girishji/tmr-keyboard/README.md

# tmr-keyboard
Custom keyboard based on TMR sensor
