girishji/tmr-keyboard/hardware/resources/Kailh-CPG1353C01D01-03.pdf

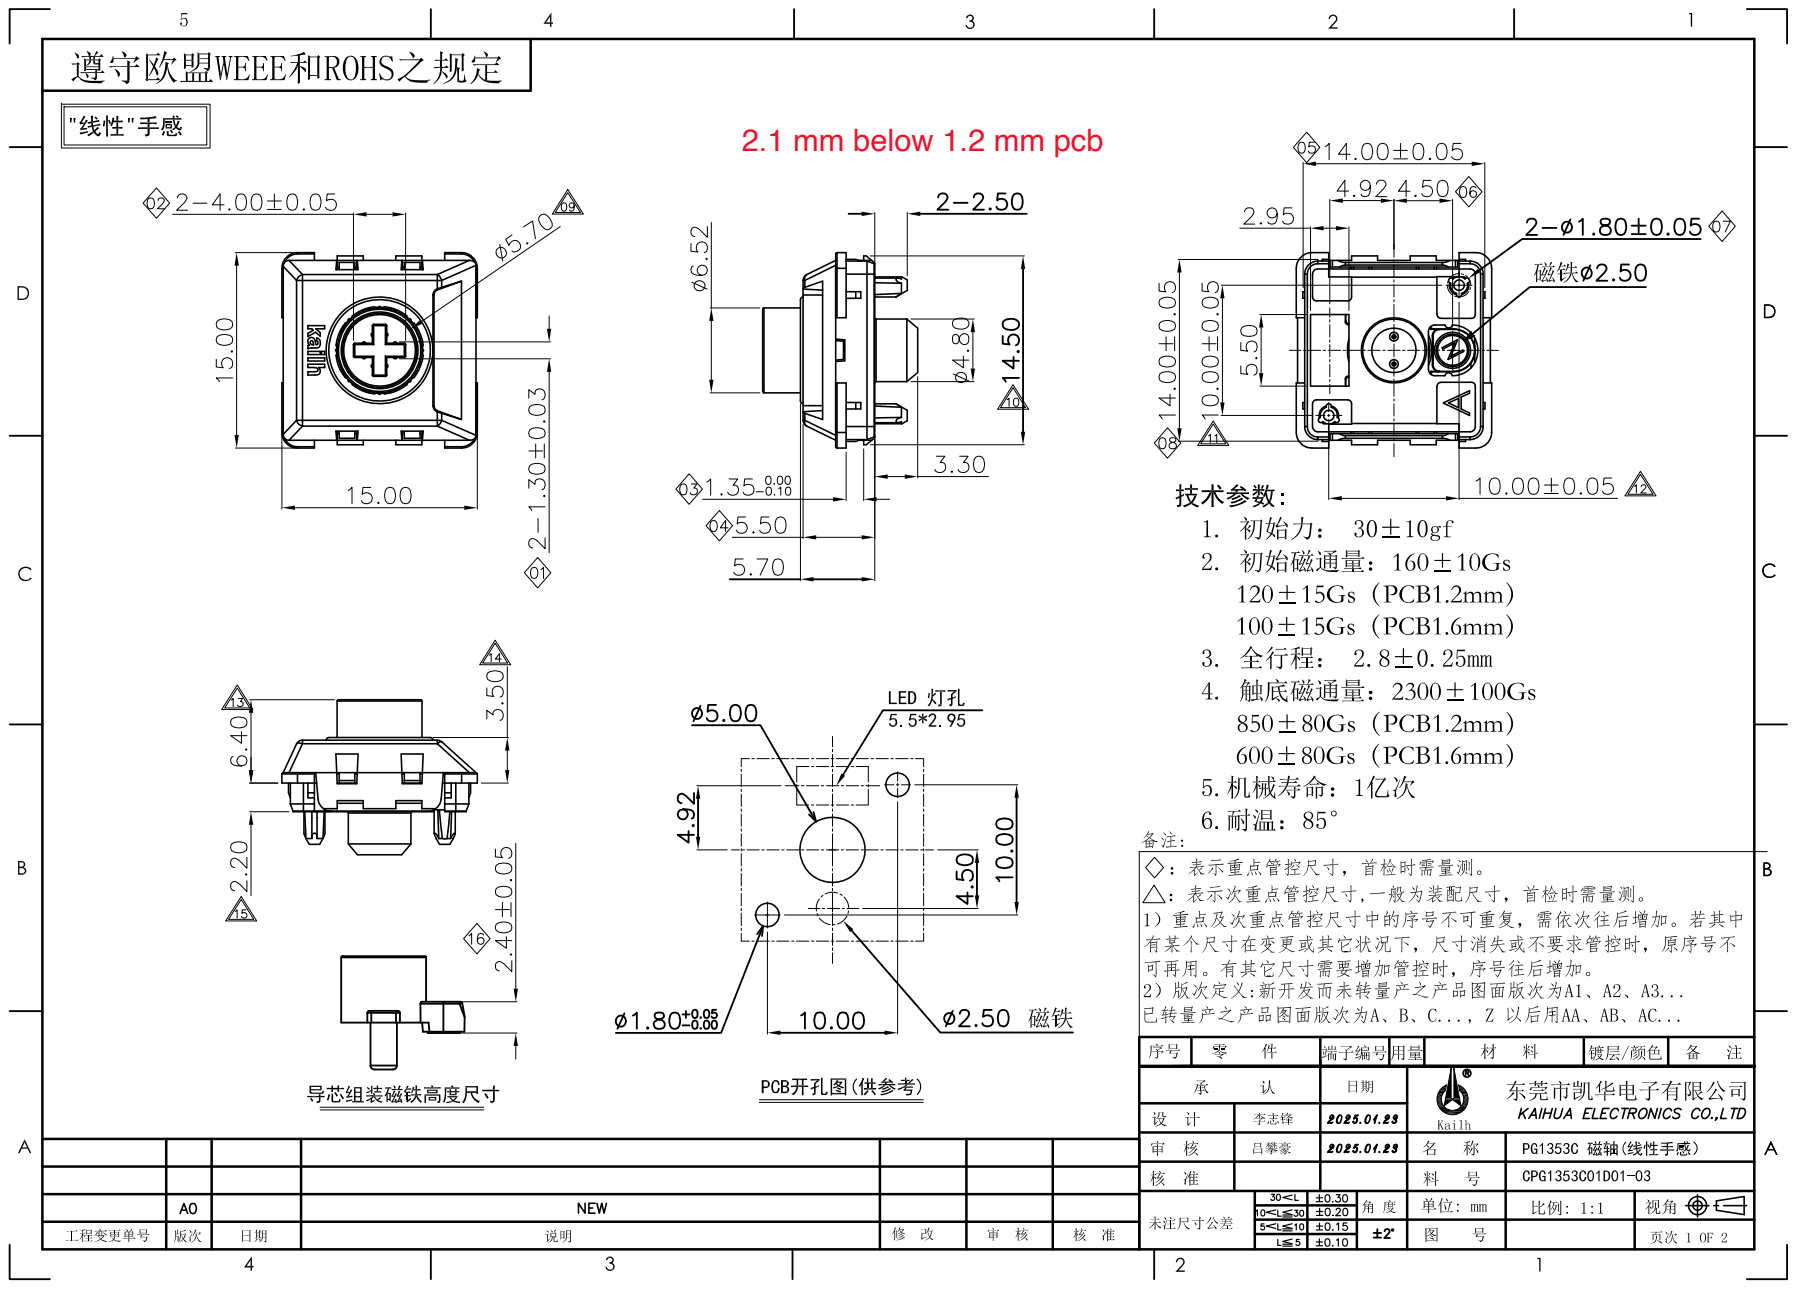
[picture p1: page 1]

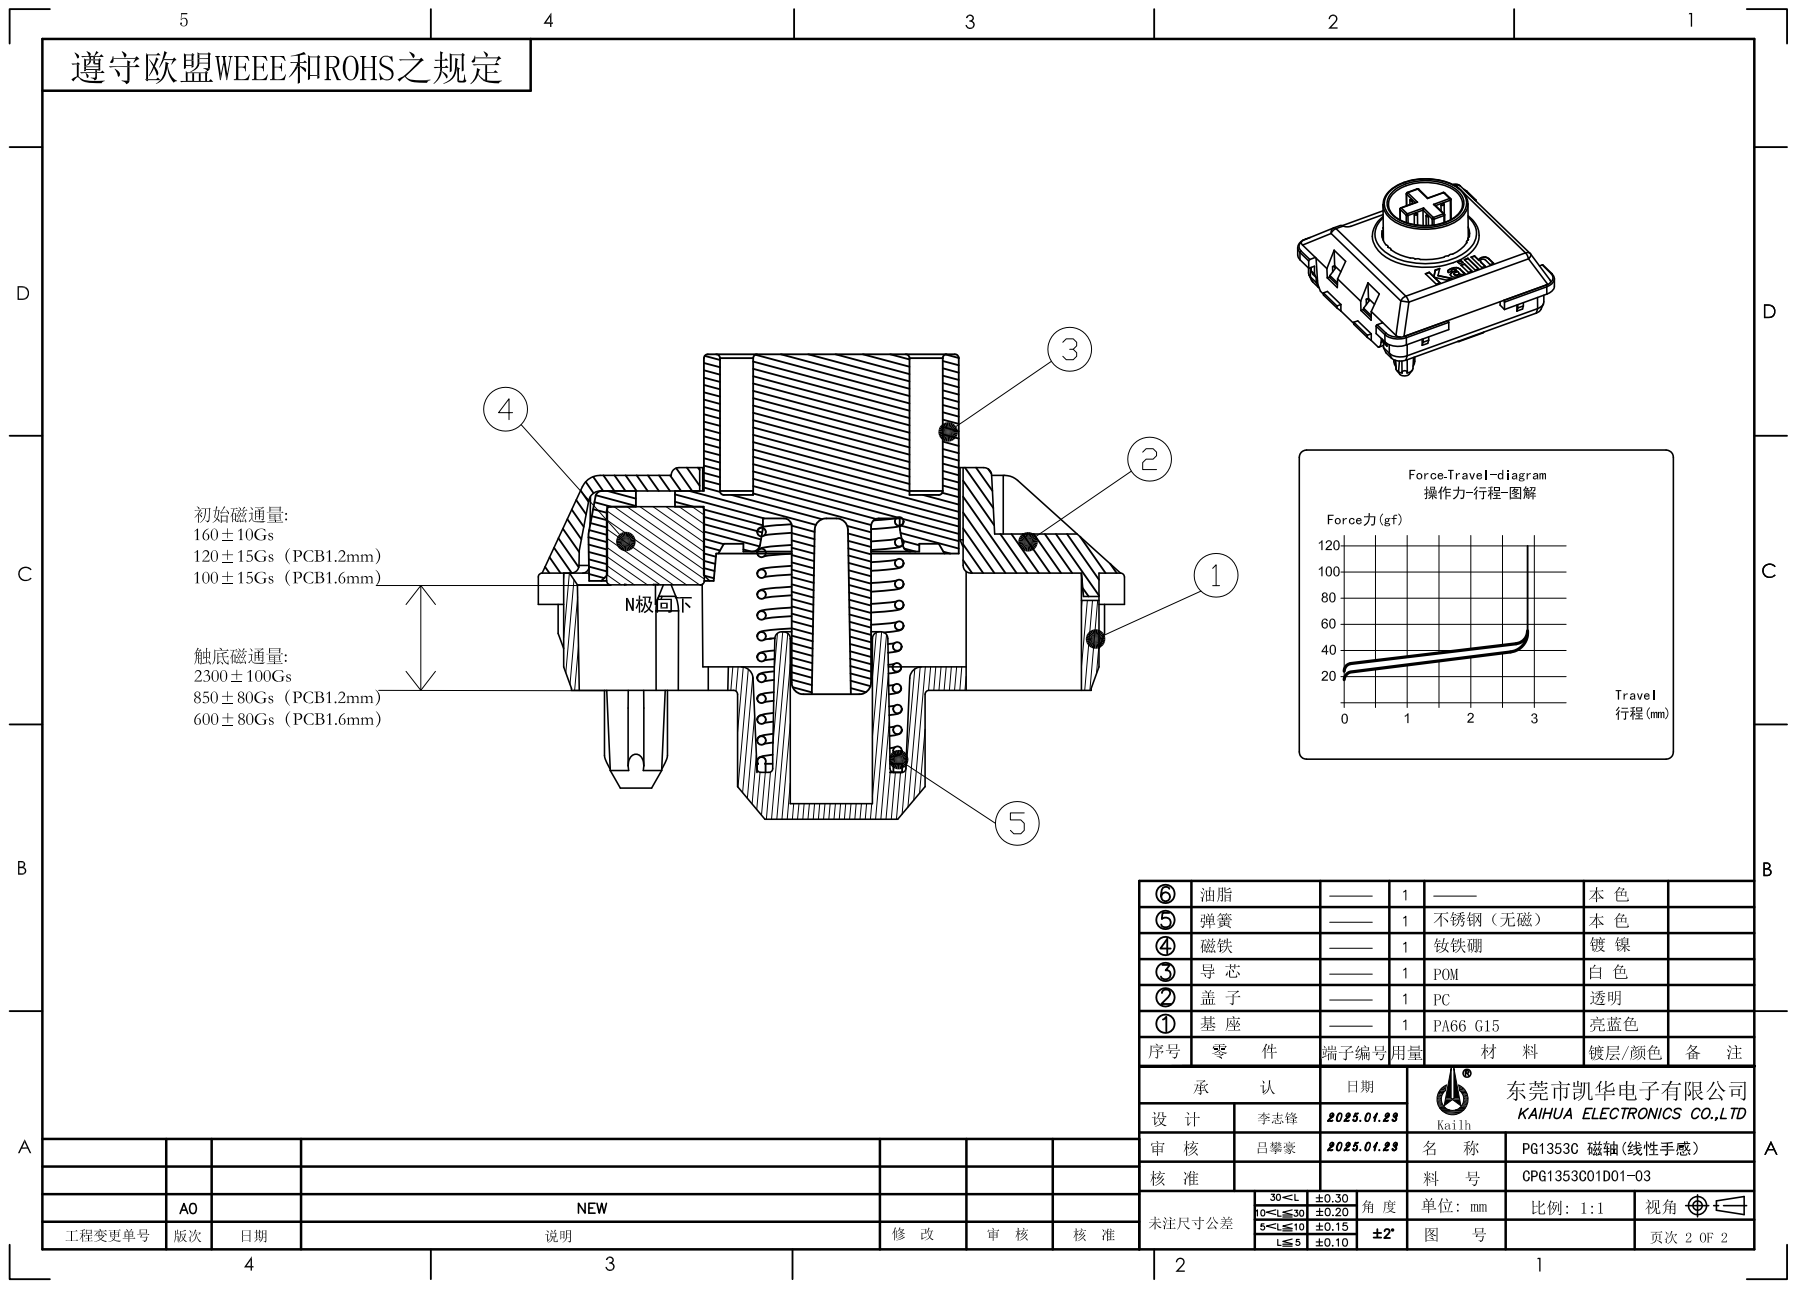
[picture p2: page 2]

## PG1353C Push Switch 料号: CPG1353C01D01-03

1. General specification 基本事项
1.1 Switch action | : Push-on type S. P. S. T
开关种类 | : 按键开关
1.2 Operation temperature range 使用温度试验范围 : - 40℃ ～ +70℃
1.3 Storage temperature range 保存温度范围 | : - 40℃ ～ + 80℃
1.4 Suggested storage period 贮存期限 : about 6 months 最多六个月
1.5 Appearance and dimensions 外形及尺寸 | : See outside drawing page 见外形尺寸图
1.6 Standard condition | Unless otherwise specified, the test and measurements shall be
试验、测定状态 | carried out as follows:
Ambient temperature 温 度: 20±2℃
Ｒelative humidity 相对湿度: 45% ～ 85%
Air pressure 气 压: 86 ～ 106kPa(860～1060mbar)
However, if doubt arises on the decision based on the measured
Values under the above-mentioned conditions, the following conditions shall be employed: 但是在对判定产生疑义时,按下述状态实施:
Ambient temperature 温 度:20±2℃ | Relative humidity 相对湿度: 65±5％
Air pressure 气 压: 86 ～ 106kPa(860～1060mbar)
2. Performance 性能
2.1 Mechanical Characteristics 机械性能
No. | Item 项目 | Test condition 试验条件 | Performance 规格

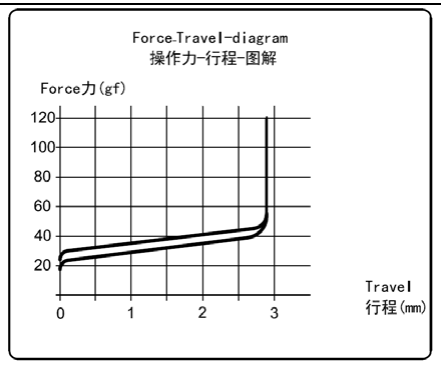
[picture p3: figure]

2.1.1 | Initial force 初始力 Travel to closure 动作行程（见 图表） | | Initial force 初始力 30±10gf Full Travel: 2.8mm±0.25 Initial magnetic induction: 自由状态磁感应强度: 120±15Gs（PCB1.2mm） 100±15Gs（PCB1.6mm） Push to full magnetic induction: 按压到全行程状态磁感应强 度: 850±80Gs（PCB1.2mm） 600±80Gs（PCB1.6mm）
2.1.2 | Push strength 按压强度 | 10N(1Kgf)for 15 sec 10N(1Kgf) 15 秒 | No damage (Electricaland mechanical) 无异常(电气、机械性能)
2.1.3 | Pull strength 拉拔强度 | Break by drawing push plate in the direction of right diagram 抽拔推杆使其破坏的强度. | 30N min (3kgf min)

2.2 Climatic characteristics 耐候性能
No. | Item 项目 | Test condition 试验条件 | Performance 规格
2.2.1 | Cold test 耐寒性 | 1) Temperature : - 40±2℃ 温度：- 40±2℃ 2) Duration of test: 48h 持续时间：48 小时 3) Take off a drop water 去掉水珠 4) Standard conditions after test : 1h 试验后的放置条件：1 小时 | No damage (Electricaland mechanical) 无异常(电气、机械性能)
2.2.2 | Heat test 耐热性 | 1) Temperature : 70±2℃ 温度： 70±2℃ 2) Duration of test: 48h 持续时间：48 小时 3) Standard conditions after test : 1h 试验后的放置条件：1 小时 | No damage (Electricaland mechanical) 无异常(电气、机械性能)
2.2.3 | Temperature cycle 温度循环 | 1) Test cycles :20 cycles 试验周期：20 个周期 2) Standard condition after test :1h 试验后的放置条件：1 小时 | No damage (Electricaland mechanical) 无异常(电气、机械性能)
| temperature 温度 | duration of test 持续时间
1 cycle 一次 循环 | 20±5℃ | 1h
| -40±2℃ | 1h
| 20±5℃ | 1h
| 60±5℃ | 1h
2.2.4 | Humidity test 耐湿性
1) Temperature : 70±2℃
温度：70±2℃
2) relative humidity: 90~95% 相对湿度:90~95%
3) Duration of test: 96h
持续时间：96 小时
3) Take off a drop water
去掉水珠
5) Standard conditions after test : 1h 试验后的放置条件：1 小时

No damage
(Electricaland
mechanical)
无异常(电气、机械性能)).

No. | Item 项目 | Test condition试验条件 | Performance 规格
2.2.5 | Endurance (switching action) 耐久特性 （开关寿命） | 1) Operation speed :10 times / s 动作速度：10 次/ 秒 2) Push force : 250gf±50gf （spring） 按力: 250gf±50gf（弹簧） 3) Operation number:100,000,000cycles 动作次数:100，000，000次 | No damage (Electricaland mechanical) 无异常(电气、机械性能)
2.2.6 | 盐雾实验 Salt Mist Test | 试件在下述实验后测量： 1．温度：35±5ºC 2．盐溶液浓度：5±1%（质量百分比）， 3．试验时间：24±0.5 小时， 4．试验后，将盐沉积物用水冲掉。 The switch shall be checked after following test: 1.Temperature: 35±5ºC 2.Salt solution: 5±1%(Solids by mass) 3.Duration: 24±0.5 hours, 4.After immersing, salt deposit shall be removed by running water. | No damage (Electricaland mechanical) 无异常(电气、机械性能)
2.2.7 | Shock 耐冲击性 | Measure after test at a condition below 在下列条件下进行测试后的量度 Peak acceleration:80G 冲击加速度:80G Test time-6direction ,each 3 times total 18 times 测试次数-6 个方向，各3 次共计18 次。 | No damage (Electricaland mechanical) 无异常(电气、机械性能)
