girishji/tmr-keyboard/hardware/nRF54L15_kailh/pcb/pcb-F_Fab.dxf

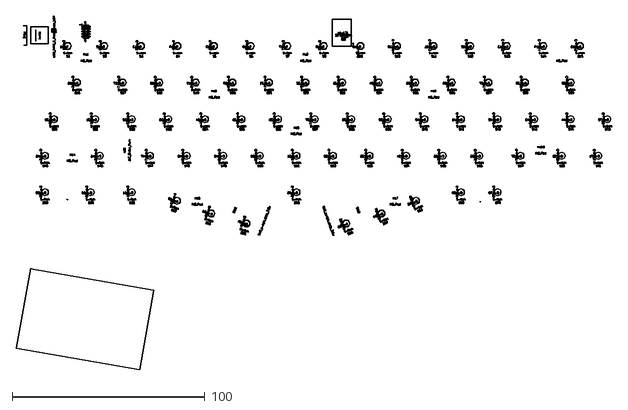
[picture p4: CAD file, 2026-02-25]
hardware/nRF54L15_kailh/pcb/pcb-F_Fab.dxf
309.1 x 183.6
