girishji/tmr-keyboard/ver2/pcb/dxf/pcb-Edge_Cuts.dxf

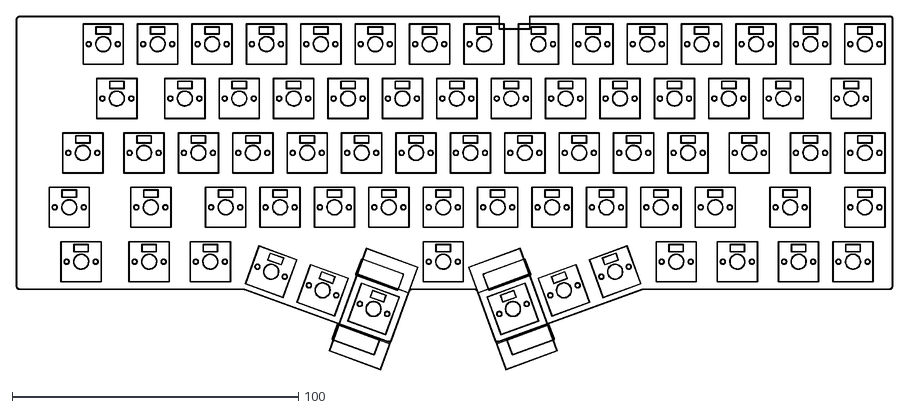
[picture p5: CAD file, 2026-01-05]
ver2/pcb/dxf/pcb-Edge_Cuts.dxf
305.9 x 123.3
