girishji/tmr-keyboard/hardware/nRF54L15_kailh/pcb/pcb-User_5.dxf

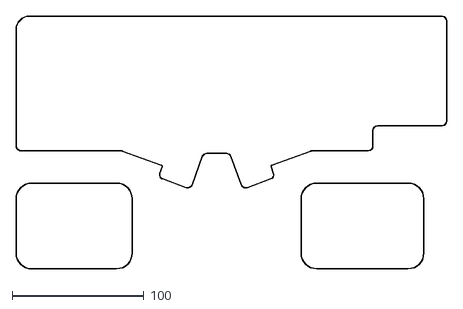
[picture p6: CAD file, 2026-02-15]
hardware/nRF54L15_kailh/pcb/pcb-User_5.dxf
326.5 x 191.5
