girishji/tmr-keyboard/hardware/nRF54L15_kailh/pcb/pcb-User_6.dxf

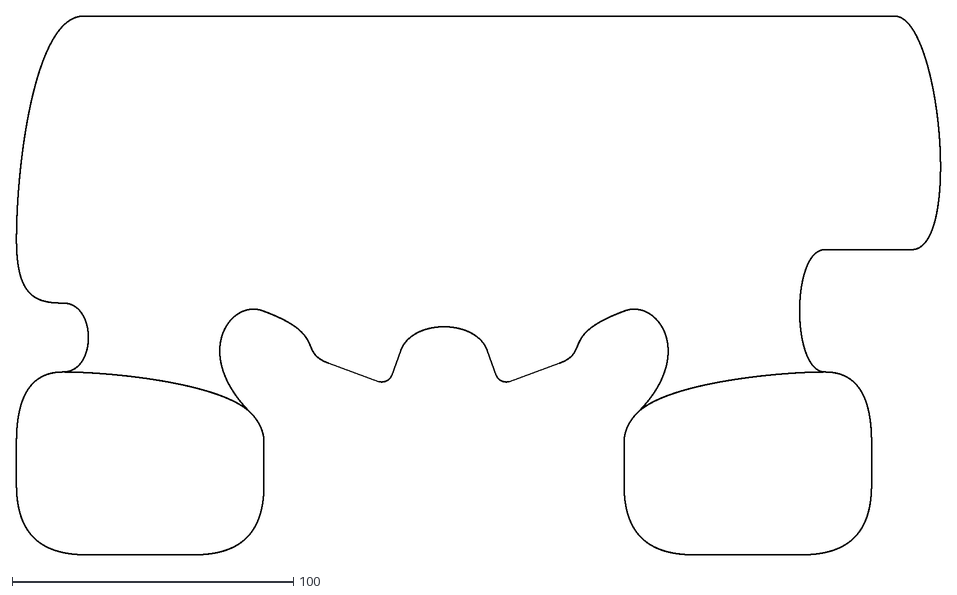
[picture p7: CAD file, 2026-02-15]
hardware/nRF54L15_kailh/pcb/pcb-User_6.dxf
328.5 x 191.5
