girishji/tmr-keyboard/hardware/nRF54L15_kailh/pcb/pcb-User_3.dxf

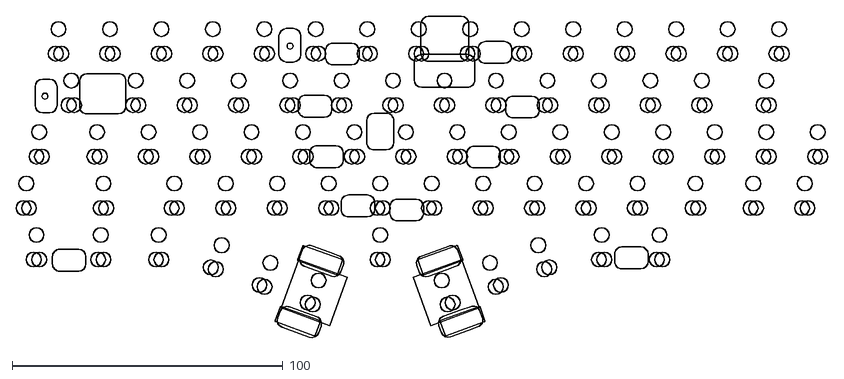
[picture p8: CAD file, 2026-02-15]
hardware/nRF54L15_kailh/pcb/pcb-User_3.dxf
299.6 x 118.9
