girishji/tmr-keyboard/hardware/nRF54L15_kailh/pcb/pcb-Edge_Cuts.dxf

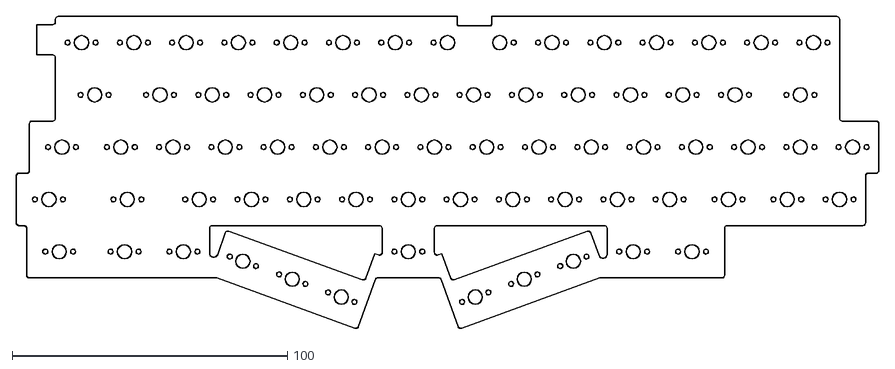
[picture p9: CAD file, 2026-02-15]
hardware/nRF54L15_kailh/pcb/pcb-Edge_Cuts.dxf
313.5 x 113.4
