girishji/tmr-keyboard/hardware/nRF54L15_TMR2615_sm_kailh/botcase/botcase-Edge_Cuts.pdf

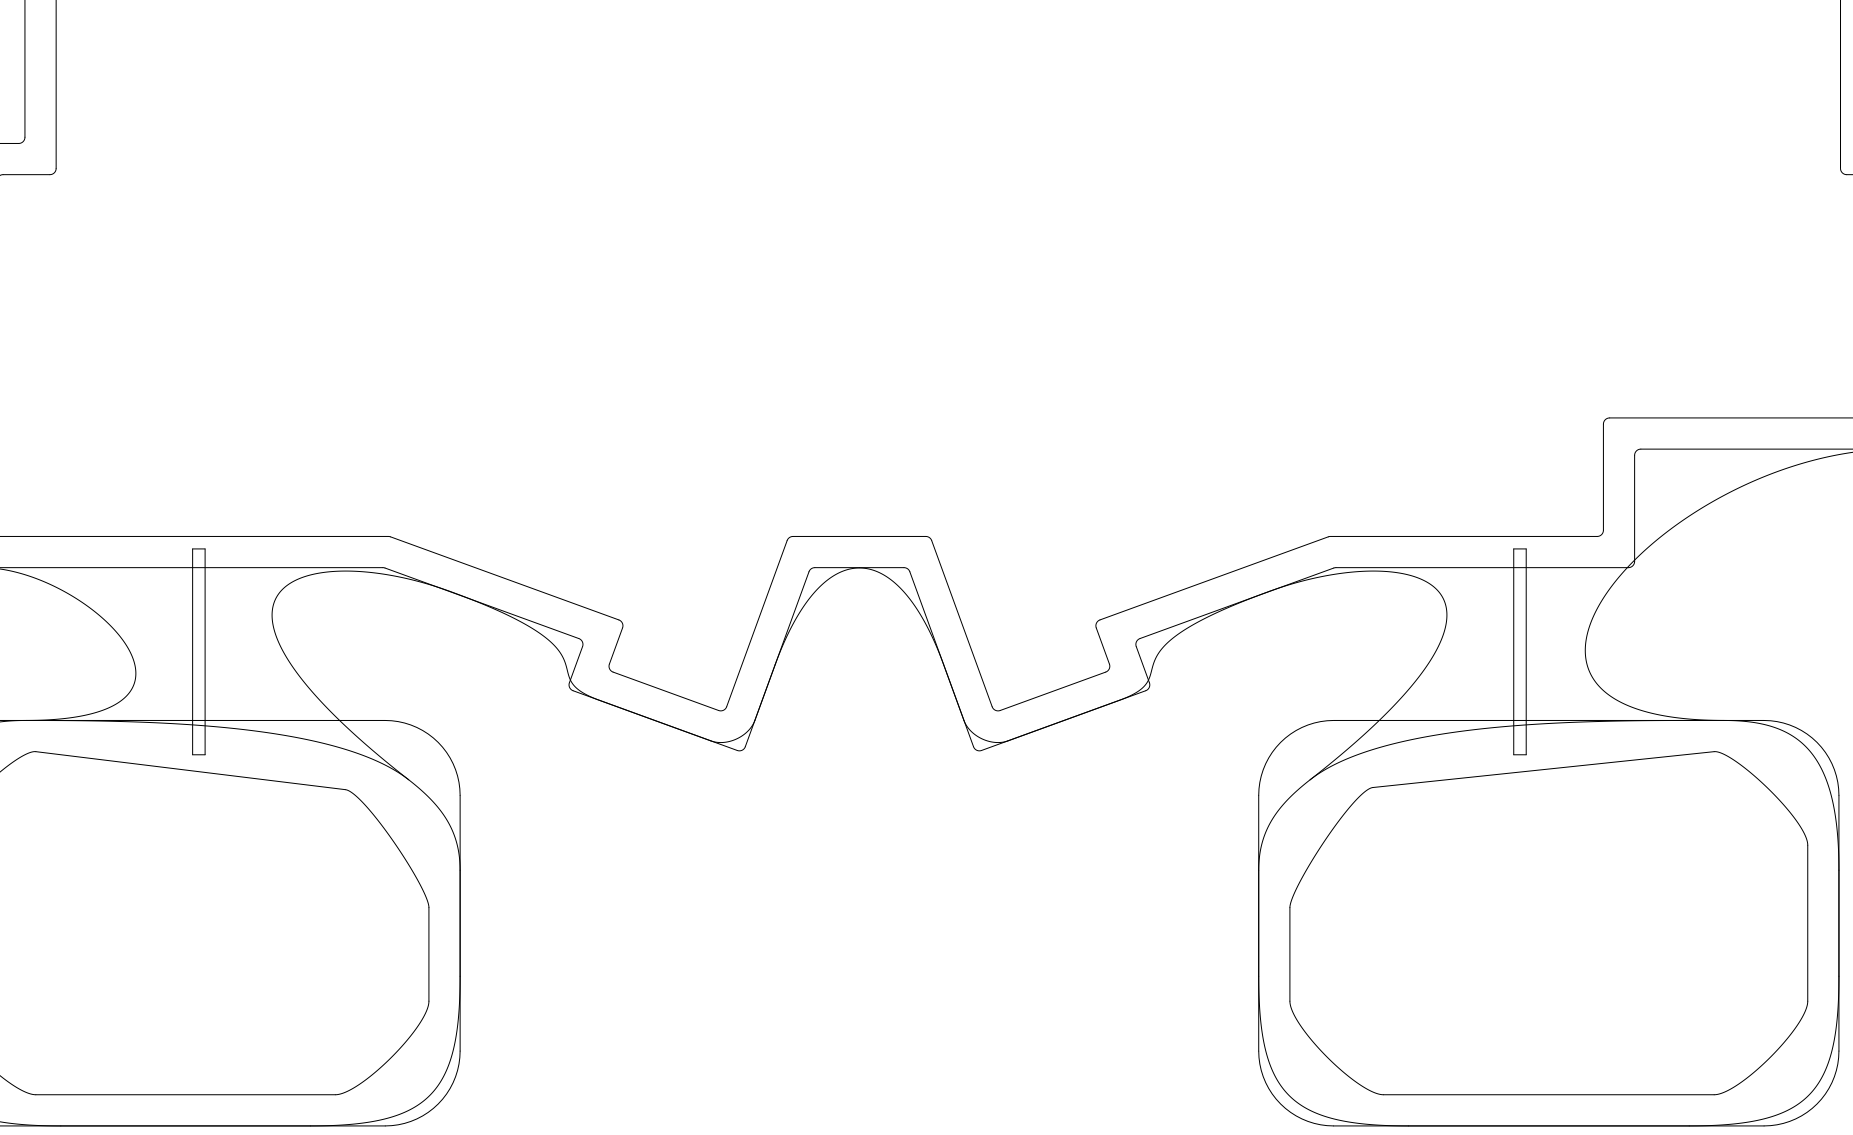
[picture p10: page 1]
