girishji/tmr-keyboard/hardware/nRF54LM20_TMR2615/pcb/pcb.kicad_pcb

## KiCad design hardware/nRF54LM20_TMR2615/pcb/pcb.kicad_pcb (2026-10-20)

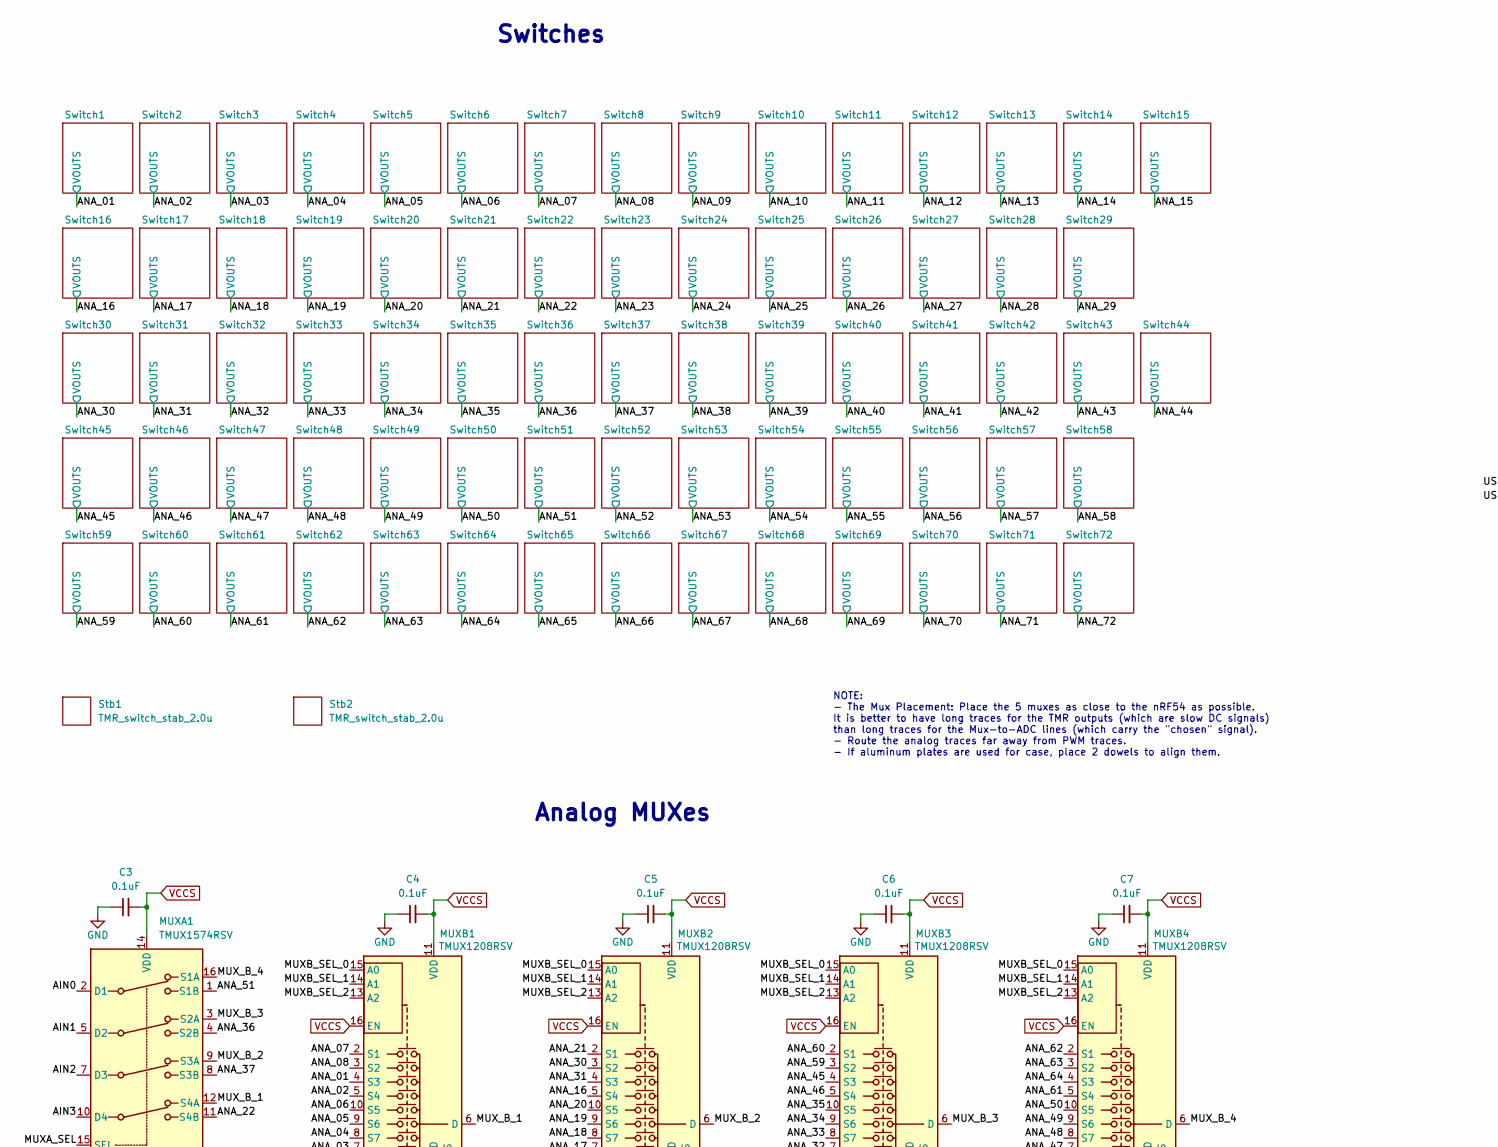
[picture p11: schematic pcb.kicad_sch, part in row 1, column 1]

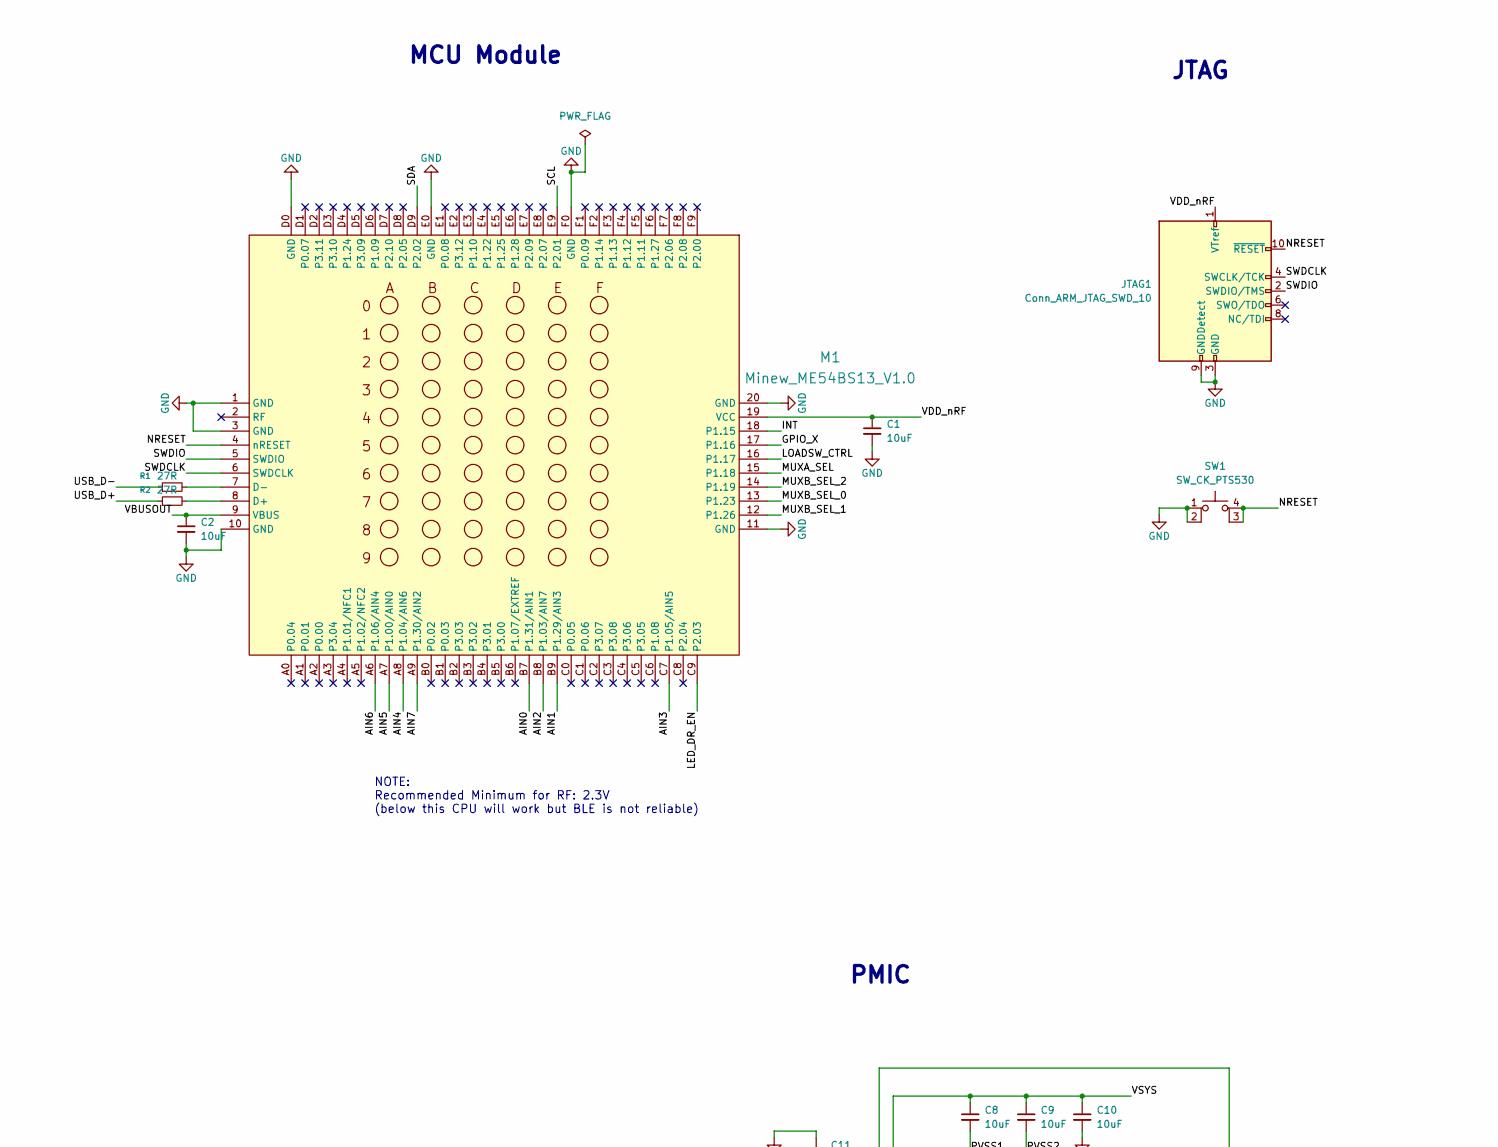
[picture p12: schematic pcb.kicad_sch, part in row 1, column 2]

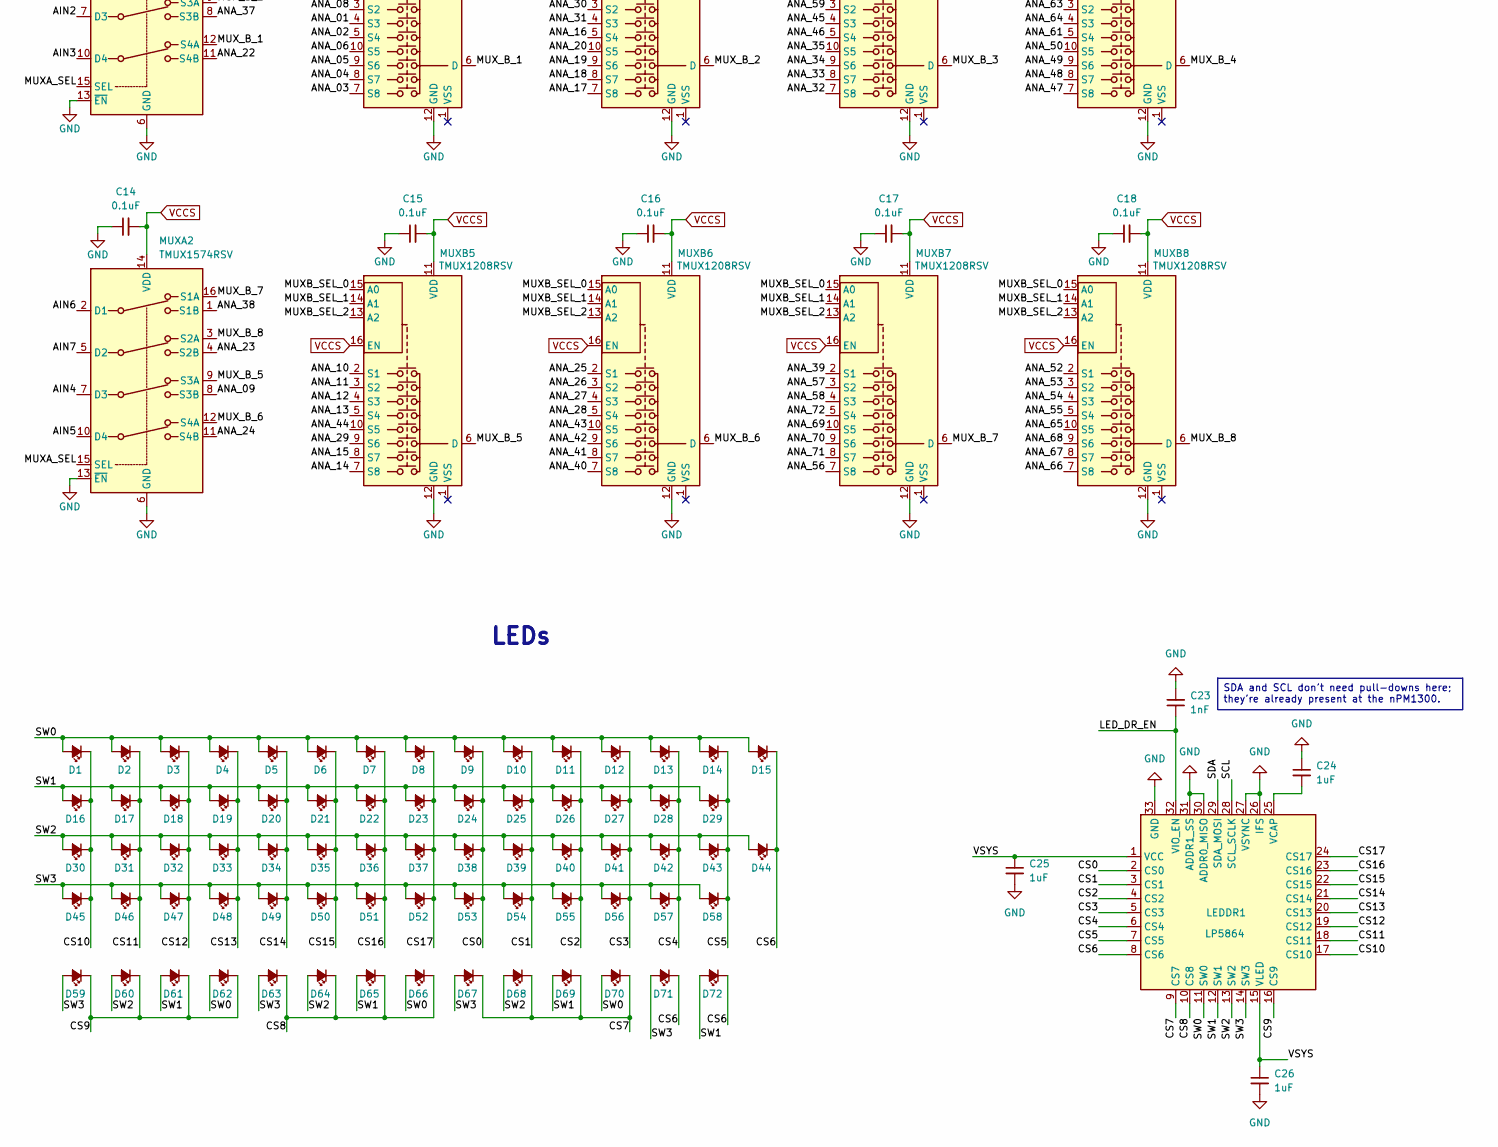
[picture p13: schematic pcb.kicad_sch, part in row 2, column 1]

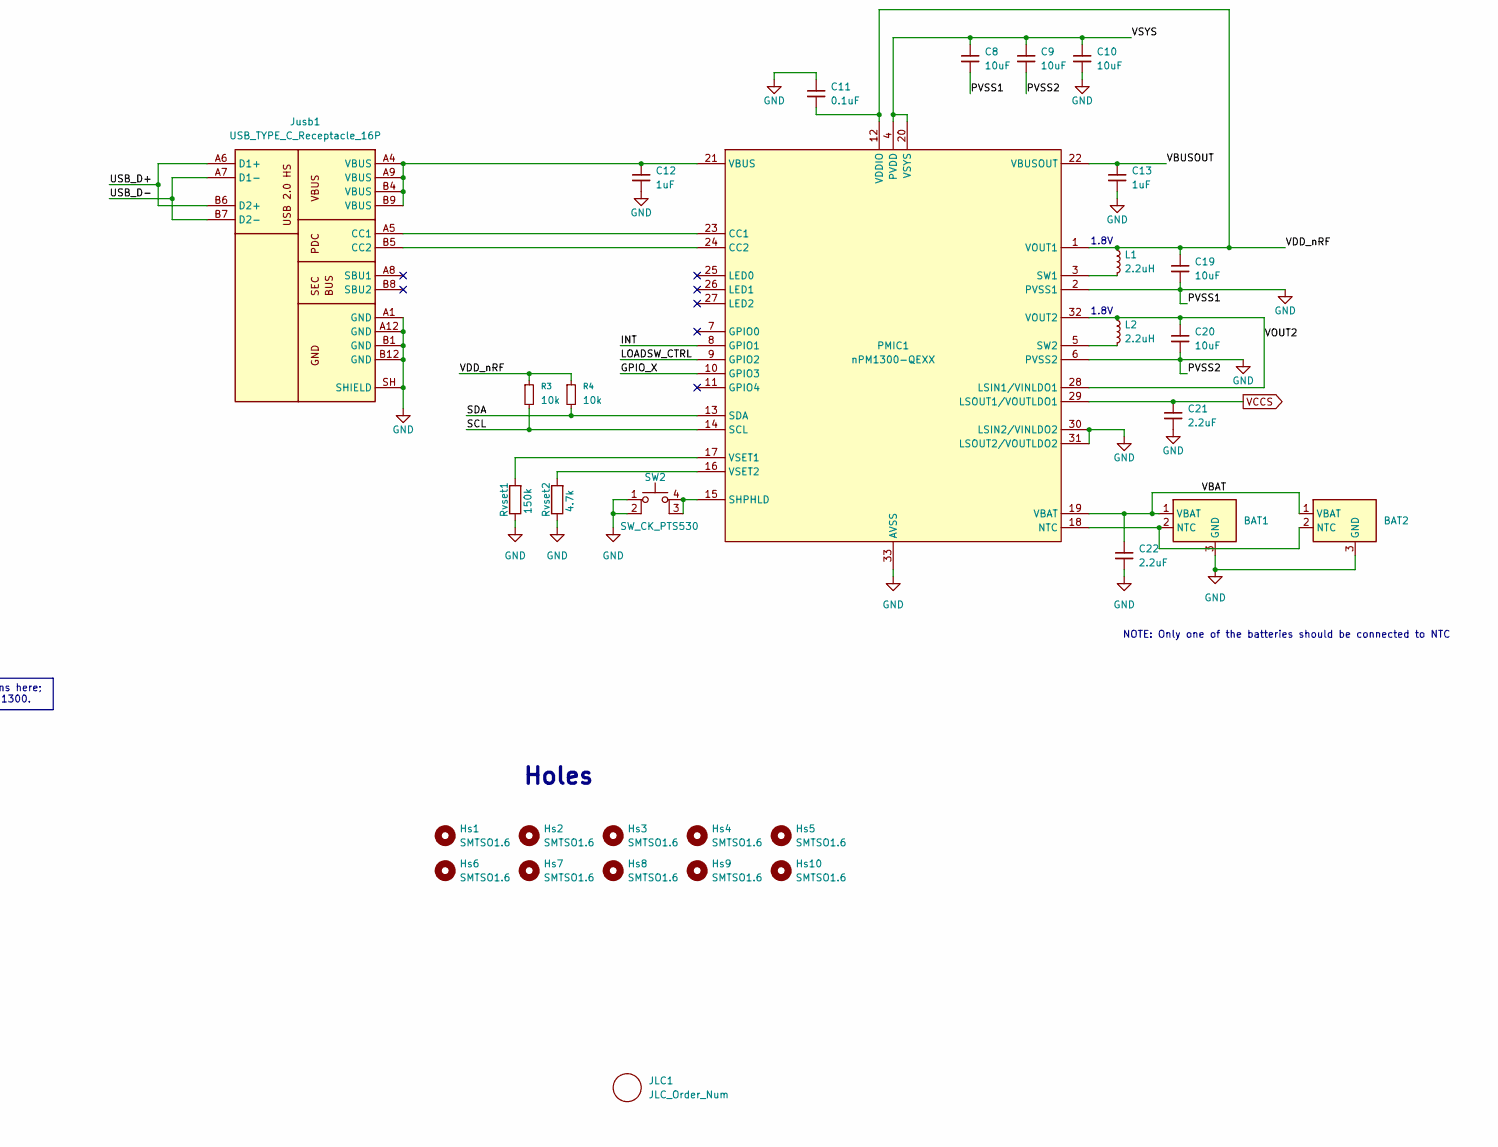
[picture p14: schematic pcb.kicad_sch, part in row 2, column 2]

Parts:
BAT1, BAT2: PCB_Wire_Solder_3p_Connector
C1, C2, C8, C9, C10, C19, C20: 10uF; C_0603_1608Metric; LCSC C96446
C3, C4, C5, C6, C7, C11, C14, C15, C16, C17, C18: 0.1uF; C_0402_1005Metric; LCSC C129131
C12, C13, C24, C25, C26: 1uF; C_0402_1005Metric; LCSC C14445
C21, C22: 2.2uF; C_0603_1608Metric; LCSC C57895
C23: 1nF; C_0402_1005Metric; LCSC C710873
D1, D2, D3, D4, D5, D6, D7, D8, D9, D10, D11, D12, D13, D14, D15, D16, D17, D18, D19, D20, D21, D22, D23, D24, D25, D26, D27, D28, D29, D30, D31, D32, D33, D34, D35, D36, D37, D38, D39, D40, D41, D42, D43, D44, D45, D46, D47, D48, D49, D50, D51, D52, D53, D54, D55, D56, D57, D58, D59, D60, D61, D62, D63, D64, D65, D66, D67, D68, D69, D70, D71, D72: LED; LED_1206_3216Metric_ReverseMount_Hole2.1mm; LCSC C401114
Hs1, Hs2, Hs3, Hs4, Hs5, Hs6, Hs7, Hs8, Hs9, Hs10: SMTSO1.6; SMTSO_M1.6; LCSC C42924166
JLC1: JLC_Order_Num
JTAG1: Conn_ARM_JTAG_SWD_10; SAMTEC-CLP-105-02-X-D-A; LCSC C6882278
Jusb1: USB_TYPE_C_Receptacle_16P; USB_C_Receptacle_XKB_U262-16XN-4BVC11; MPN U262-161N-4BVC11; LCSC C319148
L1, L2: 2.2uH; L_Samsung_CIGT201610EH2R2MNE; LCSC C2049745
LEDDR1: LP5864; LP5864-VQFN-32-1EP_4x4mm_P0.4mm_EP2.8x2.8mm_ThermalVias; LCSC C5220564
M1: Minew_ME54BS13_V1.0; Minew_ME54BS13; LCSC C9900300294
MUXA1, MUXA2: TMUX1574RSV; UQFN-16_1.8x2.6mm_P0.4mm; LCSC C2673120
MUXB1, MUXB2, MUXB3, MUXB4, MUXB5, MUXB6, MUXB7, MUXB8: TMUX1208RSV; UQFN-16_1.8x2.6mm_P0.4mm; LCSC C2673274
PMIC1: nPM1300-QEXX; QFN-32-1EP_5x5mm_P0.5mm_EP3.6x3.6mm_ThermalVias; LCSC C25346894
R1, R2: 27R; R_0402_1005Metric; LCSC C25100
R3, R4: 10k; R_0402_1005Metric; LCSC C25744
Rvset1: 150k; R_0402_1005Metric; LCSC C25755
Rvset2: 4.7k; R_0402_1005Metric; LCSC C25900
SW1, SW2: SW_CK_PTS530; SW_CK_PTS530_4.5x4.5x0.55mm; LCSC C221860
Stb1, Stb2: TMR_switch_stab_2.0u; Stabilizer_Lowpro_2U

Connections:
/AIN0: M1.B7 (P1.31/AIN1), MUXA1.2 (D1)
/AIN1: M1.B9 (P1.29/AIN3), MUXA1.5 (D2)
/AIN2: M1.B8 (P1.03/AIN7), MUXA1.7 (D3)
/AIN3: M1.C7 (P1.05/AIN5), MUXA1.10 (D4)
/AIN4: M1.A8 (P1.04/AIN6), MUXA2.7 (D3)
/AIN5: M1.A7 (P1.00/AIN0), MUXA2.10 (D4)
/AIN6: M1.A6 (P1.06/AIN4), MUXA2.2 (D1)
/AIN7: M1.A9 (P1.30/AIN2), MUXA2.5 (D2)
/ANA_01: MUXB1.4 (S3); also elsewhere on the board
/ANA_02: MUXB1.5 (S4); also elsewhere on the board
/ANA_03: MUXB1.7 (S8); also elsewhere on the board
/ANA_04: MUXB1.8 (S7); also elsewhere on the board
/ANA_05: MUXB1.9 (S6); also elsewhere on the board
/ANA_06: MUXB1.10 (S5); also elsewhere on the board
/ANA_07: MUXB1.2 (S1); also elsewhere on the board
/ANA_08: MUXB1.3 (S2); also elsewhere on the board
/ANA_09: MUXA2.8 (S3B); also elsewhere on the board
/ANA_10: MUXB5.2 (S1); also elsewhere on the board
/ANA_11: MUXB5.3 (S2); also elsewhere on the board
/ANA_12: MUXB5.4 (S3); also elsewhere on the board
/ANA_13: MUXB5.5 (S4); also elsewhere on the board
/ANA_14: MUXB5.7 (S8); also elsewhere on the board
/ANA_15: MUXB5.8 (S7); also elsewhere on the board
/ANA_16: MUXB2.5 (S4); also elsewhere on the board
/ANA_17: MUXB2.7 (S8); also elsewhere on the board
/ANA_18: MUXB2.8 (S7); also elsewhere on the board
/ANA_19: MUXB2.9 (S6); also elsewhere on the board
/ANA_20: MUXB2.10 (S5); also elsewhere on the board
/ANA_21: MUXB2.2 (S1); also elsewhere on the board
/ANA_22: MUXA1.11 (S4B); also elsewhere on the board
/ANA_23: MUXA2.4 (S2B); also elsewhere on the board
/ANA_24: MUXA2.11 (S4B); also elsewhere on the board
/ANA_25: MUXB6.2 (S1); also elsewhere on the board
/ANA_26: MUXB6.3 (S2); also elsewhere on the board
/ANA_27: MUXB6.4 (S3); also elsewhere on the board
/ANA_28: MUXB6.5 (S4); also elsewhere on the board
/ANA_29: MUXB5.9 (S6); also elsewhere on the board
/ANA_30: MUXB2.3 (S2); also elsewhere on the board
/ANA_31: MUXB2.4 (S3); also elsewhere on the board
/ANA_32: MUXB3.7 (S8); also elsewhere on the board
/ANA_33: MUXB3.8 (S7); also elsewhere on the board
/ANA_34: MUXB3.9 (S6); also elsewhere on the board
/ANA_35: MUXB3.10 (S5); also elsewhere on the board
/ANA_36: MUXA1.4 (S2B); also elsewhere on the board
/ANA_37: MUXA1.8 (S3B); also elsewhere on the board
/ANA_38: MUXA2.1 (S1B); also elsewhere on the board
/ANA_39: MUXB7.2 (S1); also elsewhere on the board
/ANA_40: MUXB6.7 (S8); also elsewhere on the board
/ANA_41: MUXB6.8 (S7); also elsewhere on the board
/ANA_42: MUXB6.9 (S6); also elsewhere on the board
/ANA_43: MUXB6.10 (S5); also elsewhere on the board
/ANA_44: MUXB5.10 (S5); also elsewhere on the board
/ANA_45: MUXB3.4 (S3); also elsewhere on the board
/ANA_46: MUXB3.5 (S4); also elsewhere on the board
/ANA_47: MUXB4.7 (S8); also elsewhere on the board
/ANA_48: MUXB4.8 (S7); also elsewhere on the board
/ANA_49: MUXB4.9 (S6); also elsewhere on the board
/ANA_50: MUXB4.10 (S5); also elsewhere on the board
/ANA_51: MUXA1.1 (S1B); also elsewhere on the board
/ANA_52: MUXB8.2 (S1); also elsewhere on the board
/ANA_53: MUXB8.3 (S2); also elsewhere on the board
/ANA_54: MUXB8.4 (S3); also elsewhere on the board
/ANA_55: MUXB8.5 (S4); also elsewhere on the board
/ANA_56: MUXB7.7 (S8); also elsewhere on the board
/ANA_57: MUXB7.3 (S2); also elsewhere on the board
/ANA_58: MUXB7.4 (S3); also elsewhere on the board
/ANA_59: MUXB3.3 (S2); also elsewhere on the board
/ANA_60: MUXB3.2 (S1); also elsewhere on the board
/ANA_61: MUXB4.5 (S4); also elsewhere on the board
/ANA_62: MUXB4.2 (S1); also elsewhere on the board
/ANA_63: MUXB4.3 (S2); also elsewhere on the board
/ANA_64: MUXB4.4 (S3); also elsewhere on the board
/ANA_65: MUXB8.10 (S5); also elsewhere on the board
/ANA_66: MUXB8.7 (S8); also elsewhere on the board
/ANA_67: MUXB8.8 (S7); also elsewhere on the board
/ANA_68: MUXB8.9 (S6); also elsewhere on the board
/ANA_69: MUXB7.10 (S5); also elsewhere on the board
/ANA_70: MUXB7.9 (S6); also elsewhere on the board
/ANA_71: MUXB7.8 (S7); also elsewhere on the board
/ANA_72: MUXB7.5 (S4); also elsewhere on the board
/CS0: D9.1 (K), D24.1 (K), D38.1 (K), D53.1 (K), LEDDR1.2 (CS0)
/CS1: D10.1 (K), D25.1 (K), D39.1 (K), D54.1 (K), LEDDR1.3 (CS1)
/CS2: D11.1 (K), D26.1 (K), D40.1 (K), D55.1 (K), LEDDR1.4 (CS2)
/CS3: D12.1 (K), D27.1 (K), D41.1 (K), D56.1 (K), LEDDR1.5 (CS3)
/CS4: D13.1 (K), D28.1 (K), D42.1 (K), D57.1 (K), LEDDR1.6 (CS4)
/CS5: D14.1 (K), D29.1 (K), D43.1 (K), D58.1 (K), LEDDR1.7 (CS5)
/CS6: D15.1 (K), D44.1 (K), D71.1 (K), D72.1 (K), LEDDR1.8 (CS6)
/CS7: D67.1 (K), D68.1 (K), D69.1 (K), D70.1 (K), LEDDR1.9 (CS7)
/CS8: D63.1 (K), D64.1 (K), D65.1 (K), D66.1 (K), LEDDR1.10 (CS8)
/CS9: D59.1 (K), D60.1 (K), D61.1 (K), D62.1 (K), LEDDR1.16 (CS9)
/CS10: D1.1 (K), D16.1 (K), D30.1 (K), D45.1 (K), LEDDR1.17 (CS10)
/CS11: D2.1 (K), D17.1 (K), D31.1 (K), D46.1 (K), LEDDR1.18 (CS11)
/CS12: D3.1 (K), D18.1 (K), D32.1 (K), D47.1 (K), LEDDR1.19 (CS12)
/CS13: D4.1 (K), D19.1 (K), D33.1 (K), D48.1 (K), LEDDR1.20 (CS13)
/CS14: D5.1 (K), D20.1 (K), D34.1 (K), D49.1 (K), LEDDR1.21 (CS14)
/CS15: D6.1 (K), D21.1 (K), D35.1 (K), D50.1 (K), LEDDR1.22 (CS15)
/CS16: D7.1 (K), D22.1 (K), D36.1 (K), D51.1 (K), LEDDR1.23 (CS16)
/CS17: D8.1 (K), D23.1 (K), D37.1 (K), D52.1 (K), LEDDR1.24 (CS17)
/GPIO_X: M1.17 (P1.16), PMIC1.10 (GPIO3)
/INT: M1.18 (P1.15), PMIC1.8 (GPIO1)
/LED_DR_EN: C23.1, LEDDR1.32 (VIO_EN), M1.C9 (P2.03)
/LOADSW_CTRL: M1.16 (P1.17), PMIC1.9 (GPIO2)
/MUXA_SEL: M1.15 (P1.18), MUXA1.15 (SEL), MUXA2.15 (SEL)
/MUXB_SEL_0: M1.13 (P1.23), MUXB1.15 (A0), MUXB2.15 (A0), MUXB3.15 (A0), MUXB4.15 (A0), MUXB5.15 (A0), MUXB6.15 (A0), MUXB7.15 (A0), MUXB8.15 (A0)
/MUXB_SEL_1: M1.12 (P1.26), MUXB1.14 (A1), MUXB2.14 (A1), MUXB3.14 (A1), MUXB4.14 (A1), MUXB5.14 (A1), MUXB6.14 (A1), MUXB7.14 (A1), MUXB8.14 (A1)
/MUXB_SEL_2: M1.14 (P1.19), MUXB1.13 (A2), MUXB2.13 (A2), MUXB3.13 (A2), MUXB4.13 (A2), MUXB5.13 (A2), MUXB6.13 (A2), MUXB7.13 (A2), MUXB8.13 (A2)
/MUX_B_1: MUXA1.12 (S4A), MUXB1.6 (D)
/MUX_B_2: MUXA1.9 (S3A), MUXB2.6 (D)
/MUX_B_3: MUXA1.3 (S2A), MUXB3.6 (D)
/MUX_B_4: MUXA1.16 (S1A), MUXB4.6 (D)
/MUX_B_5: MUXA2.9 (S3A), MUXB5.6 (D)
/MUX_B_6: MUXA2.12 (S4A), MUXB6.6 (D)
/MUX_B_7: MUXA2.16 (S1A), MUXB7.6 (D)
/MUX_B_8: MUXA2.3 (S2A), MUXB8.6 (D)
/NRESET: JTAG1.10 (~RESET), M1.4 (nRESET), SW1.3 (K), SW1.4 (A)
/SCL: LEDDR1.28 (SCL_SCLK), M1.E9 (P2.01), PMIC1.14 (SCL), R3.2
/SDA: LEDDR1.29 (SDA_MOSI), M1.D9 (P2.02), PMIC1.13 (SDA), R4.2
/SW0: D1.2 (A), D2.2 (A), D3.2 (A), D4.2 (A), D5.2 (A), D6.2 (A), D7.2 (A), D8.2 (A), D9.2 (A), D10.2 (A), D11.2 (A), D12.2 (A), D13.2 (A), D14.2 (A), D15.2 (A), D62.2 (A), D66.2 (A), D70.2 (A), LEDDR1.11 (SW0)
/SW1: D16.2 (A), D17.2 (A), D18.2 (A), D19.2 (A), D20.2 (A), D21.2 (A), D22.2 (A), D23.2 (A), D24.2 (A), D25.2 (A), D26.2 (A), D27.2 (A), D28.2 (A), D29.2 (A), D61.2 (A), D65.2 (A), D69.2 (A), D72.2 (A), LEDDR1.12 (SW1)
/SW2: D30.2 (A), D31.2 (A), D32.2 (A), D33.2 (A), D34.2 (A), D35.2 (A), D36.2 (A), D37.2 (A), D38.2 (A), D39.2 (A), D40.2 (A), D41.2 (A), D42.2 (A), D43.2 (A), D44.2 (A), D60.2 (A), D64.2 (A), D68.2 (A), LEDDR1.13 (SW2)
/SW3: D45.2 (A), D46.2 (A), D47.2 (A), D48.2 (A), D49.2 (A), D50.2 (A), D51.2 (A), D52.2 (A), D53.2 (A), D54.2 (A), D55.2 (A), D56.2 (A), D57.2 (A), D58.2 (A), D59.2 (A), D63.2 (A), D67.2 (A), D71.2 (A), LEDDR1.14 (SW3)
/SWDCLK: JTAG1.4 (SWCLK/TCK), M1.6 (SWDCLK)
/SWDIO: JTAG1.2 (SWDIO/TMS), M1.5 (SWDIO)
/USB_D+: Jusb1.A6 (D1+), Jusb1.B6 (D2+), R2.1
/USB_D-: Jusb1.A7 (D1-), Jusb1.B7 (D2-), R1.1
/VBAT: BAT1.1 (VBAT), BAT2.1 (VBAT), C22.1, PMIC1.19 (VBAT)
/VBUSOUT: C2.1, C13.1, M1.9 (VBUS), PMIC1.22 (VBUSOUT)
/VDD_nRF: C1.1, C11.2, C19.1, JTAG1.1 (VTref), L1.1, M1.19 (VCC), PMIC1.1 (VOUT1), PMIC1.12 (VDDIO), R3.1, R4.1
/VOUT2: C20.1, L2.1, PMIC1.28 (LSIN1/VINLDO1), PMIC1.32 (VOUT2)
/VSYS: C8.1, C9.1, C10.1, C25.1, C26.1, LEDDR1.1 (VCC), LEDDR1.15 (VLED), PMIC1.4 (PVDD), PMIC1.20 (VSYS)
GND: BAT1.3 (GND), BAT2.3 (GND), C1.2, C2.2, C3.1, C4.1, C5.1, C6.1, C7.1, C8.2, C9.2, C10.2, C11.1, C12.2, C13.2, C14.1, C15.1, C16.1, C17.1, C18.1, C19.2, C20.2, C21.2, C22.2, C23.2, C24.1, C25.2, C26.2, JTAG1.3 (GND), JTAG1.5 (GND), JTAG1.9 (GNDDetect), Jusb1.A1 (GND), Jusb1.A12 (GND), Jusb1.B1 (GND), Jusb1.B12 (GND), Jusb1.SH (SHIELD), LEDDR1.26 (IFS), LEDDR1.27 (VSYNC), LEDDR1.30 (ADDR0_MISO), LEDDR1.31 (ADDR1_SS), LEDDR1.33 (GND), M1.1 (GND), M1.3 (GND), M1.10 (GND), M1.11 (GND), M1.20 (GND), M1.D0 (GND), M1.E0 (GND), M1.F0 (GND), MUXA1.6 (GND), MUXA1.13 (~EN), MUXA2.6 (GND), MUXA2.13 (~EN), MUXB1.12 (GND), MUXB2.12 (GND), MUXB3.12 (GND), MUXB4.12 (GND), MUXB5.12 (GND), MUXB6.12 (GND), MUXB7.12 (GND), MUXB8.12 (GND), PMIC1.2 (PVSS1), PMIC1.6 (PVSS2), PMIC1.30 (LSIN2/VINLDO2), PMIC1.31 (LSOUT2/VOUTLDO2), PMIC1.33 (AVSS), Rvset1.1, Rvset2.1, SW1.1, SW1.2, SW2.1, SW2.2; also elsewhere on the board
unnamed: BAT1.2 (NTC), BAT2.2 (NTC), PMIC1.18 (NTC)
unnamed: Jusb1.A5 (CC1), PMIC1.23 (CC1)
unnamed: Jusb1.B5 (CC2), PMIC1.24 (CC2)
unnamed: C24.2, LEDDR1.25 (VCAP)
unnamed: M1.8 (D+), R2.2
unnamed: M1.7 (D-), R1.2
unnamed: PMIC1.15 (SHPHLD), SW2.3 (K), SW2.4 (A)
unnamed: L1.2, PMIC1.3 (SW1)
unnamed: L2.2, PMIC1.5 (SW2)
unnamed: C12.1, Jusb1.A4 (VBUS), Jusb1.A9 (VBUS), Jusb1.B4 (VBUS), Jusb1.B9 (VBUS), PMIC1.21 (VBUS)
unnamed: PMIC1.17 (VSET1), Rvset1.2
unnamed: PMIC1.16 (VSET2), Rvset2.2
VCCS: C3.2, C4.2, C5.2, C6.2, C7.2, C14.2, C15.2, C16.2, C17.2, C18.2, C21.1, MUXA1.14 (VDD), MUXA2.14 (VDD), MUXB1.11 (VDD), MUXB1.16 (EN), MUXB2.11 (VDD), MUXB2.16 (EN), MUXB3.11 (VDD), MUXB3.16 (EN), MUXB4.11 (VDD), MUXB4.16 (EN), MUXB5.11 (VDD), MUXB5.16 (EN), MUXB6.11 (VDD), MUXB6.16 (EN), MUXB7.11 (VDD), MUXB7.16 (EN), MUXB8.11 (VDD), MUXB8.16 (EN), PMIC1.29 (LSOUT1/VOUTLDO1); also elsewhere on the board

Notes on the sheet:
Holes
MCU Module
NOTE: Only one of the batteries should be connected to NTC
NOTE: Recommended Minimum for RF: 2.3V (below this CPU will work but BLE is not reliable)
1.8V
Analog MUXes
JTAG
LEDs
PMIC
NOTE: - The Mux Placement: Place the 5 muxes as close to the nRF54 as possible. It is better to have long traces for the TMR outputs (which are slow DC signals) than long traces for the Mux-to-ADC lines (which carry the "chosen" signal). - Route the analog traces far away from PWM traces. - If alum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
Switches
SDA and SCL don't need pull-downs here; they're already present at the nPM1300.

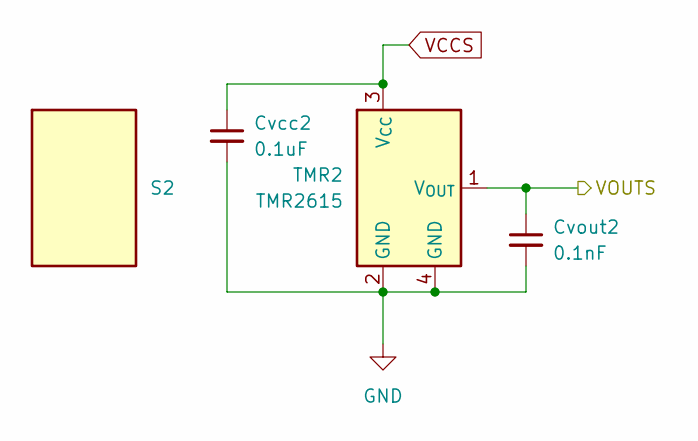
[picture p15: schematic switch.kicad_sch]

Parts:
Cvcc2: 0.1uF; C_0402_1005Metric_Cvcc; LCSC C129131
Cvout2: 0.1nF; C_0402_1005Metric_Cvout; LCSC C77177
S2: Switch; Kailh_gateron_sw_lowpro
TMR2: TMR2615; TMR2615-DFN-3L-1.6x1.6; LCSC C9900212297

Connections:
/ANA_02: Cvout2.1, TMR2.1 (V_{OUT}); also elsewhere on the board
GND: Cvcc2.2, Cvout2.2, TMR2.2 (GND), TMR2.4 (GND); also elsewhere on the board
VCCS: Cvcc2.1, TMR2.3 (V_{CC}); also elsewhere on the board

Parts of its further copies:
Cvcc1, Cvcc3, Cvcc4, Cvcc5, Cvcc6, Cvcc7, Cvcc8, Cvcc9, Cvcc10, Cvcc11, Cvcc12, Cvcc13, Cvcc14, Cvcc15, Cvcc16, Cvcc17, Cvcc18, Cvcc19, Cvcc20, Cvcc21, Cvcc22, Cvcc23, Cvcc24, Cvcc25, Cvcc26, Cvcc27, Cvcc28, Cvcc29, Cvcc30, Cvcc31, Cvcc32, Cvcc33, Cvcc34, Cvcc35, Cvcc36, Cvcc37, Cvcc38, Cvcc39, Cvcc40, Cvcc41, Cvcc42, Cvcc43, Cvcc44, Cvcc45, Cvcc46, Cvcc47, Cvcc48, Cvcc49, Cvcc50, Cvcc51, Cvcc52, Cvcc53, Cvcc54, Cvcc55, Cvcc56, Cvcc57, Cvcc58, Cvcc59, Cvcc60, Cvcc61, Cvcc62, Cvcc63, Cvcc64, Cvcc65, Cvcc66, Cvcc67, Cvcc68, Cvcc69, Cvcc70, Cvcc71, Cvcc72: 0.1uF; C_0402_1005Metric_Cvcc; LCSC C129131
Cvout1, Cvout3, Cvout4, Cvout5, Cvout6, Cvout7, Cvout8, Cvout9, Cvout10, Cvout11, Cvout12, Cvout13, Cvout14, Cvout15, Cvout16, Cvout17, Cvout18, Cvout19, Cvout20, Cvout21, Cvout22, Cvout23, Cvout24, Cvout25, Cvout26, Cvout27, Cvout28, Cvout29, Cvout30, Cvout31, Cvout32, Cvout33, Cvout34, Cvout35, Cvout36, Cvout37, Cvout38, Cvout39, Cvout40, Cvout41, Cvout42, Cvout43, Cvout44, Cvout45, Cvout46, Cvout47, Cvout48, Cvout49, Cvout50, Cvout51, Cvout52, Cvout53, Cvout54, Cvout55, Cvout56, Cvout57, Cvout58, Cvout59, Cvout60, Cvout61, Cvout62, Cvout63, Cvout64, Cvout65, Cvout66, Cvout67, Cvout68, Cvout69, Cvout70, Cvout71, Cvout72: 0.1nF; C_0402_1005Metric_Cvout; LCSC C77177
S1, S3, S4, S5, S6, S7, S8, S9, S10, S11, S12, S13, S14, S15, S16, S17, S18, S19, S20, S21, S22, S23, S24, S25, S26, S27, S28, S29, S30, S31, S32, S33, S34, S35, S36, S37, S38, S39, S40, S41, S42, S43, S44, S45, S46, S47, S48, S49, S50, S51, S52, S53, S54, S55, S56, S57, S58, S59, S60, S61, S62, S63, S64, S65, S66, S67, S68, S69, S70, S71, S72: Switch; Kailh_gateron_sw_lowpro
TMR1, TMR3, TMR4, TMR5, TMR6, TMR7, TMR8, TMR9, TMR10, TMR11, TMR12, TMR13, TMR14, TMR15, TMR16, TMR17, TMR18, TMR19, TMR20, TMR21, TMR22, TMR23, TMR24, TMR25, TMR26, TMR27, TMR28, TMR29, TMR30, TMR31, TMR32, TMR33, TMR34, TMR35, TMR36, TMR37, TMR38, TMR39, TMR40, TMR41, TMR42, TMR43, TMR44, TMR45, TMR46, TMR47, TMR48, TMR49, TMR50, TMR51, TMR52, TMR53, TMR54, TMR55, TMR56, TMR57, TMR58, TMR59, TMR60, TMR61, TMR62, TMR63, TMR64, TMR65, TMR66, TMR67, TMR68, TMR69, TMR70, TMR71, TMR72: TMR2615; TMR2615-DFN-3L-1.6x1.6; LCSC C9900212297

Connections of its further copies:
/ANA_01: Cvout1.1, TMR1.1 (V_{OUT}); also elsewhere on the board
/ANA_03: Cvout3.1, TMR3.1 (V_{OUT}); also elsewhere on the board
/ANA_04: Cvout4.1, TMR4.1 (V_{OUT}); also elsewhere on the board
/ANA_05: Cvout5.1, TMR5.1 (V_{OUT}); also elsewhere on the board
/ANA_06: Cvout6.1, TMR6.1 (V_{OUT}); also elsewhere on the board
/ANA_07: Cvout7.1, TMR7.1 (V_{OUT}); also elsewhere on the board
/ANA_08: Cvout8.1, TMR8.1 (V_{OUT}); also elsewhere on the board
/ANA_09: Cvout9.1, TMR9.1 (V_{OUT}); also elsewhere on the board
/ANA_10: Cvout10.1, TMR10.1 (V_{OUT}); also elsewhere on the board
/ANA_11: Cvout11.1, TMR11.1 (V_{OUT}); also elsewhere on the board
/ANA_12: Cvout12.1, TMR12.1 (V_{OUT}); also elsewhere on the board
/ANA_13: Cvout13.1, TMR13.1 (V_{OUT}); also elsewhere on the board
/ANA_14: Cvout14.1, TMR14.1 (V_{OUT}); also elsewhere on the board
/ANA_15: Cvout15.1, TMR15.1 (V_{OUT}); also elsewhere on the board
/ANA_16: Cvout16.1, TMR16.1 (V_{OUT}); also elsewhere on the board
/ANA_17: Cvout17.1, TMR17.1 (V_{OUT}); also elsewhere on the board
/ANA_18: Cvout18.1, TMR18.1 (V_{OUT}); also elsewhere on the board
/ANA_19: Cvout19.1, TMR19.1 (V_{OUT}); also elsewhere on the board
/ANA_20: Cvout20.1, TMR20.1 (V_{OUT}); also elsewhere on the board
/ANA_21: Cvout21.1, TMR21.1 (V_{OUT}); also elsewhere on the board
/ANA_22: Cvout22.1, TMR22.1 (V_{OUT}); also elsewhere on the board
/ANA_23: Cvout23.1, TMR23.1 (V_{OUT}); also elsewhere on the board
/ANA_24: Cvout24.1, TMR24.1 (V_{OUT}); also elsewhere on the board
/ANA_25: Cvout25.1, TMR25.1 (V_{OUT}); also elsewhere on the board
/ANA_26: Cvout26.1, TMR26.1 (V_{OUT}); also elsewhere on the board
/ANA_27: Cvout27.1, TMR27.1 (V_{OUT}); also elsewhere on the board
/ANA_28: Cvout28.1, TMR28.1 (V_{OUT}); also elsewhere on the board
/ANA_29: Cvout29.1, TMR29.1 (V_{OUT}); also elsewhere on the board
/ANA_30: Cvout30.1, TMR30.1 (V_{OUT}); also elsewhere on the board
/ANA_31: Cvout31.1, TMR31.1 (V_{OUT}); also elsewhere on the board
/ANA_32: Cvout32.1, TMR32.1 (V_{OUT}); also elsewhere on the board
/ANA_33: Cvout33.1, TMR33.1 (V_{OUT}); also elsewhere on the board
/ANA_34: Cvout34.1, TMR34.1 (V_{OUT}); also elsewhere on the board
/ANA_35: Cvout35.1, TMR35.1 (V_{OUT}); also elsewhere on the board
/ANA_36: Cvout36.1, TMR36.1 (V_{OUT}); also elsewhere on the board
/ANA_37: Cvout37.1, TMR37.1 (V_{OUT}); also elsewhere on the board
/ANA_38: Cvout38.1, TMR38.1 (V_{OUT}); also elsewhere on the board
/ANA_39: Cvout39.1, TMR39.1 (V_{OUT}); also elsewhere on the board
/ANA_40: Cvout40.1, TMR40.1 (V_{OUT}); also elsewhere on the board
/ANA_41: Cvout41.1, TMR41.1 (V_{OUT}); also elsewhere on the board
/ANA_42: Cvout42.1, TMR42.1 (V_{OUT}); also elsewhere on the board
/ANA_43: Cvout43.1, TMR43.1 (V_{OUT}); also elsewhere on the board
/ANA_44: Cvout44.1, TMR44.1 (V_{OUT}); also elsewhere on the board
/ANA_45: Cvout45.1, TMR45.1 (V_{OUT}); also elsewhere on the board
/ANA_46: Cvout46.1, TMR46.1 (V_{OUT}); also elsewhere on the board
/ANA_47: Cvout47.1, TMR47.1 (V_{OUT}); also elsewhere on the board
/ANA_48: Cvout48.1, TMR48.1 (V_{OUT}); also elsewhere on the board
/ANA_49: Cvout49.1, TMR49.1 (V_{OUT}); also elsewhere on the board
/ANA_50: Cvout50.1, TMR50.1 (V_{OUT}); also elsewhere on the board
/ANA_51: Cvout51.1, TMR51.1 (V_{OUT}); also elsewhere on the board
/ANA_52: Cvout52.1, TMR52.1 (V_{OUT}); also elsewhere on the board
/ANA_53: Cvout53.1, TMR53.1 (V_{OUT}); also elsewhere on the board
/ANA_54: Cvout54.1, TMR54.1 (V_{OUT}); also elsewhere on the board
/ANA_55: Cvout55.1, TMR55.1 (V_{OUT}); also elsewhere on the board
/ANA_56: Cvout56.1, TMR56.1 (V_{OUT}); also elsewhere on the board
/ANA_57: Cvout57.1, TMR57.1 (V_{OUT}); also elsewhere on the board
/ANA_58: Cvout58.1, TMR58.1 (V_{OUT}); also elsewhere on the board
/ANA_59: Cvout59.1, TMR59.1 (V_{OUT}); also elsewhere on the board
/ANA_60: Cvout60.1, TMR60.1 (V_{OUT}); also elsewhere on the board
/ANA_61: Cvout61.1, TMR61.1 (V_{OUT}); also elsewhere on the board
/ANA_62: Cvout62.1, TMR62.1 (V_{OUT}); also elsewhere on the board
/ANA_63: Cvout63.1, TMR63.1 (V_{OUT}); also elsewhere on the board
/ANA_64: Cvout64.1, TMR64.1 (V_{OUT}); also elsewhere on the board
/ANA_65: Cvout65.1, TMR65.1 (V_{OUT}); also elsewhere on the board
/ANA_66: Cvout66.1, TMR66.1 (V_{OUT}); also elsewhere on the board
/ANA_67: Cvout67.1, TMR67.1 (V_{OUT}); also elsewhere on the board
/ANA_68: Cvout68.1, TMR68.1 (V_{OUT}); also elsewhere on the board
/ANA_69: Cvout69.1, TMR69.1 (V_{OUT}); also elsewhere on the board
/ANA_70: Cvout70.1, TMR70.1 (V_{OUT}); also elsewhere on the board
/ANA_71: Cvout71.1, TMR71.1 (V_{OUT}); also elsewhere on the board
/ANA_72: Cvout72.1, TMR72.1 (V_{OUT}); also elsewhere on the board
GND: Cvcc1.2, Cvcc3.2, Cvcc4.2, Cvcc5.2, Cvcc6.2, Cvcc7.2, Cvcc8.2, Cvcc9.2, Cvcc10.2, Cvcc11.2, Cvcc12.2, Cvcc13.2, Cvcc14.2, Cvcc15.2, Cvcc16.2, Cvcc17.2, Cvcc18.2, Cvcc19.2, Cvcc20.2, Cvcc21.2, Cvcc22.2, Cvcc23.2, Cvcc24.2, Cvcc25.2, Cvcc26.2, Cvcc27.2, Cvcc28.2, Cvcc29.2, Cvcc30.2, Cvcc31.2, Cvcc32.2, Cvcc33.2, Cvcc34.2, Cvcc35.2, Cvcc36.2, Cvcc37.2, Cvcc38.2, Cvcc39.2, Cvcc40.2, Cvcc41.2, Cvcc42.2, Cvcc43.2, Cvcc44.2, Cvcc45.2, Cvcc46.2, Cvcc47.2, Cvcc48.2, Cvcc49.2, Cvcc50.2, Cvcc51.2, Cvcc52.2, Cvcc53.2, Cvcc54.2, Cvcc55.2, Cvcc56.2, Cvcc57.2, Cvcc58.2, Cvcc59.2, Cvcc60.2, Cvcc61.2, Cvcc62.2, Cvcc63.2, Cvcc64.2, Cvcc65.2, Cvcc66.2, Cvcc67.2, Cvcc68.2, Cvcc69.2, Cvcc70.2, Cvcc71.2, Cvcc72.2, Cvout1.2, Cvout3.2, Cvout4.2, Cvout5.2, Cvout6.2, Cvout7.2, Cvout8.2, Cvout9.2, Cvout10.2, Cvout11.2, Cvout12.2, Cvout13.2, Cvout14.2, Cvout15.2, Cvout16.2, Cvout17.2, Cvout18.2, Cvout19.2, Cvout20.2, Cvout21.2, Cvout22.2, Cvout23.2, Cvout24.2, Cvout25.2, Cvout26.2, Cvout27.2, Cvout28.2, Cvout29.2, Cvout30.2, Cvout31.2, Cvout32.2, Cvout33.2, Cvout34.2, Cvout35.2, Cvout36.2, Cvout37.2, Cvout38.2, Cvout39.2, Cvout40.2, Cvout41.2, Cvout42.2, Cvout43.2, Cvout44.2, Cvout45.2, Cvout46.2, Cvout47.2, Cvout48.2, Cvout49.2, Cvout50.2, Cvout51.2, Cvout52.2, Cvout53.2, Cvout54.2, Cvout55.2, Cvout56.2, Cvout57.2, Cvout58.2, Cvout59.2, Cvout60.2, Cvout61.2, Cvout62.2, Cvout63.2, Cvout64.2, Cvout65.2, Cvout66.2, Cvout67.2, Cvout68.2, Cvout69.2, Cvout70.2, Cvout71.2, Cvout72.2, TMR1.2 (GND), TMR1.4 (GND), TMR3.2 (GND), TMR3.4 (GND), TMR4.2 (GND), TMR4.4 (GND), TMR5.2 (GND), TMR5.4 (GND), TMR6.2 (GND), TMR6.4 (GND), TMR7.2 (GND), TMR7.4 (GND), TMR8.2 (GND), TMR8.4 (GND), TMR9.2 (GND), TMR9.4 (GND), TMR10.2 (GND), TMR10.4 (GND), TMR11.2 (GND), TMR11.4 (GND), TMR12.2 (GND), TMR12.4 (GND), TMR13.2 (GND), TMR13.4 (GND), TMR14.2 (GND), TMR14.4 (GND), TMR15.2 (GND), TMR15.4 (GND), TMR16.2 (GND), TMR16.4 (GND), TMR17.2 (GND), TMR17.4 (GND), TMR18.2 (GND), TMR18.4 (GND), TMR19.2 (GND), TMR19.4 (GND), TMR20.2 (GND), TMR20.4 (GND), TMR21.2 (GND), TMR21.4 (GND), TMR22.2 (GND), TMR22.4 (GND), TMR23.2 (GND), TMR23.4 (GND), TMR24.2 (GND), TMR24.4 (GND), TMR25.2 (GND), TMR25.4 (GND), TMR26.2 (GND), TMR26.4 (GND), TMR27.2 (GND), TMR27.4 (GND), TMR28.2 (GND), TMR28.4 (GND), TMR29.2 (GND), TMR29.4 (GND), TMR30.2 (GND), TMR30.4 (GND), TMR31.2 (GND), TMR31.4 (GND), TMR32.2 (GND), TMR32.4 (GND), TMR33.2 (GND), TMR33.4 (GND), TMR34.2 (GND), TMR34.4 (GND), TMR35.2 (GND), TMR35.4 (GND), TMR36.2 (GND), TMR36.4 (GND), TMR37.2 (GND), TMR37.4 (GND), TMR38.2 (GND), TMR38.4 (GND), TMR39.2 (GND), TMR39.4 (GND), TMR40.2 (GND), TMR40.4 (GND), TMR41.2 (GND), TMR41.4 (GND), TMR42.2 (GND), TMR42.4 (GND), TMR43.2 (GND), TMR43.4 (GND), TMR44.2 (GND), TMR44.4 (GND), TMR45.2 (GND), TMR45.4 (GND), TMR46.2 (GND), TMR46.4 (GND), TMR47.2 (GND), TMR47.4 (GND), TMR48.2 (GND), TMR48.4 (GND), TMR49.2 (GND), TMR49.4 (GND), TMR50.2 (GND), TMR50.4 (GND), TMR51.2 (GND), TMR51.4 (GND), TMR52.2 (GND), TMR52.4 (GND), TMR53.2 (GND), TMR53.4 (GND), TMR54.2 (GND), TMR54.4 (GND), TMR55.2 (GND), TMR55.4 (GND), TMR56.2 (GND), TMR56.4 (GND), TMR57.2 (GND), TMR57.4 (GND), TMR58.2 (GND), TMR58.4 (GND), TMR59.2 (GND), TMR59.4 (GND), TMR60.2 (GND), TMR60.4 (GND), TMR61.2 (GND), TMR61.4 (GND), TMR62.2 (GND), TMR62.4 (GND), TMR63.2 (GND), TMR63.4 (GND), TMR64.2 (GND), TMR64.4 (GND), TMR65.2 (GND), TMR65.4 (GND), TMR66.2 (GND), TMR66.4 (GND), TMR67.2 (GND), TMR67.4 (GND), TMR68.2 (GND), TMR68.4 (GND), TMR69.2 (GND), TMR69.4 (GND), TMR70.2 (GND), TMR70.4 (GND), TMR71.2 (GND), TMR71.4 (GND), TMR72.2 (GND), TMR72.4 (GND); also elsewhere on the board
VCCS: Cvcc1.1, Cvcc3.1, Cvcc4.1, Cvcc5.1, Cvcc6.1, Cvcc7.1, Cvcc8.1, Cvcc9.1, Cvcc10.1, Cvcc11.1, Cvcc12.1, Cvcc13.1, Cvcc14.1, Cvcc15.1, Cvcc16.1, Cvcc17.1, Cvcc18.1, Cvcc19.1, Cvcc20.1, Cvcc21.1, Cvcc22.1, Cvcc23.1, Cvcc24.1, Cvcc25.1, Cvcc26.1, Cvcc27.1, Cvcc28.1, Cvcc29.1, Cvcc30.1, Cvcc31.1, Cvcc32.1, Cvcc33.1, Cvcc34.1, Cvcc35.1, Cvcc36.1, Cvcc37.1, Cvcc38.1, Cvcc39.1, Cvcc40.1, Cvcc41.1, Cvcc42.1, Cvcc43.1, Cvcc44.1, Cvcc45.1, Cvcc46.1, Cvcc47.1, Cvcc48.1, Cvcc49.1, Cvcc50.1, Cvcc51.1, Cvcc52.1, Cvcc53.1, Cvcc54.1, Cvcc55.1, Cvcc56.1, Cvcc57.1, Cvcc58.1, Cvcc59.1, Cvcc60.1, Cvcc61.1, Cvcc62.1, Cvcc63.1, Cvcc64.1, Cvcc65.1, Cvcc66.1, Cvcc67.1, Cvcc68.1, Cvcc69.1, Cvcc70.1, Cvcc71.1, Cvcc72.1, TMR1.3 (V_{CC}), TMR3.3 (V_{CC}), TMR4.3 (V_{CC}), TMR5.3 (V_{CC}), TMR6.3 (V_{CC}), TMR7.3 (V_{CC}), TMR8.3 (V_{CC}), TMR9.3 (V_{CC}), TMR10.3 (V_{CC}), TMR11.3 (V_{CC}), TMR12.3 (V_{CC}), TMR13.3 (V_{CC}), TMR14.3 (V_{CC}), TMR15.3 (V_{CC}), TMR16.3 (V_{CC}), TMR17.3 (V_{CC}), TMR18.3 (V_{CC}), TMR19.3 (V_{CC}), TMR20.3 (V_{CC}), TMR21.3 (V_{CC}), TMR22.3 (V_{CC}), TMR23.3 (V_{CC}), TMR24.3 (V_{CC}), TMR25.3 (V_{CC}), TMR26.3 (V_{CC}), TMR27.3 (V_{CC}), TMR28.3 (V_{CC}), TMR29.3 (V_{CC}), TMR30.3 (V_{CC}), TMR31.3 (V_{CC}), TMR32.3 (V_{CC}), TMR33.3 (V_{CC}), TMR34.3 (V_{CC}), TMR35.3 (V_{CC}), TMR36.3 (V_{CC}), TMR37.3 (V_{CC}), TMR38.3 (V_{CC}), TMR39.3 (V_{CC}), TMR40.3 (V_{CC}), TMR41.3 (V_{CC}), TMR42.3 (V_{CC}), TMR43.3 (V_{CC}), TMR44.3 (V_{CC}), TMR45.3 (V_{CC}), TMR46.3 (V_{CC}), TMR47.3 (V_{CC}), TMR48.3 (V_{CC}), TMR49.3 (V_{CC}), TMR50.3 (V_{CC}), TMR51.3 (V_{CC}), TMR52.3 (V_{CC}), TMR53.3 (V_{CC}), TMR54.3 (V_{CC}), TMR55.3 (V_{CC}), TMR56.3 (V_{CC}), TMR57.3 (V_{CC}), TMR58.3 (V_{CC}), TMR59.3 (V_{CC}), TMR60.3 (V_{CC}), TMR61.3 (V_{CC}), TMR62.3 (V_{CC}), TMR63.3 (V_{CC}), TMR64.3 (V_{CC}), TMR65.3 (V_{CC}), TMR66.3 (V_{CC}), TMR67.3 (V_{CC}), TMR68.3 (V_{CC}), TMR69.3 (V_{CC}), TMR70.3 (V_{CC}), TMR71.3 (V_{CC}), TMR72.3 (V_{CC}); also elsewhere on the board

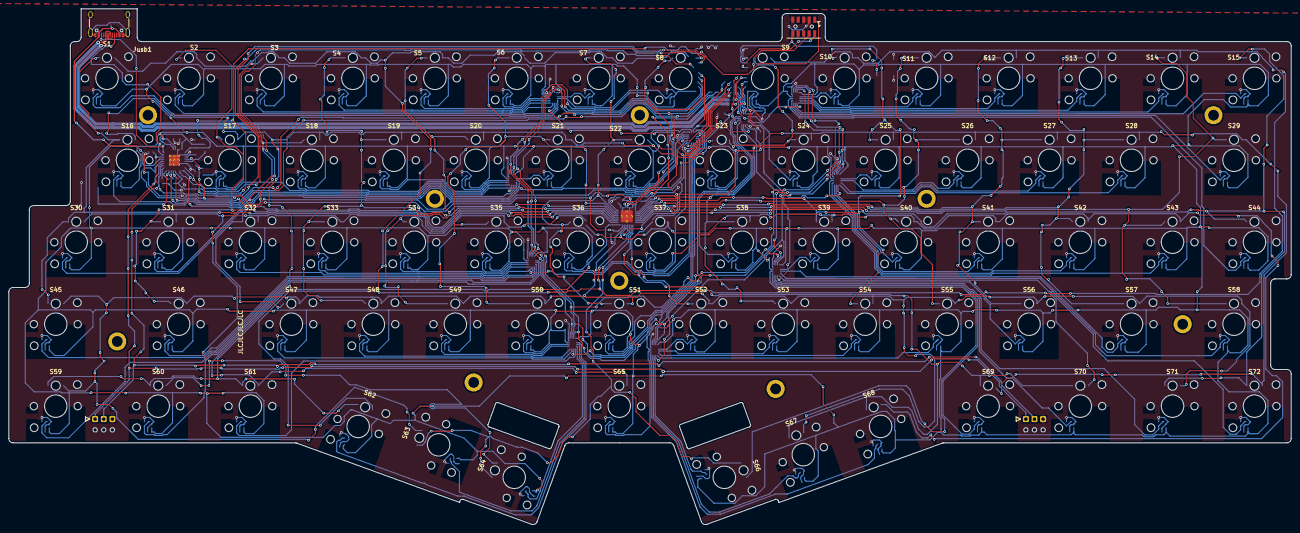
[picture p16: board hardware/nRF54LM20_TMR2615/pcb/pcb.kicad_pcb from above]

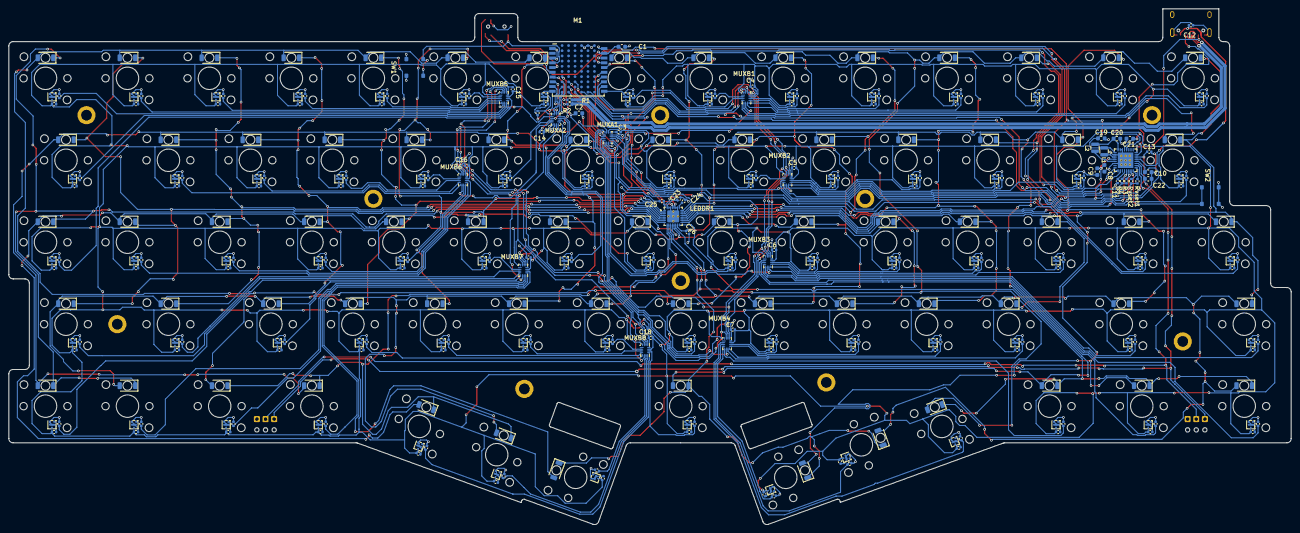
[picture p17: board hardware/nRF54LM20_TMR2615/pcb/pcb.kicad_pcb from below]

Board: 2 copper layers, 297.2 x 119.5 mm, 426 parts (337 on the bottom side), 144 nets.
