girishji/tmr-keyboard/hardware/nRF54L15_TMR2617_sm_gateron/pcb/pcb.kicad_pcb

## KiCad design hardware/nRF54L15_TMR2617_sm_gateron/pcb/pcb.kicad_pcb (2026-08-11)

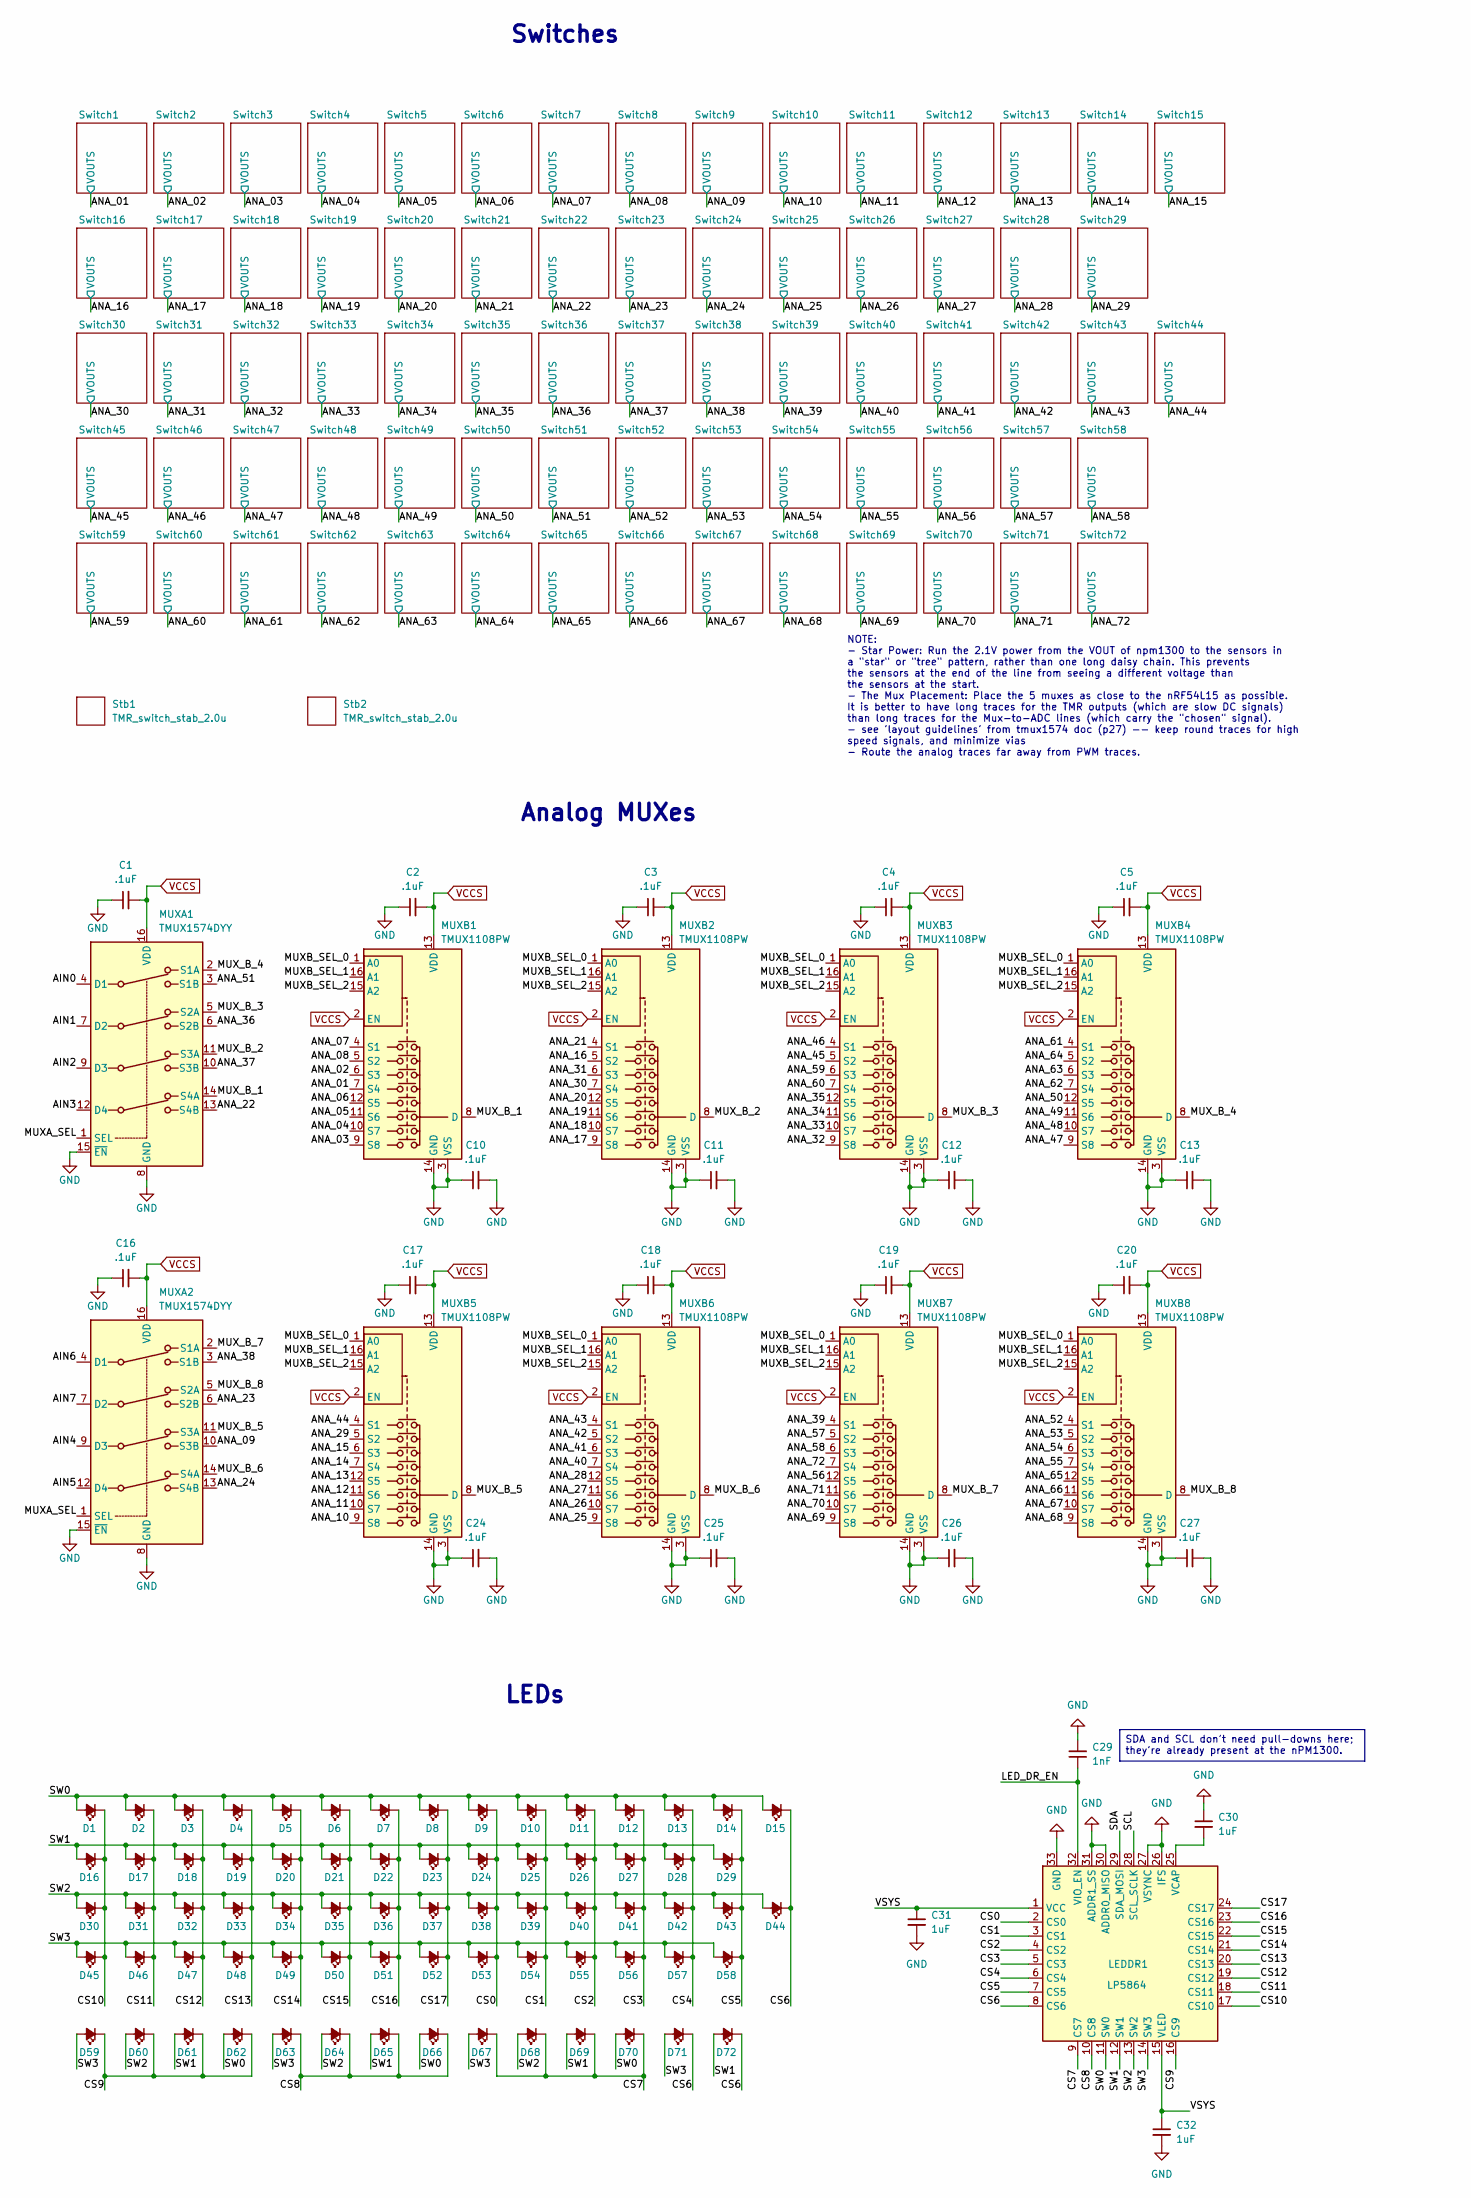
[picture p18: schematic pcb.kicad_sch, part in row 1, column 1]

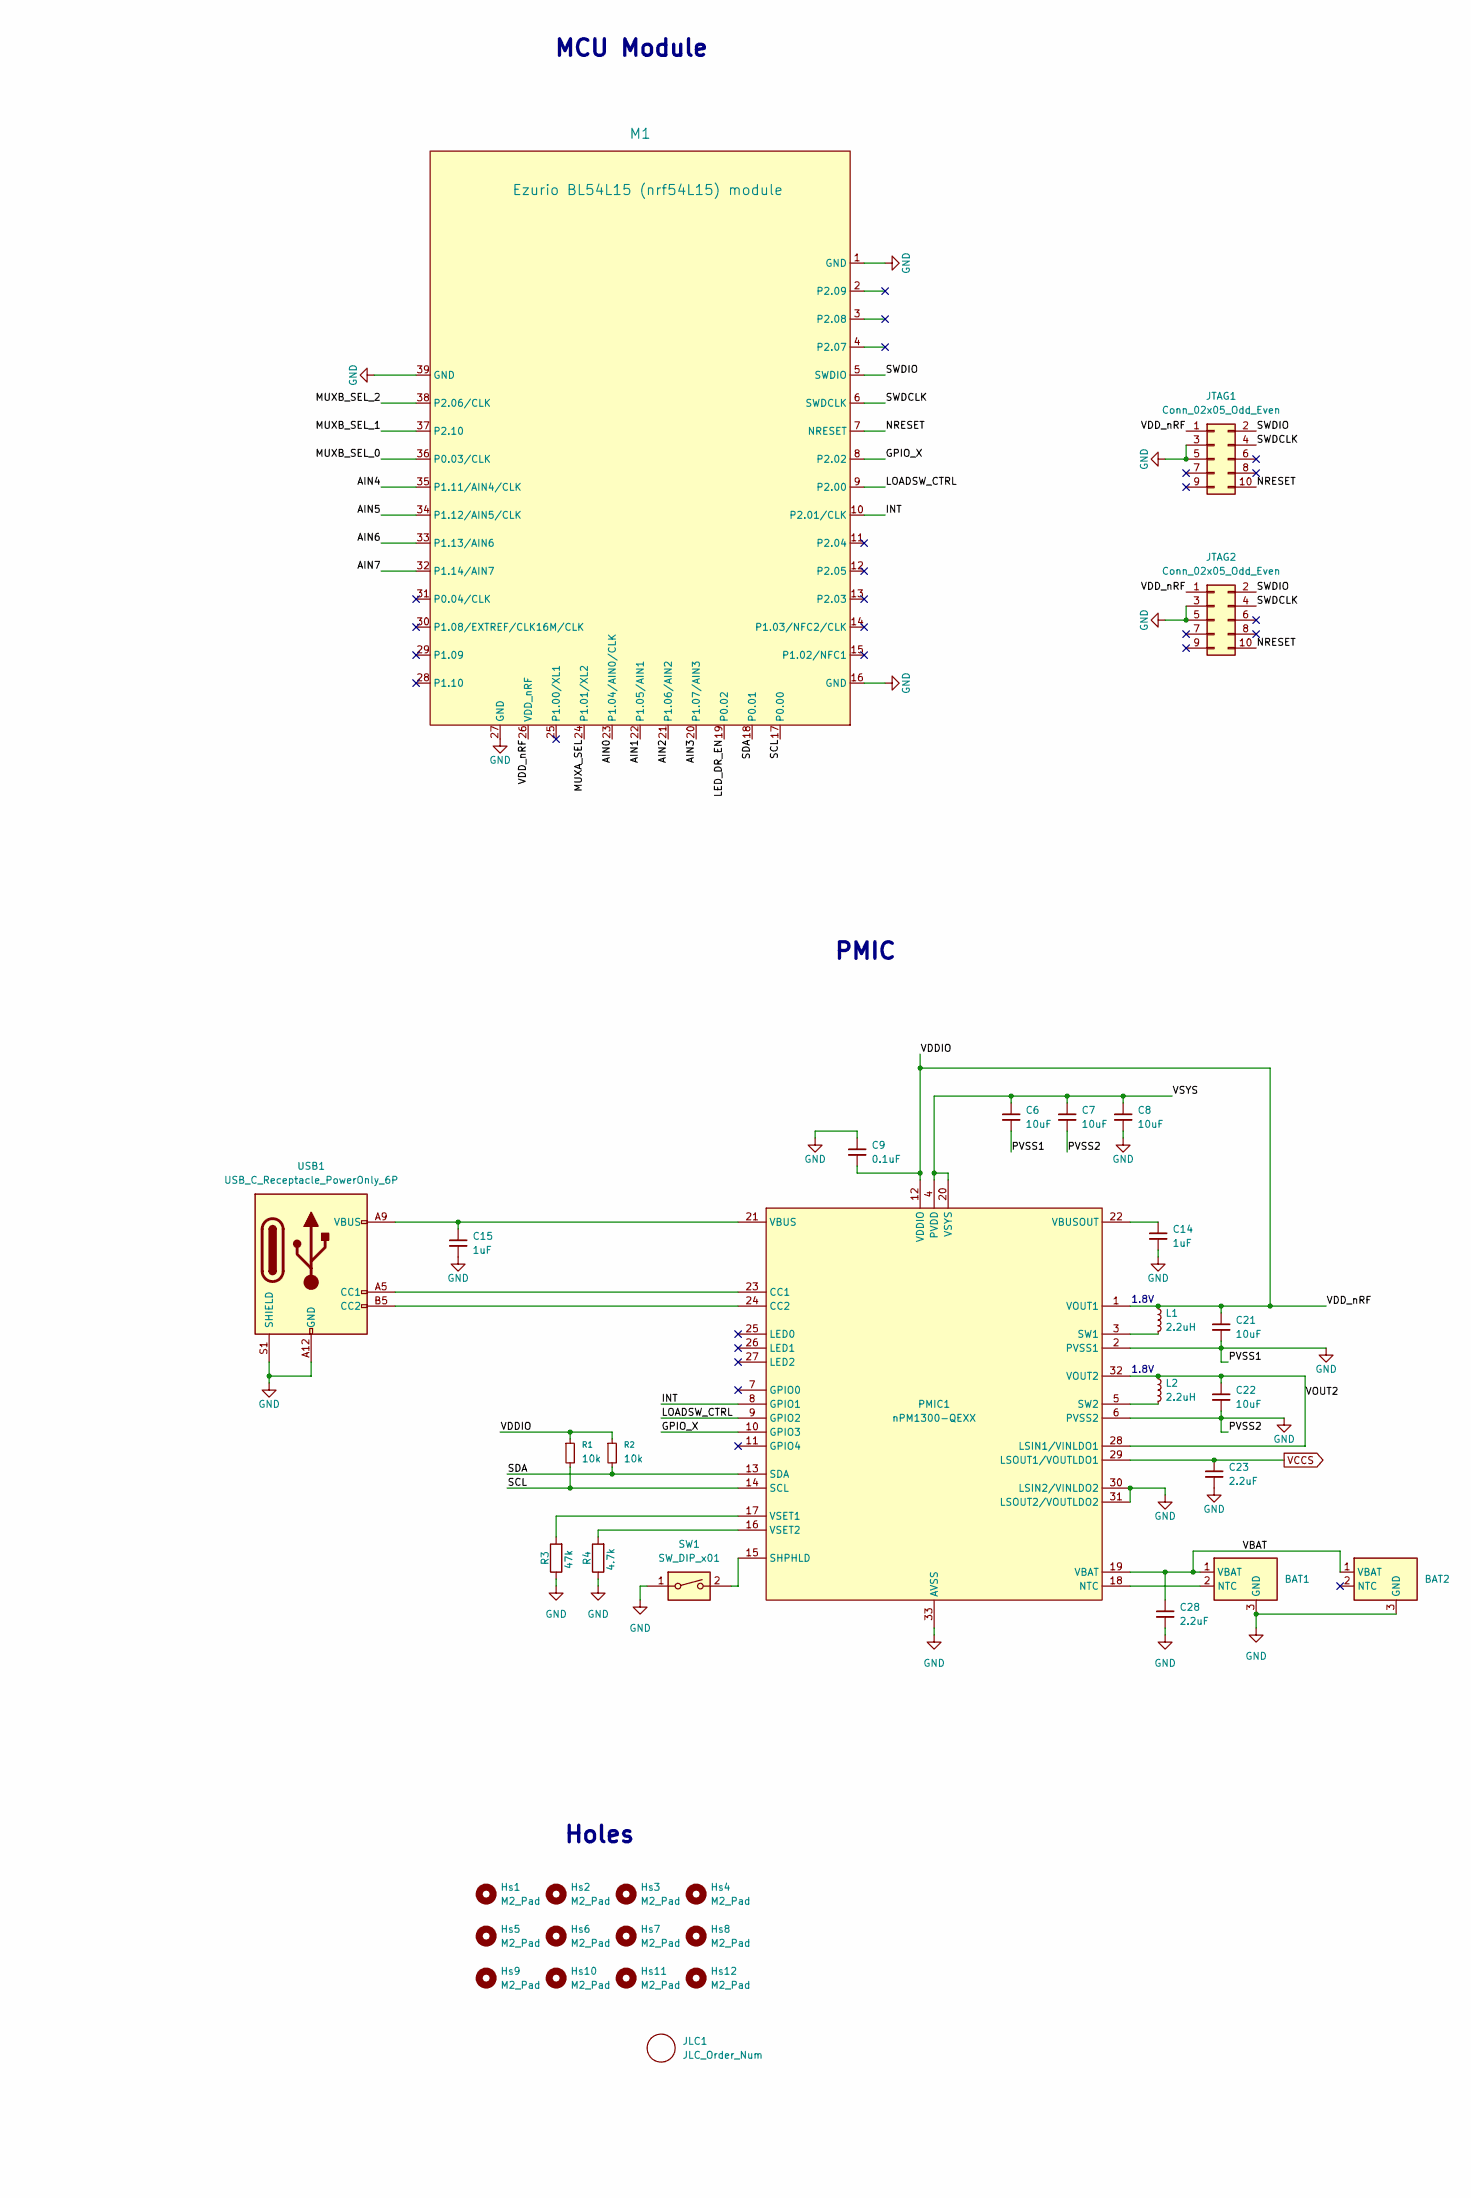
[picture p19: schematic pcb.kicad_sch, part in row 1, column 2]

Parts:
BAT1, BAT2: JST_SH_SM03B-SRSS-TB_1x03-1MP_P1.00mm_Horizontal
C1, C2, C3, C4, C5, C10, C11, C12, C13, C16, C17, C18, C19, C20, C24, C25, C26, C27: .1uF; C_0402_1005Metric
C6, C7, C8, C21, C22: 10uF; C_0603_1608Metric
C9: 0.1uF; C_0402_1005Metric
C14, C15, C30, C31, C32: 1uF; C_0603_1608Metric
C23, C28: 2.2uF; C_0603_1608Metric
C29: 1nF; C_0603_1608Metric
D1, D2, D3, D4, D5, D6, D7, D8, D9, D10, D11, D12, D13, D14, D15, D16, D17, D18, D19, D20, D21, D22, D23, D24, D25, D26, D27, D28, D29, D30, D31, D32, D33, D34, D35, D36, D37, D38, D39, D40, D41, D42, D43, D44, D45, D46, D47, D48, D49, D50, D51, D52, D53, D54, D55, D56, D57, D58, D59, D60, D61, D62, D63, D64, D65, D66, D67, D68, D69, D70, D71, D72: Green LED; LED_1206_3216Metric_ReverseMount_Hole2.1mm
Hs1, Hs2, Hs3, Hs4, Hs5, Hs6, Hs7, Hs8, Hs9, Hs10, Hs11, Hs12: M2_Pad; MountingHole_2.2mm_M2_ISO7380_Pad_TopBottom
JLC1: JLC_Order_Num
JTAG1: Conn_02x05_Odd_Even; SAMTEC-CLP-105-02-X-D-A
JTAG2: Conn_02x05_Odd_Even; Tag-Connect_TC2050-IDC-NL_2x05_P1.27mm_Vertical
L1, L2: 2.2uH; L_Samsung_CIGT201610EH2R2MNE
LEDDR1: LP5864; VQFN-32-1EP_4x4mm_P0.4mm_EP2.8x2.8mm_ThermalVias
M1: Ezurio BL54L15 (nrf54L15) module; Ezurio_BL54L15_Module
MUXA1, MUXA2: TMUX1574DYY; Texas_DYY0016A_TSOT-23-16_2x4.2mm_P0.5mm
MUXB1, MUXB2, MUXB3, MUXB4, MUXB5, MUXB6, MUXB7, MUXB8: TMUX1108PW; TSSOP-16_4.4x5mm_P0.65mm
PMIC1: nPM1300-QEXX; QFN-32-1EP_5x5mm_P0.5mm_EP3.6x3.6mm_ThermalVias
R1, R2: 10k; R_0402_1005Metric
R3: 47k; R_0402_1005Metric
R4: 4.7k; R_0402_1005Metric
SW1: SW_DIP_x01; Button_Switch_3x4x2.5
Stb1, Stb2: TMR_switch_stab_2.0u; Stabilizer_Lowpro_2U
USB1: USB_C_Receptacle_PowerOnly_6P; USB_C_Receptacle_GCT_USB4125-xx-x-0190_6P_TopMnt_Horizontal

Connections:
/AIN0: M1.23 (P1.04/AIN0/CLK), MUXA1.4 (D1)
/AIN1: M1.22 (P1.05/AIN1), MUXA1.7 (D2)
/AIN2: M1.21 (P1.06/AIN2), MUXA1.9 (D3)
/AIN3: M1.20 (P1.07/AIN3), MUXA1.12 (D4)
/AIN4: M1.35 (P1.11/AIN4/CLK), MUXA2.9 (D3)
/AIN5: M1.34 (P1.12/AIN5/CLK), MUXA2.12 (D4)
/AIN6: M1.33 (P1.13/AIN6), MUXA2.4 (D1)
/AIN7: M1.32 (P1.14/AIN7), MUXA2.7 (D2)
/ANA_01: MUXB1.7 (S4); also elsewhere on the board
/ANA_02: MUXB1.6 (S3); also elsewhere on the board
/ANA_03: MUXB1.9 (S8); also elsewhere on the board
/ANA_04: MUXB1.10 (S7); also elsewhere on the board
/ANA_05: MUXB1.11 (S6); also elsewhere on the board
/ANA_06: MUXB1.12 (S5); also elsewhere on the board
/ANA_07: MUXB1.4 (S1); also elsewhere on the board
/ANA_08: MUXB1.5 (S2); also elsewhere on the board
/ANA_09: MUXA2.10 (S3B); also elsewhere on the board
/ANA_10: MUXB5.9 (S8); also elsewhere on the board
/ANA_11: MUXB5.10 (S7); also elsewhere on the board
/ANA_12: MUXB5.11 (S6); also elsewhere on the board
/ANA_13: MUXB5.12 (S5); also elsewhere on the board
/ANA_14: MUXB5.7 (S4); also elsewhere on the board
/ANA_15: MUXB5.6 (S3); also elsewhere on the board
/ANA_16: MUXB2.5 (S2); also elsewhere on the board
/ANA_17: MUXB2.9 (S8); also elsewhere on the board
/ANA_18: MUXB2.10 (S7); also elsewhere on the board
/ANA_19: MUXB2.11 (S6); also elsewhere on the board
/ANA_20: MUXB2.12 (S5); also elsewhere on the board
/ANA_21: MUXB2.4 (S1); also elsewhere on the board
/ANA_22: MUXA1.13 (S4B); also elsewhere on the board
/ANA_23: MUXA2.6 (S2B); also elsewhere on the board
/ANA_24: MUXA2.13 (S4B); also elsewhere on the board
/ANA_25: MUXB6.9 (S8); also elsewhere on the board
/ANA_26: MUXB6.10 (S7); also elsewhere on the board
/ANA_27: MUXB6.11 (S6); also elsewhere on the board
/ANA_28: MUXB6.12 (S5); also elsewhere on the board
/ANA_29: MUXB5.5 (S2); also elsewhere on the board
/ANA_30: MUXB2.7 (S4); also elsewhere on the board
/ANA_31: MUXB2.6 (S3); also elsewhere on the board
/ANA_32: MUXB3.9 (S8); also elsewhere on the board
/ANA_33: MUXB3.10 (S7); also elsewhere on the board
/ANA_34: MUXB3.11 (S6); also elsewhere on the board
/ANA_35: MUXB3.12 (S5); also elsewhere on the board
/ANA_36: MUXA1.6 (S2B); also elsewhere on the board
/ANA_37: MUXA1.10 (S3B); also elsewhere on the board
/ANA_38: MUXA2.3 (S1B); also elsewhere on the board
/ANA_39: MUXB7.4 (S1); also elsewhere on the board
/ANA_40: MUXB6.7 (S4); also elsewhere on the board
/ANA_41: MUXB6.6 (S3); also elsewhere on the board
/ANA_42: MUXB6.5 (S2); also elsewhere on the board
/ANA_43: MUXB6.4 (S1); also elsewhere on the board
/ANA_44: MUXB5.4 (S1); also elsewhere on the board
/ANA_45: MUXB3.5 (S2); also elsewhere on the board
/ANA_46: MUXB3.4 (S1); also elsewhere on the board
/ANA_47: MUXB4.9 (S8); also elsewhere on the board
/ANA_48: MUXB4.10 (S7); also elsewhere on the board
/ANA_49: MUXB4.11 (S6); also elsewhere on the board
/ANA_50: MUXB4.12 (S5); also elsewhere on the board
/ANA_51: MUXA1.3 (S1B); also elsewhere on the board
/ANA_52: MUXB8.4 (S1); also elsewhere on the board
/ANA_53: MUXB8.5 (S2); also elsewhere on the board
/ANA_54: MUXB8.6 (S3); also elsewhere on the board
/ANA_55: MUXB8.7 (S4); also elsewhere on the board
/ANA_56: MUXB7.12 (S5); also elsewhere on the board
/ANA_57: MUXB7.5 (S2); also elsewhere on the board
/ANA_58: MUXB7.6 (S3); also elsewhere on the board
/ANA_59: MUXB3.6 (S3); also elsewhere on the board
/ANA_60: MUXB3.7 (S4); also elsewhere on the board
/ANA_61: MUXB4.4 (S1); also elsewhere on the board
/ANA_62: MUXB4.7 (S4); also elsewhere on the board
/ANA_63: MUXB4.6 (S3); also elsewhere on the board
/ANA_64: MUXB4.5 (S2); also elsewhere on the board
/ANA_65: MUXB8.12 (S5); also elsewhere on the board
/ANA_66: MUXB8.11 (S6); also elsewhere on the board
/ANA_67: MUXB8.10 (S7); also elsewhere on the board
/ANA_68: MUXB8.9 (S8); also elsewhere on the board
/ANA_69: MUXB7.9 (S8); also elsewhere on the board
/ANA_70: MUXB7.10 (S7); also elsewhere on the board
/ANA_71: MUXB7.11 (S6); also elsewhere on the board
/ANA_72: MUXB7.7 (S4); also elsewhere on the board
/CS0: D9.1 (K), D24.1 (K), D38.1 (K), D53.1 (K), LEDDR1.2 (CS0)
/CS1: D10.1 (K), D25.1 (K), D39.1 (K), D54.1 (K), LEDDR1.3 (CS1)
/CS2: D11.1 (K), D26.1 (K), D40.1 (K), D55.1 (K), LEDDR1.4 (CS2)
/CS3: D12.1 (K), D27.1 (K), D41.1 (K), D56.1 (K), LEDDR1.5 (CS3)
/CS4: D13.1 (K), D28.1 (K), D42.1 (K), D57.1 (K), LEDDR1.6 (CS4)
/CS5: D14.1 (K), D29.1 (K), D43.1 (K), D58.1 (K), LEDDR1.7 (CS5)
/CS6: D15.1 (K), D44.1 (K), D71.1 (K), D72.1 (K), LEDDR1.8 (CS6)
/CS7: D67.1 (K), D68.1 (K), D69.1 (K), D70.1 (K), LEDDR1.9 (CS7)
/CS8: D63.1 (K), D64.1 (K), D65.1 (K), D66.1 (K), LEDDR1.10 (CS8)
/CS9: D59.1 (K), D60.1 (K), D61.1 (K), D62.1 (K), LEDDR1.16 (CS9)
/CS10: D1.1 (K), D16.1 (K), D30.1 (K), D45.1 (K), LEDDR1.17 (CS10)
/CS11: D2.1 (K), D17.1 (K), D31.1 (K), D46.1 (K), LEDDR1.18 (CS11)
/CS12: D3.1 (K), D18.1 (K), D32.1 (K), D47.1 (K), LEDDR1.19 (CS12)
/CS13: D4.1 (K), D19.1 (K), D33.1 (K), D48.1 (K), LEDDR1.20 (CS13)
/CS14: D5.1 (K), D20.1 (K), D34.1 (K), D49.1 (K), LEDDR1.21 (CS14)
/CS15: D6.1 (K), D21.1 (K), D35.1 (K), D50.1 (K), LEDDR1.22 (CS15)
/CS16: D7.1 (K), D22.1 (K), D36.1 (K), D51.1 (K), LEDDR1.23 (CS16)
/CS17: D8.1 (K), D23.1 (K), D37.1 (K), D52.1 (K), LEDDR1.24 (CS17)
/GPIO_X: M1.8 (P2.02), PMIC1.10 (GPIO3)
/INT: M1.10 (P2.01/CLK), PMIC1.8 (GPIO1)
/LED_DR_EN: C29.1, LEDDR1.32 (VIO_EN), M1.19 (P0.02)
/LOADSW_CTRL: M1.9 (P2.00), PMIC1.9 (GPIO2)
/MUXA_SEL: M1.24 (P1.01/XL2), MUXA1.1 (SEL), MUXA2.1 (SEL)
/MUXB_SEL_0: M1.36 (P0.03/CLK), MUXB1.1 (A0), MUXB2.1 (A0), MUXB3.1 (A0), MUXB4.1 (A0), MUXB5.1 (A0), MUXB6.1 (A0), MUXB7.1 (A0), MUXB8.1 (A0)
/MUXB_SEL_1: M1.37 (P2.10), MUXB1.16 (A1), MUXB2.16 (A1), MUXB3.16 (A1), MUXB4.16 (A1), MUXB5.16 (A1), MUXB6.16 (A1), MUXB7.16 (A1), MUXB8.16 (A1)
/MUXB_SEL_2: M1.38 (P2.06/CLK), MUXB1.15 (A2), MUXB2.15 (A2), MUXB3.15 (A2), MUXB4.15 (A2), MUXB5.15 (A2), MUXB6.15 (A2), MUXB7.15 (A2), MUXB8.15 (A2)
/MUX_B_1: MUXA1.14 (S4A), MUXB1.8 (D)
/MUX_B_2: MUXA1.11 (S3A), MUXB2.8 (D)
/MUX_B_3: MUXA1.5 (S2A), MUXB3.8 (D)
/MUX_B_4: MUXA1.2 (S1A), MUXB4.8 (D)
/MUX_B_5: MUXA2.11 (S3A), MUXB5.8 (D)
/MUX_B_6: MUXA2.14 (S4A), MUXB6.8 (D)
/MUX_B_7: MUXA2.2 (S1A), MUXB7.8 (D)
/MUX_B_8: MUXA2.5 (S2A), MUXB8.8 (D)
/NRESET: JTAG1.10, JTAG2.10, M1.7 (NRESET)
/SCL: LEDDR1.28 (SCL_SCLK), M1.17 (P0.00), PMIC1.14 (SCL), R1.2
/SDA: LEDDR1.29 (SDA_MOSI), M1.18 (P0.01), PMIC1.13 (SDA), R2.2
/SW0: D1.2 (A), D2.2 (A), D3.2 (A), D4.2 (A), D5.2 (A), D6.2 (A), D7.2 (A), D8.2 (A), D9.2 (A), D10.2 (A), D11.2 (A), D12.2 (A), D13.2 (A), D14.2 (A), D15.2 (A), D62.2 (A), D66.2 (A), D70.2 (A), LEDDR1.11 (SW0)
/SW1: D16.2 (A), D17.2 (A), D18.2 (A), D19.2 (A), D20.2 (A), D21.2 (A), D22.2 (A), D23.2 (A), D24.2 (A), D25.2 (A), D26.2 (A), D27.2 (A), D28.2 (A), D29.2 (A), D61.2 (A), D65.2 (A), D69.2 (A), D72.2 (A), LEDDR1.12 (SW1)
/SW2: D30.2 (A), D31.2 (A), D32.2 (A), D33.2 (A), D34.2 (A), D35.2 (A), D36.2 (A), D37.2 (A), D38.2 (A), D39.2 (A), D40.2 (A), D41.2 (A), D42.2 (A), D43.2 (A), D44.2 (A), D60.2 (A), D64.2 (A), D68.2 (A), LEDDR1.13 (SW2)
/SW3: D45.2 (A), D46.2 (A), D47.2 (A), D48.2 (A), D49.2 (A), D50.2 (A), D51.2 (A), D52.2 (A), D53.2 (A), D54.2 (A), D55.2 (A), D56.2 (A), D57.2 (A), D58.2 (A), D59.2 (A), D63.2 (A), D67.2 (A), D71.2 (A), LEDDR1.14 (SW3)
/SWDCLK: JTAG1.4, JTAG2.4, M1.6 (SWDCLK)
/SWDIO: JTAG1.2, JTAG2.2, M1.5 (SWDIO)
/VBAT: BAT1.1 (VBAT), BAT2.1 (VBAT), C28.1, PMIC1.19 (VBAT)
/VDDIO: C9.2, C21.1, JTAG1.1, JTAG2.1, L1.1, M1.26 (VDD_nRF), PMIC1.1 (VOUT1), PMIC1.12 (VDDIO), R1.1, R2.1
/VOUT2: C22.1, L2.1, PMIC1.28 (LSIN1/VINLDO1), PMIC1.32 (VOUT2)
/VSYS: C6.1, C7.1, C8.1, C31.1, C32.1, LEDDR1.1 (VCC), LEDDR1.15 (VLED), PMIC1.4 (PVDD), PMIC1.20 (VSYS)
GND: BAT1.3 (GND), BAT2.3 (GND), C1.1, C2.1, C3.1, C4.1, C5.1, C6.2, C7.2, C8.2, C9.1, C10.1, C10.2, C11.1, C11.2, C12.1, C12.2, C13.1, C13.2, C14.2, C15.2, C16.1, C17.1, C18.1, C19.1, C20.1, C21.2, C22.2, C23.2, C24.1, C24.2, C25.1, C25.2, C26.1, C26.2, C27.1, C27.2, C28.2, C29.2, C30.1, C31.2, C32.2, JTAG1.3, JTAG1.5, JTAG2.3, JTAG2.5, LEDDR1.26 (IFS), LEDDR1.27 (VSYNC), LEDDR1.30 (ADDR0_MISO), LEDDR1.31 (ADDR1_SS), LEDDR1.33 (GND), M1.1 (GND), M1.16 (GND), M1.27 (GND), M1.39 (GND), MUXA1.8 (GND), MUXA1.15 (~EN), MUXA2.8 (GND), MUXA2.15 (~EN), MUXB1.3 (VSS), MUXB1.14 (GND), MUXB2.3 (VSS), MUXB2.14 (GND), MUXB3.3 (VSS), MUXB3.14 (GND), MUXB4.3 (VSS), MUXB4.14 (GND), MUXB5.3 (VSS), MUXB5.14 (GND), MUXB6.3 (VSS), MUXB6.14 (GND), MUXB7.3 (VSS), MUXB7.14 (GND), MUXB8.3 (VSS), MUXB8.14 (GND), PMIC1.2 (PVSS1), PMIC1.6 (PVSS2), PMIC1.30 (LSIN2/VINLDO2), PMIC1.31 (LSOUT2/VOUTLDO2), PMIC1.33 (AVSS), R3.1, R4.1, SW1.1, USB1.A12 (GND), USB1.B12 (GND), USB1.S1 (SHIELD); also elsewhere on the board
unnamed: BAT1.2 (NTC), PMIC1.18 (NTC)
unnamed: C30.2, LEDDR1.25 (VCAP)
unnamed: PMIC1.23 (CC1), USB1.A5 (CC1)
unnamed: PMIC1.24 (CC2), USB1.B5 (CC2)
unnamed: PMIC1.15 (SHPHLD), SW1.2
unnamed: L1.2, PMIC1.3 (SW1)
unnamed: L2.2, PMIC1.5 (SW2)
unnamed: C15.1, PMIC1.21 (VBUS), USB1.A9 (VBUS), USB1.B9 (VBUS)
unnamed: C14.1, PMIC1.22 (VBUSOUT)
unnamed: PMIC1.17 (VSET1), R3.2
unnamed: PMIC1.16 (VSET2), R4.2
VCCS: C1.2, C2.2, C3.2, C4.2, C5.2, C16.2, C17.2, C18.2, C19.2, C20.2, C23.1, MUXA1.16 (VDD), MUXA2.16 (VDD), MUXB1.2 (EN), MUXB1.13 (VDD), MUXB2.2 (EN), MUXB2.13 (VDD), MUXB3.2 (EN), MUXB3.13 (VDD), MUXB4.2 (EN), MUXB4.13 (VDD), MUXB5.2 (EN), MUXB5.13 (VDD), MUXB6.2 (EN), MUXB6.13 (VDD), MUXB7.2 (EN), MUXB7.13 (VDD), MUXB8.2 (EN), MUXB8.13 (VDD), PMIC1.29 (LSOUT1/VOUTLDO1); also elsewhere on the board

Notes on the sheet:
Holes
1.8V
MCU Module
Analog MUXes
LEDs
PMIC
NOTE: - Star Power: Run the 2.1V power from the VOUT of npm1300 to the sensors in a "star" or "tree" pattern, rather than one long daisy chain. This prevents the sensors at the end of the line from seeing a different voltage than the sensors at the start. - The Mux Placement: Place the 5 muxes as c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
Switches
SDA and SCL don't need pull-downs here; they're already present at the nPM1300.

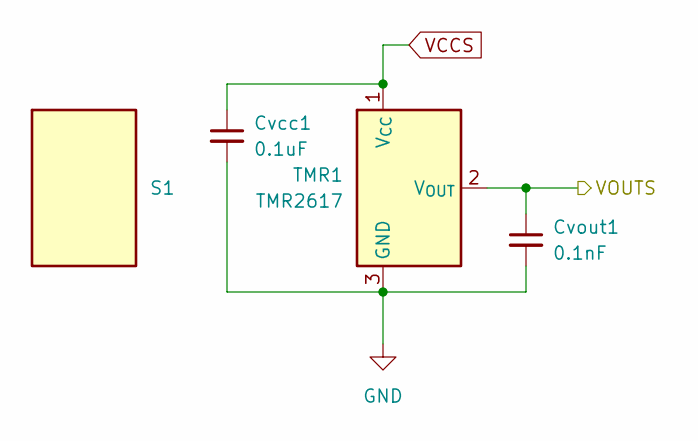
[picture p20: schematic switch.kicad_sch]

Parts:
Cvcc1: 0.1uF; C_0402_1005Metric
Cvout1: 0.1nF; C_0402_1005Metric
S1: Switch; Gateron_Switch_Lowpro
TMR1: TMR2617; SOT-23-3

Connections:
/ANA_01: Cvout1.1, TMR1.2 (V_{OUT}); also elsewhere on the board
GND: Cvcc1.2, Cvout1.2, TMR1.3 (GND); also elsewhere on the board
VCCS: Cvcc1.1, TMR1.1 (V_{CC}); also elsewhere on the board

Parts of its further copies:
Cvcc2, Cvcc3, Cvcc4, Cvcc5, Cvcc6, Cvcc7, Cvcc8, Cvcc9, Cvcc10, Cvcc11, Cvcc12, Cvcc13, Cvcc14, Cvcc15, Cvcc16, Cvcc17, Cvcc18, Cvcc19, Cvcc20, Cvcc21, Cvcc22, Cvcc23, Cvcc24, Cvcc25, Cvcc26, Cvcc27, Cvcc28, Cvcc29, Cvcc30, Cvcc31, Cvcc32, Cvcc33, Cvcc34, Cvcc35, Cvcc36, Cvcc37, Cvcc38, Cvcc39, Cvcc40, Cvcc41, Cvcc42, Cvcc43, Cvcc44, Cvcc45, Cvcc46, Cvcc47, Cvcc48, Cvcc49, Cvcc50, Cvcc51, Cvcc52, Cvcc53, Cvcc54, Cvcc55, Cvcc56, Cvcc57, Cvcc58, Cvcc59, Cvcc60, Cvcc61, Cvcc62, Cvcc63, Cvcc64, Cvcc65, Cvcc66, Cvcc67, Cvcc68, Cvcc69, Cvcc70, Cvcc71, Cvcc72: 0.1uF; C_0402_1005Metric
Cvout2, Cvout3, Cvout4, Cvout5, Cvout6, Cvout7, Cvout8, Cvout9, Cvout10, Cvout11, Cvout12, Cvout13, Cvout14, Cvout15, Cvout16, Cvout17, Cvout18, Cvout19, Cvout20, Cvout21, Cvout22, Cvout23, Cvout24, Cvout25, Cvout26, Cvout27, Cvout28, Cvout29, Cvout30, Cvout31, Cvout32, Cvout33, Cvout34, Cvout35, Cvout36, Cvout37, Cvout38, Cvout39, Cvout40, Cvout41, Cvout42, Cvout43, Cvout44, Cvout45, Cvout46, Cvout47, Cvout48, Cvout49, Cvout50, Cvout51, Cvout52, Cvout53, Cvout54, Cvout55, Cvout56, Cvout57, Cvout58, Cvout59, Cvout60, Cvout61, Cvout62, Cvout63, Cvout64, Cvout65, Cvout66, Cvout67, Cvout68, Cvout69, Cvout70, Cvout71, Cvout72: 0.1nF; C_0402_1005Metric
S2, S3, S4, S5, S6, S7, S8, S9, S10, S11, S12, S13, S14, S15, S16, S17, S18, S19, S20, S21, S22, S23, S24, S25, S26, S27, S28, S29, S30, S31, S32, S33, S34, S35, S36, S37, S38, S39, S40, S41, S42, S43, S44, S45, S46, S47, S48, S49, S50, S51, S52, S53, S54, S55, S56, S57, S58, S59, S60, S61, S62, S63, S64, S65, S66, S67, S68, S69, S70, S71, S72: Switch; Gateron_Switch_Lowpro
TMR2, TMR3, TMR4, TMR5, TMR6, TMR7, TMR8, TMR9, TMR10, TMR11, TMR12, TMR13, TMR14, TMR15, TMR16, TMR17, TMR18, TMR19, TMR20, TMR21, TMR22, TMR23, TMR24, TMR25, TMR26, TMR27, TMR28, TMR29, TMR30, TMR31, TMR32, TMR33, TMR34, TMR35, TMR36, TMR37, TMR38, TMR39, TMR40, TMR41, TMR42, TMR43, TMR44, TMR45, TMR46, TMR47, TMR48, TMR49, TMR50, TMR51, TMR52, TMR53, TMR54, TMR55, TMR56, TMR57, TMR58, TMR59, TMR60, TMR61, TMR62, TMR63, TMR64, TMR65, TMR66, TMR67, TMR68, TMR69, TMR70, TMR71, TMR72: TMR2617; SOT-23-3

Connections of its further copies:
/ANA_02: Cvout2.1, TMR2.2 (V_{OUT}); also elsewhere on the board
/ANA_03: Cvout3.1, TMR3.2 (V_{OUT}); also elsewhere on the board
/ANA_04: Cvout4.1, TMR4.2 (V_{OUT}); also elsewhere on the board
/ANA_05: Cvout5.1, TMR5.2 (V_{OUT}); also elsewhere on the board
/ANA_06: Cvout6.1, TMR6.2 (V_{OUT}); also elsewhere on the board
/ANA_07: Cvout7.1, TMR7.2 (V_{OUT}); also elsewhere on the board
/ANA_08: Cvout8.1, TMR8.2 (V_{OUT}); also elsewhere on the board
/ANA_09: Cvout9.1, TMR9.2 (V_{OUT}); also elsewhere on the board
/ANA_10: Cvout10.1, TMR10.2 (V_{OUT}); also elsewhere on the board
/ANA_11: Cvout11.1, TMR11.2 (V_{OUT}); also elsewhere on the board
/ANA_12: Cvout12.1, TMR12.2 (V_{OUT}); also elsewhere on the board
/ANA_13: Cvout13.1, TMR13.2 (V_{OUT}); also elsewhere on the board
/ANA_14: Cvout14.1, TMR14.2 (V_{OUT}); also elsewhere on the board
/ANA_15: Cvout15.1, TMR15.2 (V_{OUT}); also elsewhere on the board
/ANA_16: Cvout16.1, TMR16.2 (V_{OUT}); also elsewhere on the board
/ANA_17: Cvout17.1, TMR17.2 (V_{OUT}); also elsewhere on the board
/ANA_18: Cvout18.1, TMR18.2 (V_{OUT}); also elsewhere on the board
/ANA_19: Cvout19.1, TMR19.2 (V_{OUT}); also elsewhere on the board
/ANA_20: Cvout20.1, TMR20.2 (V_{OUT}); also elsewhere on the board
/ANA_21: Cvout21.1, TMR21.2 (V_{OUT}); also elsewhere on the board
/ANA_22: Cvout22.1, TMR22.2 (V_{OUT}); also elsewhere on the board
/ANA_23: Cvout23.1, TMR23.2 (V_{OUT}); also elsewhere on the board
/ANA_24: Cvout24.1, TMR24.2 (V_{OUT}); also elsewhere on the board
/ANA_25: Cvout25.1, TMR25.2 (V_{OUT}); also elsewhere on the board
/ANA_26: Cvout26.1, TMR26.2 (V_{OUT}); also elsewhere on the board
/ANA_27: Cvout27.1, TMR27.2 (V_{OUT}); also elsewhere on the board
/ANA_28: Cvout28.1, TMR28.2 (V_{OUT}); also elsewhere on the board
/ANA_29: Cvout29.1, TMR29.2 (V_{OUT}); also elsewhere on the board
/ANA_30: Cvout30.1, TMR30.2 (V_{OUT}); also elsewhere on the board
/ANA_31: Cvout31.1, TMR31.2 (V_{OUT}); also elsewhere on the board
/ANA_32: Cvout32.1, TMR32.2 (V_{OUT}); also elsewhere on the board
/ANA_33: Cvout33.1, TMR33.2 (V_{OUT}); also elsewhere on the board
/ANA_34: Cvout34.1, TMR34.2 (V_{OUT}); also elsewhere on the board
/ANA_35: Cvout35.1, TMR35.2 (V_{OUT}); also elsewhere on the board
/ANA_36: Cvout36.1, TMR36.2 (V_{OUT}); also elsewhere on the board
/ANA_37: Cvout37.1, TMR37.2 (V_{OUT}); also elsewhere on the board
/ANA_38: Cvout38.1, TMR38.2 (V_{OUT}); also elsewhere on the board
/ANA_39: Cvout39.1, TMR39.2 (V_{OUT}); also elsewhere on the board
/ANA_40: Cvout40.1, TMR40.2 (V_{OUT}); also elsewhere on the board
/ANA_41: Cvout41.1, TMR41.2 (V_{OUT}); also elsewhere on the board
/ANA_42: Cvout42.1, TMR42.2 (V_{OUT}); also elsewhere on the board
/ANA_43: Cvout43.1, TMR43.2 (V_{OUT}); also elsewhere on the board
/ANA_44: Cvout44.1, TMR44.2 (V_{OUT}); also elsewhere on the board
/ANA_45: Cvout45.1, TMR45.2 (V_{OUT}); also elsewhere on the board
/ANA_46: Cvout46.1, TMR46.2 (V_{OUT}); also elsewhere on the board
/ANA_47: Cvout47.1, TMR47.2 (V_{OUT}); also elsewhere on the board
/ANA_48: Cvout48.1, TMR48.2 (V_{OUT}); also elsewhere on the board
/ANA_49: Cvout49.1, TMR49.2 (V_{OUT}); also elsewhere on the board
/ANA_50: Cvout50.1, TMR50.2 (V_{OUT}); also elsewhere on the board
/ANA_51: Cvout51.1, TMR51.2 (V_{OUT}); also elsewhere on the board
/ANA_52: Cvout52.1, TMR52.2 (V_{OUT}); also elsewhere on the board
/ANA_53: Cvout53.1, TMR53.2 (V_{OUT}); also elsewhere on the board
/ANA_54: Cvout54.1, TMR54.2 (V_{OUT}); also elsewhere on the board
/ANA_55: Cvout55.1, TMR55.2 (V_{OUT}); also elsewhere on the board
/ANA_56: Cvout56.1, TMR56.2 (V_{OUT}); also elsewhere on the board
/ANA_57: Cvout57.1, TMR57.2 (V_{OUT}); also elsewhere on the board
/ANA_58: Cvout58.1, TMR58.2 (V_{OUT}); also elsewhere on the board
/ANA_59: Cvout59.1, TMR59.2 (V_{OUT}); also elsewhere on the board
/ANA_60: Cvout60.1, TMR60.2 (V_{OUT}); also elsewhere on the board
/ANA_61: Cvout61.1, TMR61.2 (V_{OUT}); also elsewhere on the board
/ANA_62: Cvout62.1, TMR62.2 (V_{OUT}); also elsewhere on the board
/ANA_63: Cvout63.1, TMR63.2 (V_{OUT}); also elsewhere on the board
/ANA_64: Cvout64.1, TMR64.2 (V_{OUT}); also elsewhere on the board
/ANA_65: Cvout65.1, TMR65.2 (V_{OUT}); also elsewhere on the board
/ANA_66: Cvout66.1, TMR66.2 (V_{OUT}); also elsewhere on the board
/ANA_67: Cvout67.1, TMR67.2 (V_{OUT}); also elsewhere on the board
/ANA_68: Cvout68.1, TMR68.2 (V_{OUT}); also elsewhere on the board
/ANA_69: Cvout69.1, TMR69.2 (V_{OUT}); also elsewhere on the board
/ANA_70: Cvout70.1, TMR70.2 (V_{OUT}); also elsewhere on the board
/ANA_71: Cvout71.1, TMR71.2 (V_{OUT}); also elsewhere on the board
/ANA_72: Cvout72.1, TMR72.2 (V_{OUT}); also elsewhere on the board
GND: Cvcc2.2, Cvcc3.2, Cvcc4.2, Cvcc5.2, Cvcc6.2, Cvcc7.2, Cvcc8.2, Cvcc9.2, Cvcc10.2, Cvcc11.2, Cvcc12.2, Cvcc13.2, Cvcc14.2, Cvcc15.2, Cvcc16.2, Cvcc17.2, Cvcc18.2, Cvcc19.2, Cvcc20.2, Cvcc21.2, Cvcc22.2, Cvcc23.2, Cvcc24.2, Cvcc25.2, Cvcc26.2, Cvcc27.2, Cvcc28.2, Cvcc29.2, Cvcc30.2, Cvcc31.2, Cvcc32.2, Cvcc33.2, Cvcc34.2, Cvcc35.2, Cvcc36.2, Cvcc37.2, Cvcc38.2, Cvcc39.2, Cvcc40.2, Cvcc41.2, Cvcc42.2, Cvcc43.2, Cvcc44.2, Cvcc45.2, Cvcc46.2, Cvcc47.2, Cvcc48.2, Cvcc49.2, Cvcc50.2, Cvcc51.2, Cvcc52.2, Cvcc53.2, Cvcc54.2, Cvcc55.2, Cvcc56.2, Cvcc57.2, Cvcc58.2, Cvcc59.2, Cvcc60.2, Cvcc61.2, Cvcc62.2, Cvcc63.2, Cvcc64.2, Cvcc65.2, Cvcc66.2, Cvcc67.2, Cvcc68.2, Cvcc69.2, Cvcc70.2, Cvcc71.2, Cvcc72.2, Cvout2.2, Cvout3.2, Cvout4.2, Cvout5.2, Cvout6.2, Cvout7.2, Cvout8.2, Cvout9.2, Cvout10.2, Cvout11.2, Cvout12.2, Cvout13.2, Cvout14.2, Cvout15.2, Cvout16.2, Cvout17.2, Cvout18.2, Cvout19.2, Cvout20.2, Cvout21.2, Cvout22.2, Cvout23.2, Cvout24.2, Cvout25.2, Cvout26.2, Cvout27.2, Cvout28.2, Cvout29.2, Cvout30.2, Cvout31.2, Cvout32.2, Cvout33.2, Cvout34.2, Cvout35.2, Cvout36.2, Cvout37.2, Cvout38.2, Cvout39.2, Cvout40.2, Cvout41.2, Cvout42.2, Cvout43.2, Cvout44.2, Cvout45.2, Cvout46.2, Cvout47.2, Cvout48.2, Cvout49.2, Cvout50.2, Cvout51.2, Cvout52.2, Cvout53.2, Cvout54.2, Cvout55.2, Cvout56.2, Cvout57.2, Cvout58.2, Cvout59.2, Cvout60.2, Cvout61.2, Cvout62.2, Cvout63.2, Cvout64.2, Cvout65.2, Cvout66.2, Cvout67.2, Cvout68.2, Cvout69.2, Cvout70.2, Cvout71.2, Cvout72.2, TMR2.3 (GND), TMR3.3 (GND), TMR4.3 (GND), TMR5.3 (GND), TMR6.3 (GND), TMR7.3 (GND), TMR8.3 (GND), TMR9.3 (GND), TMR10.3 (GND), TMR11.3 (GND), TMR12.3 (GND), TMR13.3 (GND), TMR14.3 (GND), TMR15.3 (GND), TMR16.3 (GND), TMR17.3 (GND), TMR18.3 (GND), TMR19.3 (GND), TMR20.3 (GND), TMR21.3 (GND), TMR22.3 (GND), TMR23.3 (GND), TMR24.3 (GND), TMR25.3 (GND), TMR26.3 (GND), TMR27.3 (GND), TMR28.3 (GND), TMR29.3 (GND), TMR30.3 (GND), TMR31.3 (GND), TMR32.3 (GND), TMR33.3 (GND), TMR34.3 (GND), TMR35.3 (GND), TMR36.3 (GND), TMR37.3 (GND), TMR38.3 (GND), TMR39.3 (GND), TMR40.3 (GND), TMR41.3 (GND), TMR42.3 (GND), TMR43.3 (GND), TMR44.3 (GND), TMR45.3 (GND), TMR46.3 (GND), TMR47.3 (GND), TMR48.3 (GND), TMR49.3 (GND), TMR50.3 (GND), TMR51.3 (GND), TMR52.3 (GND), TMR53.3 (GND), TMR54.3 (GND), TMR55.3 (GND), TMR56.3 (GND), TMR57.3 (GND), TMR58.3 (GND), TMR59.3 (GND), TMR60.3 (GND), TMR61.3 (GND), TMR62.3 (GND), TMR63.3 (GND), TMR64.3 (GND), TMR65.3 (GND), TMR66.3 (GND), TMR67.3 (GND), TMR68.3 (GND), TMR69.3 (GND), TMR70.3 (GND), TMR71.3 (GND), TMR72.3 (GND); also elsewhere on the board
VCCS: Cvcc2.1, Cvcc3.1, Cvcc4.1, Cvcc5.1, Cvcc6.1, Cvcc7.1, Cvcc8.1, Cvcc9.1, Cvcc10.1, Cvcc11.1, Cvcc12.1, Cvcc13.1, Cvcc14.1, Cvcc15.1, Cvcc16.1, Cvcc17.1, Cvcc18.1, Cvcc19.1, Cvcc20.1, Cvcc21.1, Cvcc22.1, Cvcc23.1, Cvcc24.1, Cvcc25.1, Cvcc26.1, Cvcc27.1, Cvcc28.1, Cvcc29.1, Cvcc30.1, Cvcc31.1, Cvcc32.1, Cvcc33.1, Cvcc34.1, Cvcc35.1, Cvcc36.1, Cvcc37.1, Cvcc38.1, Cvcc39.1, Cvcc40.1, Cvcc41.1, Cvcc42.1, Cvcc43.1, Cvcc44.1, Cvcc45.1, Cvcc46.1, Cvcc47.1, Cvcc48.1, Cvcc49.1, Cvcc50.1, Cvcc51.1, Cvcc52.1, Cvcc53.1, Cvcc54.1, Cvcc55.1, Cvcc56.1, Cvcc57.1, Cvcc58.1, Cvcc59.1, Cvcc60.1, Cvcc61.1, Cvcc62.1, Cvcc63.1, Cvcc64.1, Cvcc65.1, Cvcc66.1, Cvcc67.1, Cvcc68.1, Cvcc69.1, Cvcc70.1, Cvcc71.1, Cvcc72.1, TMR2.1 (V_{CC}), TMR3.1 (V_{CC}), TMR4.1 (V_{CC}), TMR5.1 (V_{CC}), TMR6.1 (V_{CC}), TMR7.1 (V_{CC}), TMR8.1 (V_{CC}), TMR9.1 (V_{CC}), TMR10.1 (V_{CC}), TMR11.1 (V_{CC}), TMR12.1 (V_{CC}), TMR13.1 (V_{CC}), TMR14.1 (V_{CC}), TMR15.1 (V_{CC}), TMR16.1 (V_{CC}), TMR17.1 (V_{CC}), TMR18.1 (V_{CC}), TMR19.1 (V_{CC}), TMR20.1 (V_{CC}), TMR21.1 (V_{CC}), TMR22.1 (V_{CC}), TMR23.1 (V_{CC}), TMR24.1 (V_{CC}), TMR25.1 (V_{CC}), TMR26.1 (V_{CC}), TMR27.1 (V_{CC}), TMR28.1 (V_{CC}), TMR29.1 (V_{CC}), TMR30.1 (V_{CC}), TMR31.1 (V_{CC}), TMR32.1 (V_{CC}), TMR33.1 (V_{CC}), TMR34.1 (V_{CC}), TMR35.1 (V_{CC}), TMR36.1 (V_{CC}), TMR37.1 (V_{CC}), TMR38.1 (V_{CC}), TMR39.1 (V_{CC}), TMR40.1 (V_{CC}), TMR41.1 (V_{CC}), TMR42.1 (V_{CC}), TMR43.1 (V_{CC}), TMR44.1 (V_{CC}), TMR45.1 (V_{CC}), TMR46.1 (V_{CC}), TMR47.1 (V_{CC}), TMR48.1 (V_{CC}), TMR49.1 (V_{CC}), TMR50.1 (V_{CC}), TMR51.1 (V_{CC}), TMR52.1 (V_{CC}), TMR53.1 (V_{CC}), TMR54.1 (V_{CC}), TMR55.1 (V_{CC}), TMR56.1 (V_{CC}), TMR57.1 (V_{CC}), TMR58.1 (V_{CC}), TMR59.1 (V_{CC}), TMR60.1 (V_{CC}), TMR61.1 (V_{CC}), TMR62.1 (V_{CC}), TMR63.1 (V_{CC}), TMR64.1 (V_{CC}), TMR65.1 (V_{CC}), TMR66.1 (V_{CC}), TMR67.1 (V_{CC}), TMR68.1 (V_{CC}), TMR69.1 (V_{CC}), TMR70.1 (V_{CC}), TMR71.1 (V_{CC}), TMR72.1 (V_{CC}); also elsewhere on the board

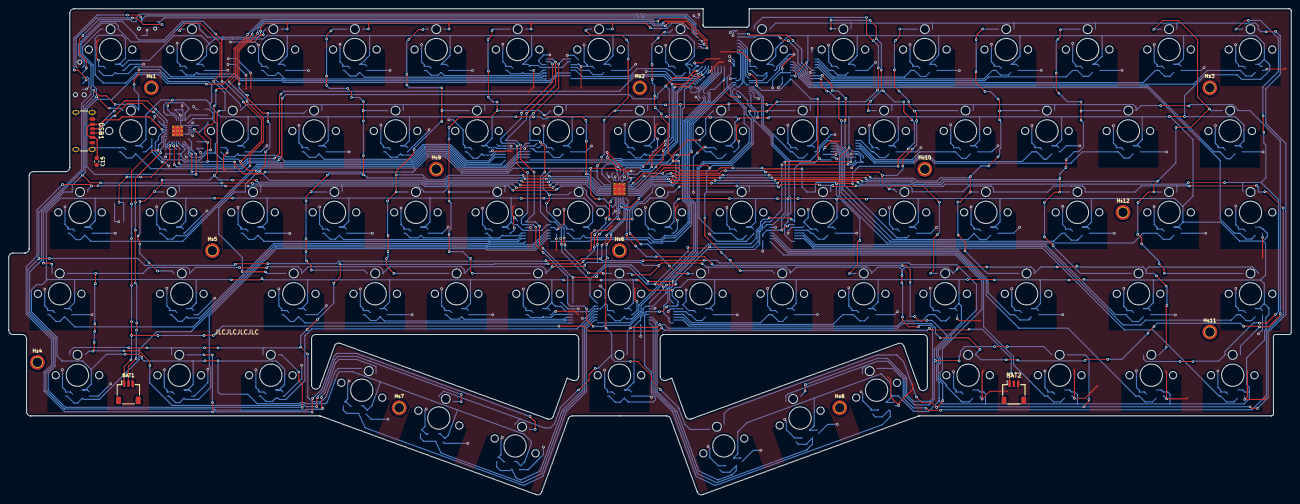
[picture p21: board hardware/nRF54L15_TMR2617_sm_gateron/pcb/pcb.kicad_pcb from above]

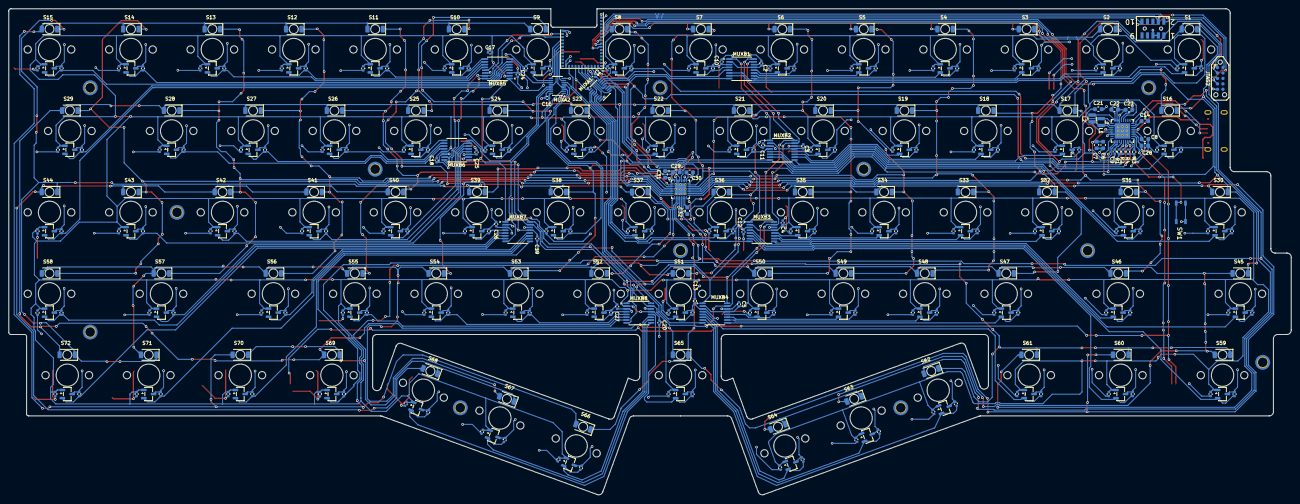
[picture p22: board hardware/nRF54L15_TMR2617_sm_gateron/pcb/pcb.kicad_pcb from below]

Board: 2 copper layers, 299.2 x 113.4 mm, 432 parts (341 on the bottom side), 140 nets.
