girishji/tmr-keyboard/hardware/nRF54L15_TMR2617_sm_gateron/sw_prototype/sw_prototype.kicad_pcb

## KiCad design hardware/nRF54L15_TMR2617_sm_gateron/sw_prototype/sw_prototype.kicad_pcb (2025-11-09)

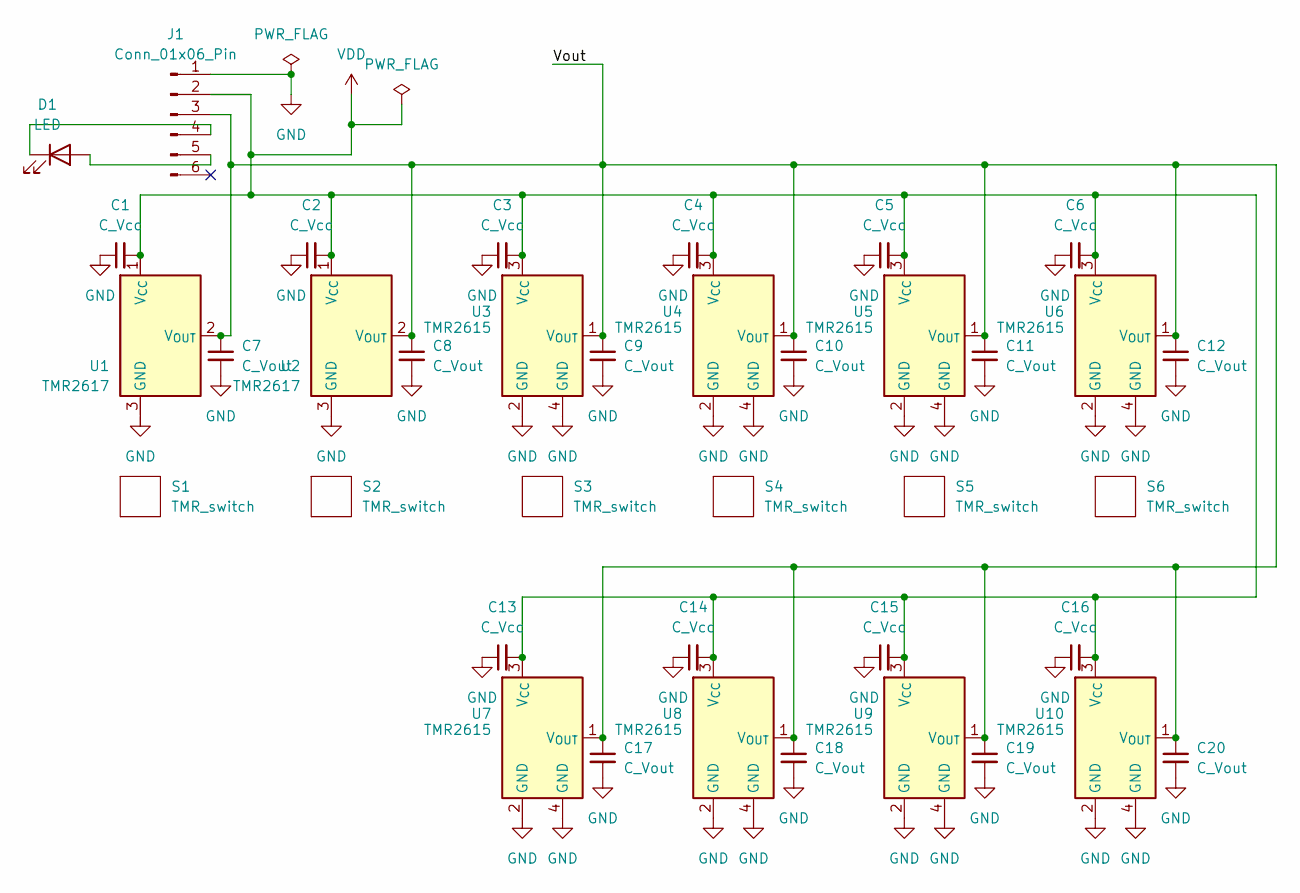
[picture p23: schematic sw_prototype.kicad_sch]

Parts:
C1, C2, C3, C4, C5, C6, C13, C14, C15, C16: C_Vcc; C_0603_1608Metric
C7, C8, C9, C10, C11, C12, C17, C18, C19, C20: C_Vout; C_0603_1608Metric
D1: LED; LED_1206_THT
J1: Conn_01x06_Pin; PinHeader_1x06_P2.54mm_Vertical
S1, S2, S3, S4, S5, S6: TMR_switch; combined_sw_lowpro
U1, U2: TMR2617; SOT-23-3
U3, U4, U5, U6, U7, U8, U9, U10: TMR2615; DFN-3L-1.6x1.6

Connections:
/Vout: C7.1, C8.1, C9.1, C10.1, C11.1, C12.1, C17.1, C18.1, C19.1, C20.1, J1.3, U1.2 (V_{OUT}), U2.2 (V_{OUT}), U3.1 (V_{OUT}), U4.1 (V_{OUT}), U5.1 (V_{OUT}), U6.1 (V_{OUT}), U7.1 (V_{OUT}), U8.1 (V_{OUT}), U9.1 (V_{OUT}), U10.1 (V_{OUT})
GND: C1.1, C2.1, C3.1, C4.1, C5.1, C6.1, C7.2, C8.2, C9.2, C10.2, C11.2, C12.2, C13.1, C14.1, C15.1, C16.1, C17.2, C18.2, C19.2, C20.2, J1.1, U1.3 (GND), U2.3 (GND), U3.2 (GND), U3.4 (GND), U4.2 (GND), U4.4 (GND), U5.2 (GND), U5.4 (GND), U6.2 (GND), U6.4 (GND), U7.2 (GND), U7.4 (GND), U8.2 (GND), U8.4 (GND), U9.2 (GND), U9.4 (GND), U10.2 (GND), U10.4 (GND)
unnamed: D1.2 (A), J1.5
unnamed: D1.1 (K), J1.4
VDD: C1.2, C2.2, C3.2, C4.2, C5.2, C6.2, C13.2, C14.2, C15.2, C16.2, J1.2, U1.1 (V_{CC}), U2.1 (V_{CC}), U3.3 (V_{CC}), U4.3 (V_{CC}), U5.3 (V_{CC}), U6.3 (V_{CC}), U7.3 (V_{CC}), U8.3 (V_{CC}), U9.3 (V_{CC}), U10.3 (V_{CC})
