girishji/tmr-keyboard/hardware/nRF54L15_TMR2617_sm_gateron/sw_prototype/sw_prototype.kicad_pcb

## KiCad design hardware/nRF54L15_TMR2617_sm_gateron/sw_prototype/sw_prototype.kicad_pcb (continued)

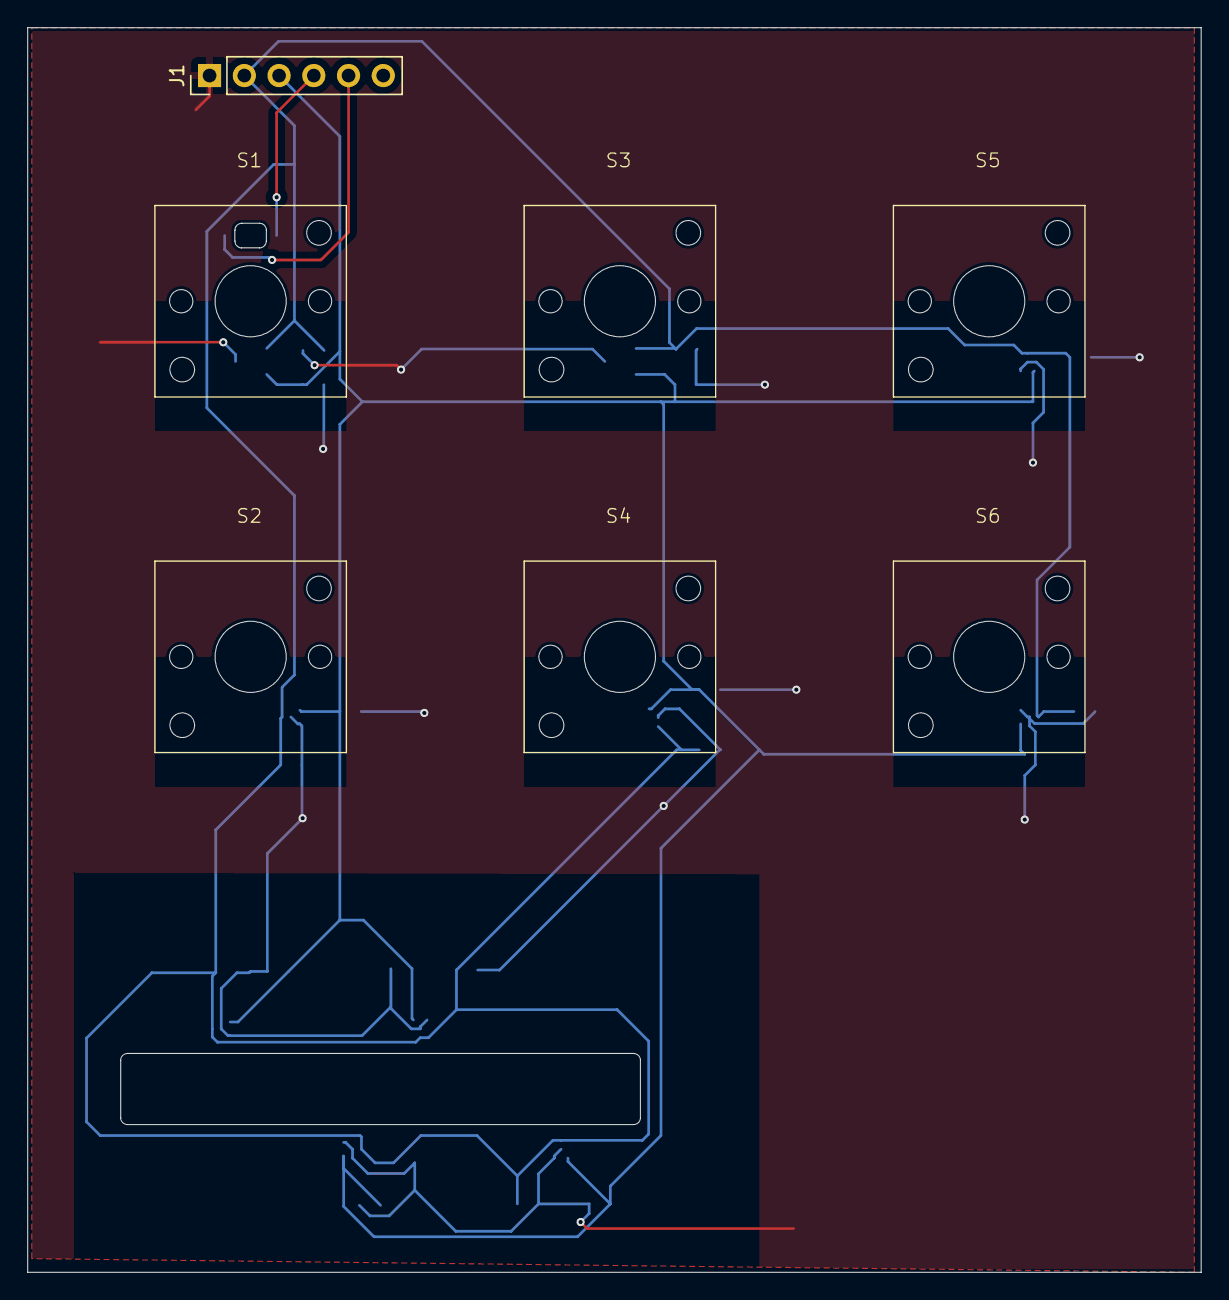
[picture p24: board sw_prototype.kicad_pcb from above]

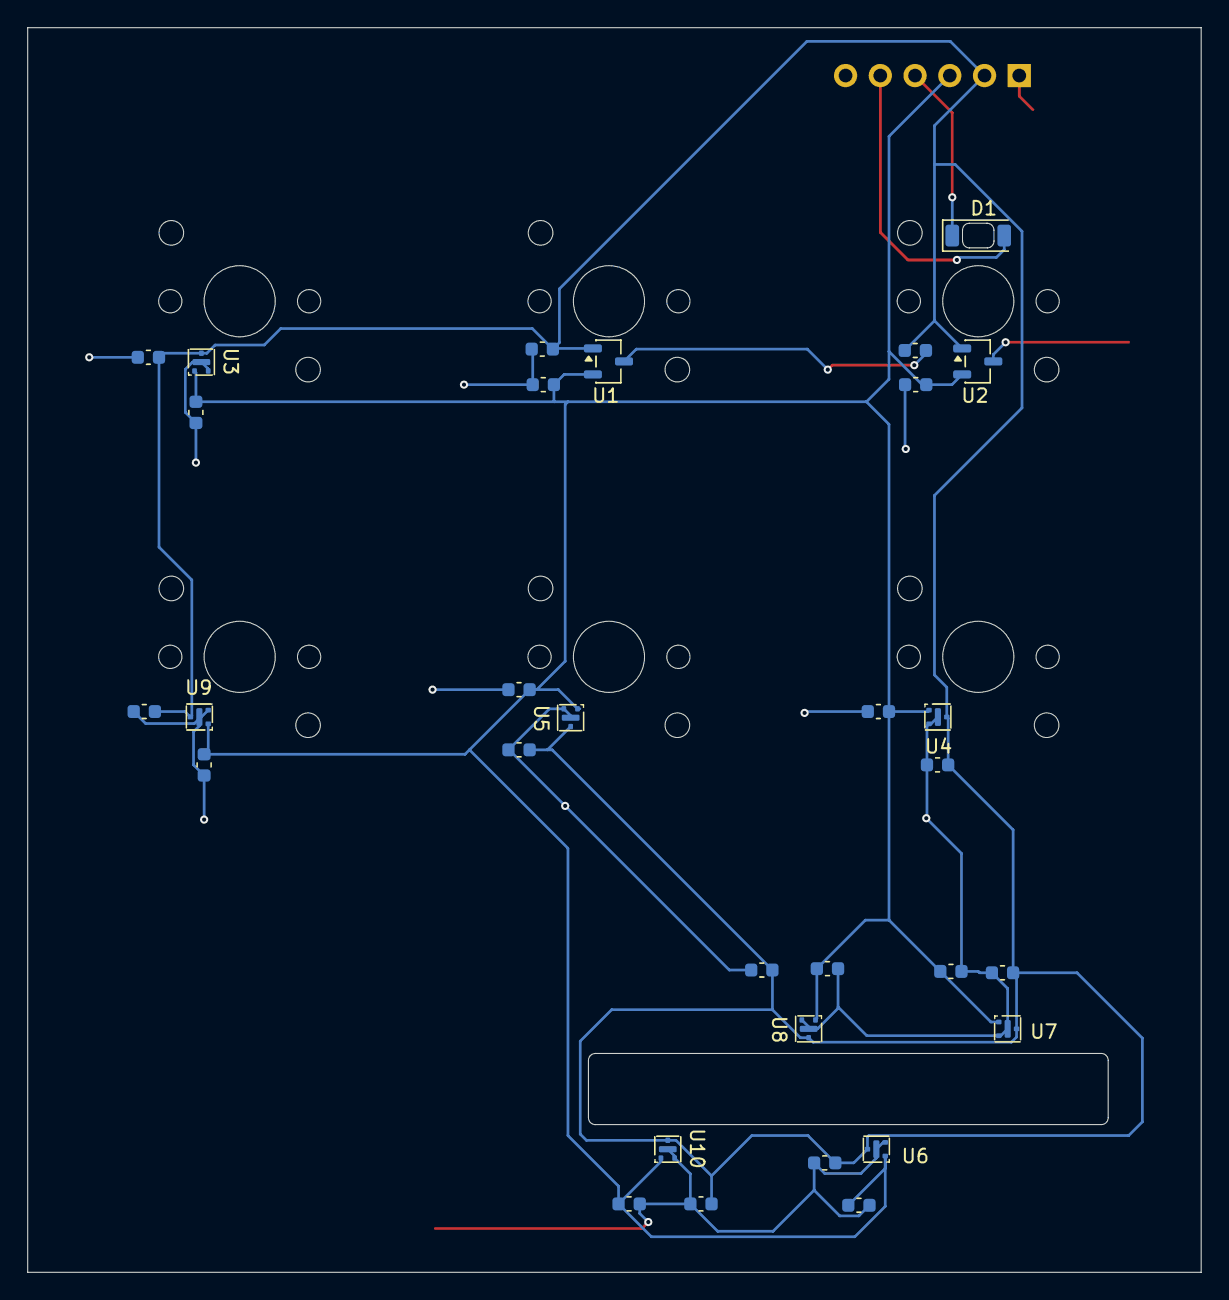
[picture p25: board sw_prototype.kicad_pcb from below]

Board: 2 copper layers, 85.8 x 91.0 mm, 38 parts (31 on the bottom side), 5 nets.
