girishji/tmr-keyboard/hardware/nRF54L15_TMR2615_cnc_usbtop/pcb/LED.kicad_sch

## KiCad design hardware/nRF54L15_TMR2615_cnc_usbtop/pcb/LED.kicad_sch (2025-12-21)

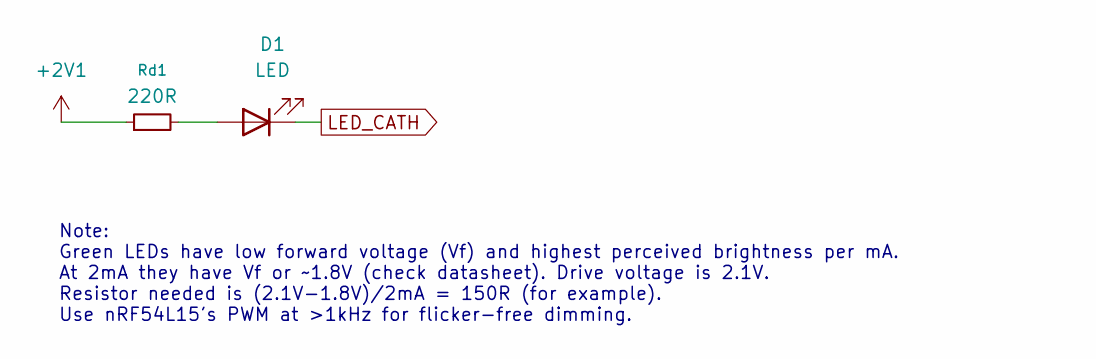
[picture p28: schematic LED.kicad_sch]

Parts:
D1: LED; LED_1206_3216Metric_ReverseMount_Hole2.1mm
Rd1: 220R; R_0402_1005Metric

Connections:
+2V1: Rd1.1
LED_CATH: D1.1 (K)
unnamed: D1.2 (A), Rd1.2

Notes on the sheet:
Note: Green LEDs have low forward voltage (Vf) and highest perceived brightness per mA. At 2mA they have Vf or ~1.8V (check datasheet). Drive voltage is 2.1V. Resistor needed is (2.1V-1.8V)/2mA = 150R (for example). Use nRF54L15's PWM at >1kHz for flicker-free dimming.
