girishji/tmr-keyboard/(commit log)

2025-11-09 A .gitignore A notes/calc.md A notes/components.md A notes/notes.md A sw_prototype/fp-lib-table A sw_prototype/sw_prototype.kicad_pcb A sw_prototype/sw_prototype.kicad_prl A sw_prototype/sw_prototype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
    [sw_prototype.kicad_pcb, sw_prototype.kicad_sch]
2025-11-16 A border.py M notes/notes.md A pcb/fp-lib-table A pcb/pcb-Edge_Cuts.dxf A pcb/pcb.kicad_pcb A pcb/pcb.kicad_prl A pcb/pcb.kicad_pro A pcb/pcb.kicad_sch A pcb/pcb.step A pcb/sym-lib-table A pickle.py 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
    [pcb-Edge_Cuts.dxf, pcb.kicad_pcb, pcb.kicad_sch, pcb.step, plate.kicad_pcb, plate.kicad_sch]
2025-11-16 M .gitignore D pcb/pcb.step
    [pcb.step]
2025-11-21 A notes/is31fl3731.md A notes/led.md A notes/nRF52840.md M notes/notes.md M pcb/pcb.kicad_pcb A pcb/~pcb.kicad_pcb.lck
    [pcb.kicad_pcb]
2025-11-21 M border.py M place.py R pcb/~pcb.kicad_pcb.lck -> plate/~plate.kicad_pcb.lck
2025-11-21 M .gitignore D plate/~plate.kicad_pcb.lck
2025-11-21 M border.py M plate/plate.kicad_pcb
    [plate.kicad_pcb]
2025-11-21 M border.py M place.py M plate/plate.kicad_pcb M plate/plate.kicad_sch
    [plate.kicad_pcb, plate.kicad_sch]
2025-11-24 A RP2040_Minimal.kicad_sym A RP2040_minimal.pretty/8-USON-Handsolder.kicad_mod A RP2040_minimal.pretty/8-USON.kicad_mod A RP2040_minimal.pretty/C_0402_1005Metric.kicad_mod A RP2040_minimal.pretty/C_0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
    [pcb.kicad_pcb, pcb.kicad_sch, plate.kicad_pcb, plate.kicad_sch]
2025-11-29 M border.py A notes/keyfrequency M pcb/pcb.kicad_pcb M pcb/pcb.kicad_prl M pcb/pcb.kicad_sch M place.py A tmr-footprints/LED-6028.kicad_mod D tmr-footprints/LED_1206_THT.kicad_mod M tmr-footprints/sw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
    [pcb.kicad_pcb, pcb.kicad_sch]
2025-11-30 M border.py M notes/components.md A notes/mcu M pcb/pcb.kicad_pcb M place.py M plate/plate.kicad_pcb M plate/plate.kicad_sch
    [pcb.kicad_pcb, plate.kicad_pcb, plate.kicad_sch]
2025-12-01 M notes/components.md M pcb/pcb.kicad_pcb M pcb/pcb.kicad_sch M place.py D tmr-footprints/sw_lowpro_combo_2u_MDT.kicad_mod D tmr-footprints/sw_lowpro_combo_2u_MDT_L.kicad_mod D tmr-footprints/sw_lowp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
    [pcb.kicad_pcb, pcb.kicad_sch]
2025-12-01 M border.py M place.py M plate/plate.kicad_pcb M plate/plate.kicad_pro M tmr-footprints/Switch_Cutout.kicad_mod
    [plate.kicad_pcb]
2025-12-03 M border.py A notes/cnc.md M notes/components.md M notes/nRF52840.md M notes/notes.md A notes/parts M pcb/pcb.kicad_pcb M plate/plate.kicad_pcb
    [pcb.kicad_pcb, plate.kicad_pcb]
2025-12-04 M border.py M notes/cnc.md M notes/nRF52840.md M notes/notes.md M pcb/pcb.kicad_pcb M pcb/pcb.kicad_sch M pcb/sym-lib-table M place.py M plate/plate.kicad_pcb M plate/plate.kicad_sch A tmr-footprints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
    [pcb.kicad_pcb, pcb.kicad_sch, plate.kicad_pcb, plate.kicad_sch]
2025-12-06 M border.py M notes/notes.md M pcb/pcb.kicad_pcb M pcb/pcb.kicad_prl M pcb/pcb.kicad_pro M pcb/pcb.kicad_sch M pcb/sym-lib-table M place.py M tmr-footprints/C_0603_1608Metric.kicad_mod D tmr-footprin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
    [pcb.kicad_pcb, pcb.kicad_sch]
2025-12-10 M notes/nRF52840.md M notes/notes.md A notes/spi M pcb/pcb.kicad_pcb M pcb/pcb.kicad_prl M pcb/pcb.kicad_pro M pcb/pcb.kicad_sch M pickle.py D place.py A placefp.py D remove_tracks.py A rmtracks.py M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
    [pcb.kicad_pcb, pcb.kicad_sch]
2025-12-11 R pickle.py -> dumploc.py M notes/spi M pcb/pcb.kicad_pcb M pcb/pcb.kicad_prl M pcb/pcb.kicad_pro M pcb/pcb.kicad_sch M placefp.py M tmr-footprints/LED-6028.kicad_mod
    [pcb.kicad_pcb, pcb.kicad_sch]
2025-12-11 M notes/spi M pcb/pcb.kicad_pcb M pcb/pcb.kicad_sch M placefp.py A tracks.py
    [pcb.kicad_pcb, pcb.kicad_sch]
2025-12-13 M notes/nRF52840.md A notes/soldering M pcb/pcb.kicad_pcb M pcb/pcb.kicad_pro M pcb/pcb.kicad_sch M placefp.py M tmr-footprints/sw_lowpro_gateron_MDT.kicad_mod M tmr-symbols.kicad_sym M tracks.py
    [pcb.kicad_pcb, pcb.kicad_sch]
2025-12-15 A notes/analog D notes/cnc.md D notes/components.md R notes/is31fl3731.md -> notes/is31fl3731 D notes/led.md D notes/mcu D notes/nRF52840.md A notes/nrf R notes/calc.md -> notes/tmr M pcb/pcb.kicad_p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
    [pcb.kicad_pcb]
2025-12-18 A nordic-lib-kicad-npm.kicad_sym M notes/analog A notes/charging A notes/leds A notes/loadsw R notes/notes.md -> notes/notes A notes/nuts M notes/parts A notes/scan A pcb/LED.kicad_sch M pcb/pcb.kica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
    [LED.kicad_sch, pcb.kicad_sch, switch.kicad_sch]
2025-12-21 A notes/bypasscaps A notes/keytravel M notes/leds A notes/muxadc M notes/notes A notes/pulldown M notes/scan A notes/swupdate M pcb/LED.kicad_sch M pcb/pcb.kicad_pcb M pcb/pcb.kicad_prl M pcb/pcb.kic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
    [LED.kicad_sch, pcb.kicad_pcb, pcb.kicad_sch, switch.kicad_sch]
2025-12-22 D notes/analog D notes/bypasscaps D notes/charging D notes/fusion D notes/is31fl3731 D notes/keyfrequency D notes/keytravel D notes/leds D notes/loadsw D notes/muxadc D notes/notes D notes/nrf D note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
    [pcb.kicad_sch, switch.kicad_sch]
2025-12-23 M pcb/pcb.kicad_sch A tmr-footprints/L_Samsung_CIGT201610EH2R2MNE.kicad_mod D tmr-footprints/Murata_DFE201210U.kicad_mod M tmr-symbols.kicad_sym
    [pcb.kicad_sch]
2025-12-27 M pcb/pcb.kicad_pcb M pcb/pcb.kicad_sch M pcb/switch.kicad_sch M placefp.py A tmr-footprints/Texas_DYY0016A_TSOT-23-16_2x4.2mm_P0.5mm.kicad_mod M tmr-symbols.kicad_sym
    [pcb.kicad_pcb, pcb.kicad_sch, switch.kicad_sch]
2025-12-28 M pcb/pcb.kicad_pcb M pcb/pcb.kicad_prl M pcb/pcb.kicad_pro M pcb/pcb.kicad_sch M pcb/switch.kicad_sch M placefp.py M tracks.py
    [pcb.kicad_pcb, pcb.kicad_sch, switch.kicad_sch]
2025-12-28 M pcb/pcb.kicad_pcb M pcb/pcb.kicad_prl M pcb/pcb.kicad_pro M pcb/pcb.kicad_sch M placefp.py
    [pcb.kicad_pcb, pcb.kicad_sch]
2025-12-29 M pcb/pcb.kicad_pcb M pcb/pcb.kicad_prl M pcb/pcb.kicad_pro M pcb/pcb.kicad_sch M placefp.py A tmr-footprints/SAMTEC-CLP-105-02-X-D-A-altium.kicad_mod A tmr-footprints/SAMTEC-CLP-105-02-X-D-A.kicad_m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
    [pcb.kicad_pcb, pcb.kicad_sch]
2025-12-29 M pcb/pcb.kicad_pcb M pcb/pcb.kicad_prl M pcb/pcb.kicad_sch M placefp.py M tmr-footprints/Ezurio_BL54L15_Module.kicad_mod
    [pcb.kicad_pcb, pcb.kicad_sch]
2025-12-30 M pcb/pcb.kicad_pcb M pcb/pcb.kicad_prl
    [pcb.kicad_pcb]
2026-01-02 M pcb/pcb.kicad_pcb M pcb/pcb.kicad_prl M pcb/pcb.kicad_sch M pcb/switch.kicad_sch M placefp.py A tmr-footprints/Button_Switch_3x4x2.5.kicad_mod A tmr-footprints/Panasonic_EVPAE.kicad_mod
    [pcb.kicad_pcb, pcb.kicad_sch, switch.kicad_sch]
2026-01-02 M pcb/pcb.kicad_pcb M pcb/pcb.kicad_sch A tmr-footprints/MountingHole_2.2mm_M2_ISO7380_Pad_TopBottom.kicad_mod
    [pcb.kicad_pcb, pcb.kicad_sch]
2026-01-02 M pcb/pcb.kicad_pcb M pcb/pcb.kicad_prl M pcb/pcb.kicad_pro M pcb/pcb.kicad_sch M placefp.py M tmr-footprints/MountingHole_2.2mm_M2_ISO7380_Pad_TopBottom.kicad_mod M tracks.py
    [pcb.kicad_pcb, pcb.kicad_sch]
2026-01-03 M pcb/pcb.kicad_pcb M pcb/pcb.kicad_prl M pcb/pcb.kicad_sch D tmr-footprints/MountingHole_2.2mm_M2_ISO7380_Pad_TopBottom.kicad_mod
    [pcb.kicad_pcb, pcb.kicad_sch]
2026-01-03 M pcb/pcb.kicad_pcb M pcb/pcb.kicad_prl M pcb/pcb.kicad_pro M placefp.py
    [pcb.kicad_pcb]
2026-01-03 M pcb/pcb.kicad_pcb
    [pcb.kicad_pcb]
2026-01-03 M pcb/pcb.kicad_pro
2026-01-05 R README.md -> ver1/README.md R RP2040_Minimal.kicad_sym -> ver1/RP2040_Minimal.kicad_sym R RP2040_minimal.pretty/8-USON-Handsolder.kicad_mod -> ver1/RP2040_minimal.pretty/8-USON-Handsolder.kicad_mod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
    [LED.kicad_sch, pcb-Edge_Cuts.dxf, pcb.kicad_sch, plate.kicad_pcb, plate.kicad_sch, sw_prototype.kicad_pcb, sw_prototype.kicad_sch, switch.kicad_sch]
2026-01-05 M ver2/border.py A ver2/pcb/dxf/pcb-Edge_Cuts.gbr A ver2/pcb/dxf/pcb-job.gbrjob
    [pcb-Edge_Cuts.gbr, pcb-job.gbrjob]
2026-01-06 M ver2/border.py M ver2/pcb/dxf/pcb-Edge_Cuts.dxf D ver2/pcb/dxf/pcb-Edge_Cuts.gbr D ver2/pcb/dxf/pcb-job.gbrjob M ver2/pcb/pcb.kicad_pcb M ver2/placefp.py A ver2/plate/dxf/plate-Edge_Cuts.dxf M ver2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
    [plate-Edge_Cuts.dxf, plate.kicad_pcb, plate.kicad_sch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]
2026-01-09 M ver1/border.py M ver1/pcb/fp-lib-table M ver1/pcb/pcb.kicad_pcb M ver1/pcb/pcb.kicad_pro M ver1/pcb/pcb.kicad_sch M ver1/placefp.py M ver1/plate/fp-lib-table M ver1/plate/plate.kicad_pcb M ver1/pla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
    [pcb.kicad_sch, plate.kicad_pcb, plate.kicad_sch]
2026-01-10 M ver1/border.py M ver1/pcb/pcb.kicad_pcb M ver1/pcb/pcb.kicad_prl M ver1/placefp.py A ver1/plate/plate-Edge_Cuts.dxf M ver1/plate/plate.kicad_pcb M ver1/plate/plate.kicad_prl M ver1/tmr-footprints/D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
    [plate-Edge_Cuts.dxf, plate.kicad_pcb]
2026-01-10 M ver1/pcb/pcb.kicad_pcb M ver1/pcb/pcb.kicad_prl
2026-01-11 M ver1/border.py M ver1/pcb/pcb-Edge_Cuts.dxf M ver1/pcb/pcb.kicad_pcb M ver1/pcb/pcb.kicad_prl M ver1/pcb/pcb.kicad_pro M ver1/placefp.py M ver1/tmr-footprints/Gateron_Switch_Lowpro.kicad_mod M ver2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
    [pcb-Edge_Cuts.dxf]
2026-01-11 M ver1/pcb/pcb-Edge_Cuts.dxf M ver1/pcb/pcb.kicad_pcb M ver1/pcb/pcb.kicad_prl
    [pcb-Edge_Cuts.dxf]
2026-01-11 M ver1/pcb/pcb-Edge_Cuts.dxf M ver1/pcb/pcb.kicad_pcb M ver1/tmr-footprints/Gateron_Switch_Lowpro.kicad_mod
    [pcb-Edge_Cuts.dxf]
2026-01-20 A bak/README.md R ver2/RP2040_Minimal.kicad_sym -> bak/RP2040_Minimal.kicad_sym A bak/border.py A bak/dumploc.py A bak/nordic-lib-kicad-npm.kicad_sym A bak/pcb/LED.kicad_sch R ver2/pcb/dxf/pcb-Edge_C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
    [LED.kicad_sch, pcb.kicad_sch, plate-Edge_Cuts.dxf, plate.kicad_pcb, plate.kicad_sch, switch.kicad_sch]
2026-01-21 A ver3/README.md A ver3/border.py A ver3/dumploc.py A ver3/nordic-lib-kicad-npm.kicad_sym A ver3/pcb/LED.kicad_sch A ver3/pcb/fp-lib-table A ver3/pcb/pcb-eagle-import.kicad_sym A ver3/pcb/pcb.kicad_p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
    [LED.kicad_sch, pcb.kicad_sch, plate-Edge_Cuts.dxf, plate.kicad_pcb, plate.kicad_sch, switch.kicad_sch]
2026-01-23 M ver3/border.py M ver3/pcb/pcb.kicad_pcb M ver3/pcb/pcb.kicad_sch M ver3/placefp.py M ver3/tmr-footprints/Gateron_Switch_Lowpro.kicad_mod A ver3/tmr-footprints/Gateron_Switch_Lowpro_2.kicad_mod A ve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
    [pcb.kicad_sch]
2026-01-24 M ver2/border.py M ver2/pcb/pcb.kicad_pcb M ver2/pcb/pcb.kicad_sch M ver2/placefp.py M ver3/border.py
    [pcb.kicad_sch]
2026-01-25 A firmware/boards/Girish/Girish_nRF52840/Girish_nRF52840-pinctrl.dtsi A firmware/boards/Girish/Girish_nRF52840/Girish_nRF52840.dts A firmware/boards/Girish/Girish_nRF52840/Girish_nRF52840.yaml A firm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
2026-01-26 D bak/border.py D bak/pcb/dxf/pcb-Edge_Cuts.dxf D bak/pcb/pcb.kicad_pcb D bak/pcb/pcb.kicad_prl D bak/pcb/pcb.kicad_pro D bak/pcb/pcb.kicad_sch D bak/placefp.py D bak/plate/dxf/plate-Edge_Cuts.dxf D 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
    [LED.kicad_sch, pcb-Edge_Cuts.dxf, pcb.kicad_sch, plate-Edge_Cuts.dxf, plate.kicad_pcb, plate.kicad_sch, sw_prototype.kicad_pcb, sw_prototype.kicad_sch]
2026-01-27 M firmware/boards/gp/tmr_kbd_nrf52840/tmr_kbd_nrf52840.dts M firmware/prj.conf M firmware/src/main.c
2026-01-30 M hardware/nRF52840_v1/border.py M hardware/nRF52840_v1/pcb/pcb.kicad_pcb M hardware/nRF52840_v1/pcb/pcb.kicad_prl M hardware/nRF52840_v1/pcb/pcb.kicad_pro M hardware/nRF52840_v1/pcb/pcb.kicad_sch M 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
    [pcb.kicad_sch, switch.kicad_sch, usbcover.kicad_pcb, usbcover.kicad_sch]
2026-01-30 M hardware/nRF52840_v1/border.py M hardware/nRF52840_v1/pcb/pcb.kicad_pcb M hardware/nRF52840_v1/pcb/pcb.kicad_prl M hardware/nRF52840_v1/pcb/pcb.kicad_sch M hardware/nRF52840_v1/pcb/switch.kicad_sch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
    [pcb.kicad_sch, switch.kicad_sch]
2026-01-30 D hardware/nRF52840_v1/pcb/usbcover/usbcover.kicad_pcb D hardware/nRF52840_v1/pcb/usbcover/usbcover.kicad_prl D hardware/nRF52840_v1/pcb/usbcover/usbcover.kicad_pro D hardware/nRF52840_v1/pcb/usbcove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
    [usbcover.kicad_pcb, usbcover.kicad_sch]
2026-01-31 M hardware/nRF52840_v1/border.py M hardware/nRF52840_v1/pcb/pcb.kicad_pcb M hardware/nRF52840_v1/placefp.py D hardware/nRF52840_v1/plate/plate-Edge_Cuts.dxf M hardware/nRF52840_v1/plate/plate.kicad_p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
    [plate-Edge_Cuts.dxf, plate.kicad_pcb, plate.kicad_sch]
2026-02-02 M hardware/nRF52840_v1/border.py M hardware/nRF52840_v1/pcb/pcb.kicad_pcb M hardware/nRF52840_v1/pcb/pcb.kicad_prl M hardware/nRF52840_v1/pcb/pcb.kicad_sch M hardware/nRF52840_v1/placefp.py A hardwar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
    [pcb.kicad_sch]
2026-02-04 M hardware/nRF52840_v1/placefp.py M hardware/nRF52840_v2/placefp.py M hardware/nRF52840_v2/plate/plate.kicad_pcb M hardware/nRF52840_v2/plate/plate.kicad_prl M hardware/nRF52840_v2/plate/plate.kicad_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
    [LED.kicad_sch, pcb.kicad_sch, plate.kicad_pcb, plate.kicad_sch, switch.kicad_sch]
2026-02-05 M hardware/nRF52840_v2/plate/plate.kicad_pcb M hardware/nRF52840_v2/plate/plate.kicad_prl M hardware/nRF52840_v2/plate/plate.kicad_pro A hardware/nRF52840_v2/tmr-footprints/MountingHole_1.8mm_M1.6_No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
    [pcb.kicad_sch, plate-Edge_Cuts.dxf, plate.kicad_pcb, plate.kicad_sch]
2026-02-07 A hardware/nRF52840_bakelite_cnc/README.md A hardware/nRF52840_bakelite_cnc/border.py A hardware/nRF52840_bakelite_cnc/dumploc.py A hardware/nRF52840_bakelite_cnc/nordic-lib-kicad-npm.kicad_sym A har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
    [LED.kicad_sch, pcb.kicad_sch, plate.kicad_pcb, plate.kicad_sch, switch.kicad_sch]
2026-02-07 R hardware/nRF52840_v1/README.md -> hardware/nRF52840_aluminum_cnc/README.md R hardware/nRF52840_v2/border.py -> hardware/nRF52840_aluminum_cnc/border.py R hardware/nRF52840_v1/dumploc.py -> hardware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
    [LED.kicad_sch, pcb-Edge_Cuts.dxf, pcb.kicad_sch, plate-Edge_Cuts.dxf, plate.kicad_pcb, plate.kicad_sch, sw_prototype.kicad_pcb, sw_prototype.kicad_sch]
2026-02-08 M hardware/nRF52840_bakelite_cnc/border.py M hardware/nRF52840_bakelite_cnc/pcb/pcb.kicad_pcb M hardware/nRF52840_bakelite_cnc/pcb/pcb.kicad_prl M hardware/nRF52840_bakelite_cnc/pcb/pcb.kicad_sch A h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
    [pcb.kicad_sch]
2026-02-08 M hardware/nRF52840_bakelite_cnc/border.py M hardware/nRF52840_bakelite_cnc/pcb/pcb.kicad_pcb M hardware/nRF52840_bakelite_cnc/pcb/pcb.kicad_prl M hardware/nRF52840_bakelite_cnc/pcb/pcb.kicad_pro M h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
2026-02-08 M hardware/nRF52840_bakelite_cnc/border.py M hardware/nRF52840_bakelite_cnc/pcb/pcb.kicad_prl M hardware/nRF52840_bakelite_cnc/plate/plate.kicad_pcb M hardware/nRF52840_bakelite_cnc/plate/plate.kicad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
    [plate.kicad_pcb, plate.kicad_sch]
2026-02-09 M hardware/nRF52840_bakelite_cnc/border.py A hardware/nRF52840_bakelite_cnc/curves.py M hardware/nRF52840_bakelite_cnc/pcb/pcb.kicad_pcb M hardware/nRF52840_bakelite_cnc/pcb/pcb.kicad_prl
2026-02-10 M hardware/nRF52840_bakelite_cnc/border.py M hardware/nRF52840_bakelite_cnc/pcb/pcb.kicad_pcb M hardware/nRF52840_bakelite_cnc/pcb/pcb.kicad_prl M hardware/nRF52840_bakelite_cnc/pcb/pcb.kicad_pro M h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
    [pcb.kicad_sch, plate.kicad_pcb, plate.kicad_sch, switch.kicad_sch]
2026-02-10 M hardware/nRF52840_bakelite_cnc/border.py M hardware/nRF52840_bakelite_cnc/pcb/pcb.kicad_pcb M hardware/nRF52840_bakelite_cnc/pcb/pcb.kicad_prl M hardware/nRF52840_bakelite_cnc/placefp.py M hardware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
2026-02-11 R hardware/nRF52840_bakelite_cnc/README.md -> hardware/nRF52840_plastic_cnc/README.md R hardware/nRF52840_bakelite_cnc/border.py -> hardware/nRF52840_plastic_cnc/border.py R hardware/nRF52840_bakelit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
    [LED.kicad_sch, pcb.kicad_sch, plate.kicad_pcb, plate.kicad_sch, switch.kicad_sch]
2026-02-11 M hardware/nRF52840_plastic_cnc/border.py A hardware/nRF52840_plastic_cnc/pcb/pcb-Edge_Cuts.dxf M hardware/nRF52840_plastic_cnc/pcb/pcb.kicad_pcb M hardware/nRF52840_plastic_cnc/pcb/pcb.kicad_prl M h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
    [pcb-Edge_Cuts.dxf]
2026-02-11 M hardware/nRF52840_plastic_cnc/border.py M hardware/nRF52840_plastic_cnc/pcb/pcb-Edge_Cuts.dxf M hardware/nRF52840_plastic_cnc/pcb/pcb.kicad_pcb M hardware/nRF52840_plastic_cnc/pcb/pcb.kicad_prl M h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
    [pcb-Edge_Cuts.dxf, pcb.kicad_sch, plate.kicad_pcb, plate.kicad_sch]
2026-02-12 M hardware/nRF52840_plastic_cnc/border.py A hardware/nRF52840_plastic_cnc/pcb/pcb-User_1.dxf A hardware/nRF52840_plastic_cnc/pcb/pcb-User_2.dxf A hardware/nRF52840_plastic_cnc/pcb/pcb-User_3.dxf M ha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
    [pcb-User_1.dxf, pcb-User_2.dxf, pcb-User_3.dxf, plate.kicad_pcb, plate.kicad_sch]
2026-02-13 M hardware/nRF52840_plastic_cnc/border.py M hardware/nRF52840_plastic_cnc/pcb/pcb.kicad_pcb M hardware/nRF52840_plastic_cnc/pcb/pcb.kicad_prl M hardware/nRF52840_plastic_cnc/placefp.py
2026-02-14 A hardware/nRF52840_fr4_cnc/README.md A hardware/nRF52840_fr4_cnc/border.py A hardware/nRF52840_fr4_cnc/curves.py A hardware/nRF52840_fr4_cnc/dumploc.py A hardware/nRF52840_fr4_cnc/nordic-lib-kicad-n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
    [LED.kicad_sch, pcb-Edge_Cuts.dxf, pcb-User_1.dxf, pcb-User_2.dxf, pcb-User_3.dxf, pcb.kicad_sch, plate.kicad_pcb, plate.kicad_sch]
2026-02-14 R hardware/nRF52840_plastic_cnc/README.md -> hardware/nRF52840_abs_cnc/README.md R hardware/nRF52840_plastic_cnc/border.py -> hardware/nRF52840_abs_cnc/border.py R hardware/nRF52840_plastic_cnc/curve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
    [LED.kicad_sch, pcb-Edge_Cuts.dxf, pcb-User_1.dxf, pcb-User_2.dxf, pcb-User_3.dxf, pcb.kicad_sch, plate.kicad_pcb, plate.kicad_sch]
2026-02-14 M hardware/nRF52840_fr4_cnc/border.py M hardware/nRF52840_fr4_cnc/pcb/pcb.kicad_pcb M hardware/nRF52840_fr4_cnc/pcb/pcb.kicad_prl M hardware/nRF52840_fr4_cnc/placefp.py M hardware/nRF52840_fr4_cnc/tm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
2026-02-14 M hardware/nRF52840_fr4_cnc/plate/plate.kicad_pcb
    [plate.kicad_pcb]
2026-02-15 R hardware/nRF52840_abs_cnc/README.md -> hardware/nRF52840_cnc_usb_side/README.md R hardware/nRF52840_fr4_cnc/border.py -> hardware/nRF52840_cnc_usb_side/border.py R hardware/nRF52840_abs_cnc/curves.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
    [LED.kicad_sch, pcb-Edge_Cuts.dxf, pcb-User_1.dxf, pcb-User_2.dxf, pcb-User_3.dxf, pcb.kicad_sch, plate-Edge_Cuts.dxf, plate.kicad_pcb]
2026-02-15 D hardware/nRF52840_aluminum_cnc/border.py D hardware/nRF52840_aluminum_cnc/tmr-footprints/SAMTEC-CLP-105-02-X-D-A-altium.kicad_mod D hardware/nRF52840_aluminum_cnc/tmr-footprints/sw_lowpro_combo_MDT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
    [LED.kicad_sch, pcb-Edge_Cuts.dxf, pcb-User_3.dxf, pcb-User_5.dxf, pcb-User_6.dxf, pcb.kicad_sch, plate-Edge_Cuts.dxf, plate.kicad_pcb]
2026-02-18 R hardware/nRF52840_cnc_usb_side/README.md -> hardware/nRF52840_cnc_abs/README.md R hardware/nRF52840_cnc_usb_top/border.py -> hardware/nRF52840_cnc_abs/border.py R hardware/nRF52840_cnc_usb_side/cur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
    [LED.kicad_sch, pcb-Edge_Cuts.dxf, pcb-User_1.dxf, pcb-User_2.dxf, pcb-User_3.dxf, pcb-User_5.dxf, pcb-User_6.dxf, pcb.kicad_sch]
2026-02-23 M hardware/nRF54L15_gateron/pcb/pcb.kicad_prl M hardware/nRF54L15_kailh/border.py M hardware/nRF54L15_kailh/pcb/pcb.kicad_pcb M hardware/nRF54L15_kailh/pcb/pcb.kicad_prl M hardware/nRF54L15_kailh/pcb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
    [pcb.kicad_sch]
2026-02-23 M hardware/nRF54L15_kailh/pcb/pcb.kicad_pcb M hardware/nRF54L15_kailh/tmr-footprints/Kailh_sw_lowpro.kicad_mod M hardware/nRF54L15_kailh/tmr-footprints/Texas_DYY0016A_TSOT-23-16_2x4.2mm_P0.5mm.kicad_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
2026-02-25 M hardware/nRF54L15_kailh/border.py A hardware/nRF54L15_kailh/pcb/pcb-F_Fab.dxf M hardware/nRF54L15_kailh/pcb/pcb.kicad_pcb M hardware/nRF54L15_kailh/pcb/pcb.kicad_prl M hardware/nRF54L15_kailh/pcb/p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
    [pcb-F_Fab.dxf, pcb.kicad_sch, plate-User_5.dxf, plate.kicad_pcb, plate.kicad_sch]
2026-02-25 M hardware/nRF54L15_kailh/plate/plate.kicad_pcb
    [plate.kicad_pcb]
2026-02-26 M .gitignore M hardware/nRF54L15_kailh/border.py M hardware/nRF54L15_kailh/pcb/pcb.kicad_pcb M hardware/nRF54L15_kailh/pcb/pcb.kicad_prl M hardware/nRF54L15_kailh/placefp.py D hardware/nRF54L15_kailh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
    [plate-Edge_Cuts.dxf, plate-User_5.dxf, plate.kicad_pcb, plate.kicad_sch, swplate.kicad_pcb, swplate.kicad_sch, topcase.kicad_pcb, topcase.kicad_sch]
2026-02-26 M .gitignore M hardware/nRF54L15_kailh/border.py M hardware/nRF54L15_kailh/swplate/swplate.kicad_pcb M hardware/nRF54L15_kailh/swplate/swplate.kicad_sch ?? hardware/resources/
    [swplate.kicad_pcb, swplate.kicad_sch]
2026-02-26 M .gitignore A hardware/resources/MDT-Linear-Sensors-TMR2615x-AAC-Datasheet-EN-V1.3.2.pdf A hardware/resources/MDT-Linear-Sensors-TMR2617S-AAC-Datasheet-EN-V1.1.2.pdf
2026-02-28 M .gitignore M hardware/nRF54L15_kailh/border.py A hardware/nRF54L15_kailh/pat1.kicad_mod A hardware/nRF54L15_kailh/pat1.kicad_sym A hardware/nRF54L15_kailh/pat2.kicad_mod A hardware/nRF54L15_kailh/p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
    [swplate.kicad_pcb]
2026-03-02 M hardware/nRF54L15_kailh/border.py D hardware/nRF54L15_kailh/botcase/botcase-Edge_Cuts.dxf D hardware/nRF54L15_kailh/botcase/botcase-Edge_Cuts.gm1 D hardware/nRF54L15_kailh/botcase/botcase-Edge_Cuts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
    [botcover.kicad_pcb, botcover.kicad_sch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]
2026-03-03 M hardware/nRF54L15_kailh/border.py M hardware/nRF54L15_kailh/botcover/botcover.kicad_pcb M hardware/nRF54L15_kailh/botcover/botcover.kicad_sch M hardware/nRF54L15_kailh/pcb/pcb.kicad_pcb M hardware/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
    [botcover.kicad_pcb, botcover.kicad_sch, pcb.kicad_sch]
2026-03-03 M hardware/nRF54L15_kailh/border.py M hardware/nRF54L15_kailh/botcover/botcover.kicad_pcb
    [botcover.kicad_pcb]
2026-03-03 M .gitignore A hardware/.gitignore M hardware/nRF54L15_kailh/border.py M hardware/nRF54L15_kailh/botcover/botcover.kicad_pcb M hardware/nRF54L15_kailh/botcover/botcover.kicad_pro
    [botcover.kicad_pcb]
2026-03-03 M hardware/nRF54L15_kailh/botcover/botcover.kicad_pcb
    [botcover.kicad_pcb]
2026-03-06 M .gitignore A hardware/nRF54L15_gateron_kailh_TMR2615/LED.kicad_sch A hardware/nRF54L15_gateron_kailh_TMR2615/fp-lib-table A hardware/nRF54L15_gateron_kailh_TMR2615/nRF54L15_gateron_kailh_TMR2615.ki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
    [LED.kicad_sch, botcase.kicad_pcb, botcase.kicad_sch, botcover.kicad_pcb, botcover.kicad_sch, nRF54L15_gateron_kailh_TMR2615.kicad_sch, switch.kicad_sch, swplate.kicad_pcb]
2026-03-06 M hardware/nRF54L15_kailh/border.py M hardware/nRF54L15_kailh/botcover/botcover.kicad_pcb M hardware/nRF54L15_kailh/botcover/botcover.kicad_sch M hardware/nRF54L15_kailh/placefp.py A hardware/nRF54L1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
    [botcover.kicad_pcb, botcover.kicad_sch]
2026-04-06 A hardware/nRF54L15_TMR2615_3dp/border.py A hardware/nRF54L15_TMR2615_3dp/nordic-lib-kicad-npm.kicad_sym R hardware/nRF54L15_gateron_kailh_TMR2615/LED.kicad_sch -> hardware/nRF54L15_TMR2615_3dp/pcb/L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
    [LED.kicad_sch, pcb.kicad_sch, switch.kicad_sch]
2026-08-11 R hardware/nRF52840_cnc_abs/README.md -> hardware/nRF52840_TMR2617_cnc_gat_usbside/README.md R hardware/nRF52840_cnc_fr4/border.py -> hardware/nRF52840_TMR2617_cnc_gat_usbside/border.py R hardware/nR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
    [LED.kicad_sch, botcase.kicad_pcb, botcase.kicad_sch, botcover.kicad_pcb, botcover.kicad_sch, pcb-Edge_Cuts.dxf, pcb-User_1.dxf, pcb-User_2.dxf]
2026-08-11 M hardware/nRF54LM20_TMR2615/pcb/.history/pcb.kicad_pcb M hardware/nRF54LM20_TMR2615/pcb/pcb.kicad_pcb M hardware/nRF54LM20_TMR2615/pcb/pcb.kicad_prl
    [pcb.kicad_pcb]
2026-08-12 R hardware/nRF52840_TMR2617_cnc_gat_usbside/README.md -> hardware/archive/nRF52840_TMR2617_cnc_gat_usbside/README.md R hardware/nRF52840_TMR2617_cnc_gat_usbside/border.py -> hardware/archive/nRF52840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
    [LED.kicad_sch, botcase.kicad_pcb, botcase.kicad_sch, botcover.kicad_pcb, botcover.kicad_sch, pcb.kicad_pcb, pcb.kicad_sch, plate.kicad_pcb]
2026-08-15 A hardware/nRF54LM20_TMR2615/cohr M hardware/nRF54LM20_TMR2615/pcb/pcb.kicad_pcb M hardware/nRF54LM20_TMR2615/pcb/pcb.kicad_prl M hardware/nRF54LM20_TMR2615/placefp.py M hardware/nRF54LM20_TMR2615/sw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
    [pcb.kicad_pcb, swplate.kicad_pcb, swplate.kicad_sch]
2026-08-15 M hardware/nRF54LM20_TMR2615/pcb/pcb.kicad_pcb
    [pcb.kicad_pcb]
2026-08-17 M hardware/nRF54LM20_TMR2615/border.py M hardware/nRF54LM20_TMR2615/pcb/pcb.kicad_pcb M hardware/nRF54LM20_TMR2615/pcb/pcb.kicad_prl M hardware/nRF54LM20_TMR2615/placefp.py M hardware/nRF54LM20_TMR26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
    [pcb.kicad_pcb, swplate.kicad_pcb]
2026-08-17 M hardware/nRF54LM20_TMR2615/swplate/swplate.kicad_pcb
    [swplate.kicad_pcb]
2026-08-17 M hardware/nRF54LM20_TMR2615/border.py M hardware/nRF54LM20_TMR2615/swplate/swplate.kicad_pcb
    [swplate.kicad_pcb]
2026-08-20 M hardware/nRF54LM20_TMR2615/border.py D hardware/nRF54LM20_TMR2615/cohr M hardware/nRF54LM20_TMR2615/pcb/pcb.kicad_pcb M hardware/nRF54LM20_TMR2615/pcb/pcb.kicad_pro M hardware/nRF54LM20_TMR2615/pcb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
    [pcb.kicad_pcb, pcb.kicad_sch, switch.kicad_sch]
2026-08-20 A hardware/nRF54LM20_TMR2615/layout_tools/border.py A hardware/nRF54LM20_TMR2615/layout_tools/icon1.png A hardware/nRF54LM20_TMR2615/layout_tools/icon2.png A hardware/nRF54LM20_TMR2615/layout_tools/p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
    [pcb.kicad_pcb]
2026-08-20 M hardware/nRF54LM20_TMR2615/border.py M hardware/nRF54LM20_TMR2615/layout_tools/border.py M hardware/nRF54LM20_TMR2615/layout_tools/placefp.py M hardware/nRF54LM20_TMR2615/layout_tools/plugin.json M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
    [pcb.kicad_pcb, swplate.kicad_pcb]
2026-08-21 A hardware/nRF54LM20_TMR2615/Bezier.py D hardware/nRF54LM20_TMR2615/border.py M hardware/nRF54LM20_TMR2615/layout_tools/placefp.py A hardware/nRF54LM20_TMR2615/pcb/pcb-unsaved-export-VXg1D0.kicad_prl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
    [pcb.kicad_pcb, pcb.kicad_sch, swplate.kicad_pcb]
2026-08-22 M hardware/nRF54LM20_TMR2615/layout_tools/border.py M hardware/nRF54LM20_TMR2615/layout_tools/placefp.py M hardware/nRF54LM20_TMR2615/pcb/pcb.kicad_pcb M hardware/nRF54LM20_TMR2615/pcb/pcb.kicad_prl 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
2026-08-22 M hardware/nRF54LM20_TMR2615/pcb/pcb.kicad_pcb M hardware/nRF54LM20_TMR2615/pcb/pcb.kicad_prl M hardware/nRF54LM20_TMR2615/swplate/swplate.kicad_pcb M hardware/nRF54LM20_TMR2615/swplate/swplate.kicad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
    [pcb.kicad_pcb, swplate.kicad_pcb, swplate.kicad_sch]
2026-08-22 M hardware/nRF54LM20_TMR2615/pcb/pcb.kicad_pcb M hardware/nRF54LM20_TMR2615/pcb/pcb.kicad_prl M hardware/nRF54LM20_TMR2615/pcb/pcb.kicad_sch M hardware/nRF54LM20_TMR2615/tmr-footprints/TMR2615-DFN-3L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
    [pcb.kicad_pcb, pcb.kicad_sch]
2026-08-23 M hardware/nRF54LM20_TMR2615/layout_tools/border.py M hardware/nRF54LM20_TMR2615/layout_tools/placefp.py M hardware/nRF54LM20_TMR2615/swplate/swplate.kicad_pcb M hardware/nRF54LM20_TMR2615/swplate/sw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
2026-08-23 M hardware/nRF54LM20_TMR2615/swplate/swplate.kicad_pcb M hardware/nRF54LM20_TMR2615/swplate/swplate.kicad_sch A hardware/nRF54LM20_TMR2615/tmr-footprints/MountingHole_3.2mm_M3_Heatsink_3.6mm.kicad_mod
    [swplate.kicad_pcb, swplate.kicad_sch]
2026-08-23 M hardware/nRF54LM20_TMR2615/layout_tools/border.py M hardware/nRF54LM20_TMR2615/pcb/pcb.kicad_pcb
    [pcb.kicad_pcb]
2026-08-23 M hardware/nRF54LM20_TMR2615/pcb/pcb.kicad_pcb M hardware/nRF54LM20_TMR2615/pcb/pcb.kicad_prl M hardware/nRF54LM20_TMR2615/tmr-footprints/C_0402_1005Metric_Cvout.kicad_mod M hardware/nRF54LM20_TMR261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
    [pcb.kicad_pcb]
2026-08-24 M hardware/nRF54LM20_TMR2615/layout_tools/border.py M hardware/nRF54LM20_TMR2615/pcb/pcb.kicad_pcb M hardware/nRF54LM20_TMR2615/pcb/pcb.kicad_prl M hardware/nRF54LM20_TMR2615/swplate/swplate.kicad_pcb
    [pcb.kicad_pcb, swplate.kicad_pcb]
2026-09-06 M hardware/nRF54LM20_TMR2615/layout_tools/border.py M hardware/nRF54LM20_TMR2615/layout_tools/placefp.py M hardware/nRF54LM20_TMR2615/pcb/pcb.kicad_pcb M hardware/nRF54LM20_TMR2615/pcb/pcb.kicad_prl 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
2026-09-07 A hardware/nRF54LM20_TMR2615/pcb/.gitignore A hardware/nRF54LM20_TMR2615/pcb/fabrication-toolkit-options.json M hardware/nRF54LM20_TMR2615/pcb/pcb.kicad_pcb M hardware/nRF54LM20_TMR2615/pcb/pcb.kicad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
2026-10-20 M hardware/nRF54LM20_TMR2615/layout_tools/border.py M hardware/nRF54LM20_TMR2615/layout_tools/placefp.py M hardware/nRF54LM20_TMR2615/pcb/pcb.kicad_pcb M hardware/nRF54LM20_TMR2615/pcb/pcb.kicad_prl 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
